pnpsystemsspzoo/Detekcja-i-lokalizacja-zk-ocen-RF/System_centralny_software/frontend_application/services/pdf/screenshot.jpeg

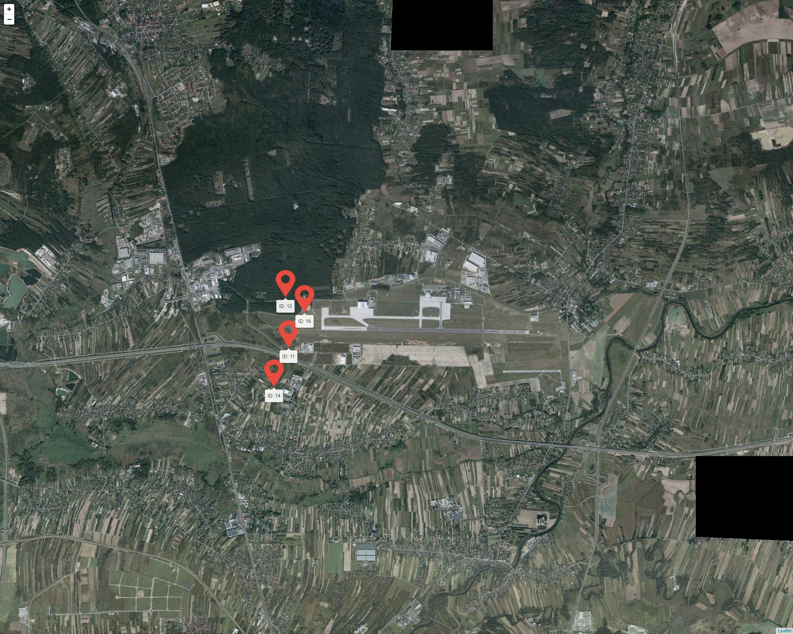
System_centralny_software/frontend_application/services/pdf/screenshot.jpeg
