pnpsystemsspzoo/Detekcja-i-lokalizacja-zk-ocen-RF/Dokumentacja/Etap_2/D_TN_model_sondy.pdf

# System detekcji, monitoringu, lokalizacji i wspomagania eliminacji zakłóceń radiowych w wybranych pasmach częstotliwości (RNSS i telekomunikacyjnych)

współfinansowany ze środków Europejskiego Funduszu Rozwoju Regionalnego realizowanego w ramach Działania 1.1. Projekty B+R przedsiębiorstw Programu Operacyjnego Inteligentny Rozwój 2014-2020

Numer umowy: POIR.01.01.01-00-0894/17

## D_TN_model_sondy

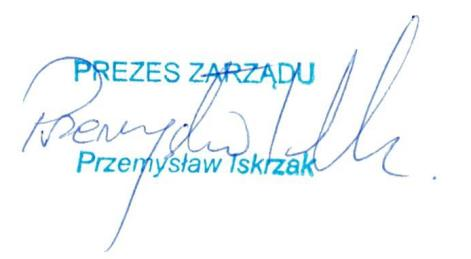
[picture p10: figure]

L.p. | Wersja | Data | Opis
1 | 0.1 | 01.10.2020 | Wersja inicjalna dokumentu
2 | 0.2 | 23.11.2020 | Diagnoza widmowa urządzenia
3 | 0.3 | 11.01.2021 | Poprawki
4 | 1.0 | 14.02.2021 | Poprawki, formatowanie

## Spis treści

Płyta bazowa | 3
OPIS OGÓLNY | 3
KOMUNIKACJA Z MODUŁAMI RADIOWYMI | 4
SEKWENCJA URUCHOMIENIA KOMUNIKACJI PŁYTY BAZOWEJ Z KARTĄ RADIOWĄ | 7
OPTYCZNE TESTY JAKOŚCIOWE | 10
Karty radiowe | 11
KARTA ILS | 12
KARTA TETRA | 16
KARTA L1 | 19

## Płyta bazowa

### Opis ogólny

Płyta bazowa jest komponentem logicznym urządzenia (sondy) zajmującym się przetwarzaniem i danych odebranych z kart radiowych i przesyłaniem danych przetworzonych do systemu centralnego. Płyta bazowa oparta została o procesor FPGA Xilinx model XCZU4CG-1FBVB900E (FPGA z ang. Field Programmable Gate Arrays). Procesor ten zapewnia 16-sto kanałowe połączenia szeregowe bardzo wysokiej przepustowości, wymagane do obsługi przetworników analogowo-cyfrowych (ADC) oraz łącz światłowodowych. Cztery szybkie kanały komunikacyjne (z ang. transceivers) wykorzystane są do obsługi standardu SFP komunikacji światłowodowej, pozostałe służą połączeniom przetworników ADC kart radiowych z procesorem FPGA. Procesor płyty bazowej posiada zintegrowany procesor aplikacyjny produkcji ARM z rodziny Cortex-A53. Procesor ten obsługiwany jest przez system operacyjny Linux i kontroluje komunikację z systemem centralnym, urządzenia peryferyjne, w tym nastawy zegarów referencyjnych, pamięci (RAM, flash), łącza komunikacyjne i serwisowe.

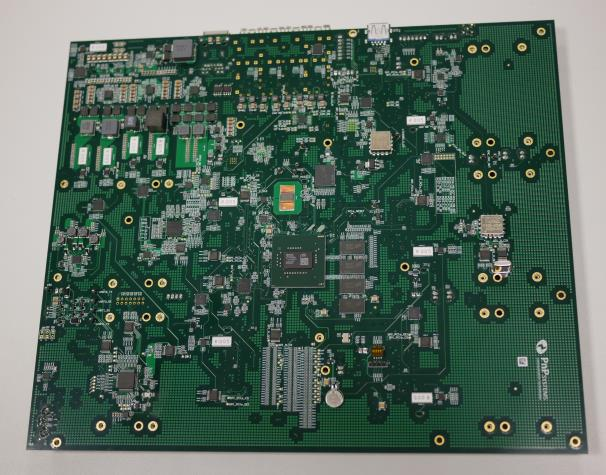
[picture p11: figure]

Rys 1: Płyta bazowa urządzenia do detekcji sygnałów zakłócających. Model demonstracyjny z obsługą dołączanych modułowo kart radiowych.

### Komunikacja z modułami radiowymi

Moduły radiowe sondy łączą się z płytą bazową za pomocą szybkiego protokołu JESD204B. Procesor FPGA płyty bazowej zaprogramowany jest za pomocą logicznego bloku konfigurującego tryb pracy szyny komunikacyjnej procesora do kart radiowych.

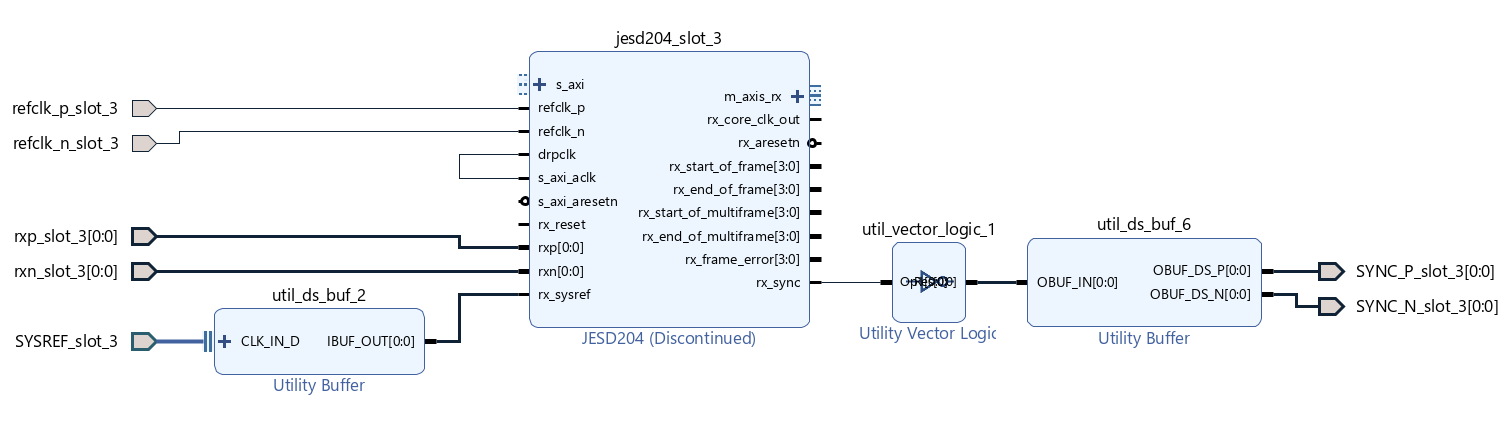
[picture p12: figure]

Rys 2: Blokowy kod procesora FPGA konfigurujący slot komunikacyjny pomiędzy procesorem a kartą radiową.
JESD204B jest trzecią generacją szeregowego interfejsu (po JESD204 i JESD204A) wykorzystywanego do komunikacji między układami logicznymi (FPGA), a przetwornikami (ADC oraz DAC) próbkującymi sygnał z częstotliwościami rzędu kilku GHz. Główne cechy:
- transmisja danych z prędkością do 12,5 Gb/s na każdą linię
- zredukowana ilość linii potrzebnych do przesłania informacji (w porównaniu do LVDS)
- brak konieczności dopasowywania długości linii danych

JEDS204B wykorzystuje kodowanie 8b/10b, co oznacza że w każdym 10-bitowym słowie znajduje się 8 bitów danych oraz 2 bity nadmiarowe. To kodowanie zapewnia, że nawet jeśli próbka składa się z samych "0" lub "1", to w przesyłanym słowie nadal znajduje się wystarczająca liczba przejść umożliwiająca odzyskanie przez odbiornik sygnału zegarowego, w takt którego przesyłane są informacje.
W nowoczesnych przetwornikach ze standardem JESD204B (także w AD9690 wykorzystywanych w MB) możliwe jest ustawienie ilości wykorzystywanych linii danych. Przykładowo: przesłanie 12-bitowej próbki może odbyć się za pośrednictwem jednej linii w formie dwóch 10-bitowych słów wysłanych jedno po drugim. Wybór ten wiąże się z koniecznością dwukrotnie większej szybkości transmisji, aniżeli w przypadku korzystania z 2 linii danych, gdzie oba słowa wysyłane są równolegle. Standard JESD204B zapewnia również możliwość dzielenia próbek na wiele oktetów i linii. Na przykład dwie 12 bitowe próbki mogą zostać przesłane w 3 słowach (3 oktet zawierający po 4 ostatnie bity próbek). Funkcja ta jest bardzo korzystna, gdy używa się przetworników o niższych rozdzielczościach, ale o bardzo wysokich częstotliwościach próbkowania. Dzięki temu możliwe jest maksymalne wykorzystanie linii danych.
Ponadto standard JESD204B wprowadził funkcję taktowania harmonicznego, która eliminuje potrzebę zapewnienia dokładnej częstotliwości sygnału DEVICE CLOCK każdemu urządzeniu w systemie. Oznacza to, że sygnał zegarowy może mieć wielokrotnie większą/mniejszą częstotliwość, która następnie jest dowolnie dzielona (albo mnożona) przez dzielniki znajdujące się wewnątrz układów.

JESD204B zawiera 3 różne podklasy (0, 1, 2), które wpływają na synchronizację układów. Przetworniki wykorzystywane w kartach radiowych (AD9690) wspierają 1 podklasę co oznacza, że do prawidłowej komunikacji konieczne są następujące połączenia: CLK, DATA, SYNC~ oraz SYSREF.
Podklasa 1 umożliwia wprowadzenie zdeterminowanego opóźnienia. Jest to czas jaki upływa od propagacji danych w przetworniku ADC do momentu pobrania próbek z bufora w układzie FPGA. Odbywa się to za pomocą sygnału SYSREF, który resetuje wszystkie wewnętrzne bloki w przetwornikach do znanego stanu. Dzięki temu wszystkie układy rozpoczynają pracę jednocześnie (ich wewnętrzne zegary są wyrównane w fazie). Aby to osiągnąć wymagane jest dopasowanie długości wszystkich linii SYSREF orac CLK, tak aby były jednakowe dla każdego układu. Przetworniki AD9690 umożliwiają ustawienie opóźnienia przybycia impulsu SYSREF jak i CLK, dzięki czemu zachowanie jednakowych długości linii nie jest konieczne. Warto zauważyć, że sygnał SYSREF powinien być pojedynczym impulsem lub przebiegiem okresowym. W przypadku tego drugiego, jego częstotliwość musi być całkowitą wielokrotnością sygnału LMFC (local multi-frame clock). Zaleca się, aby sygnał SYSREF był wyłączany po udanej synchronizacji, wtedy w przypadku ponownej utraty wyrównania linii (np. na skutek zmian temperatury), SYSREF jest ponownie uruchamiany.

Rys 3: Logiczny rozkład struktury informacji przesyłanej łączem z protokołem JESD204B

Kolejnym elementem umożliwiającym osiągnięcie deterministycznego opóźnienia jest "elastyczny bufor". Elastyczne bufory znajdują się w urządzeniach odbierających dane (FPGA albo DAC). Dzięki nim możliwe jest ustawienie momentu zwolnienia próbek przechowywanych w buforach. Moment ten jest ustawiany tak, aby nastąpił po dodarciu danych ze wszystkich linii (ze względu na różne długości linii danych, przesyłane informacje docierają w różnych momentach). W przypadku konieczności jednoczesnego opóźnienia dla kilku urządzeń, moment zwolnienia ustawiany jest względem układu, od którego próbki przyszły jako ostatnie.
W przypadku większych odległości (powyżej 20cm) między ADC a FBGA, sygnały ulegają zniekształceniom, które uniemożliwiają ich odczytanie. Aby temu zapobiec układy AD9690 posiadają funkcję "De-Emphasis", która polepsza parametry sygnału kosztem większego poboru mocy oraz większej emisji EMI. "De-Emphasis" należy używać tylko wtedy, gdy układ RX nie jest w stanie odczytać danych.

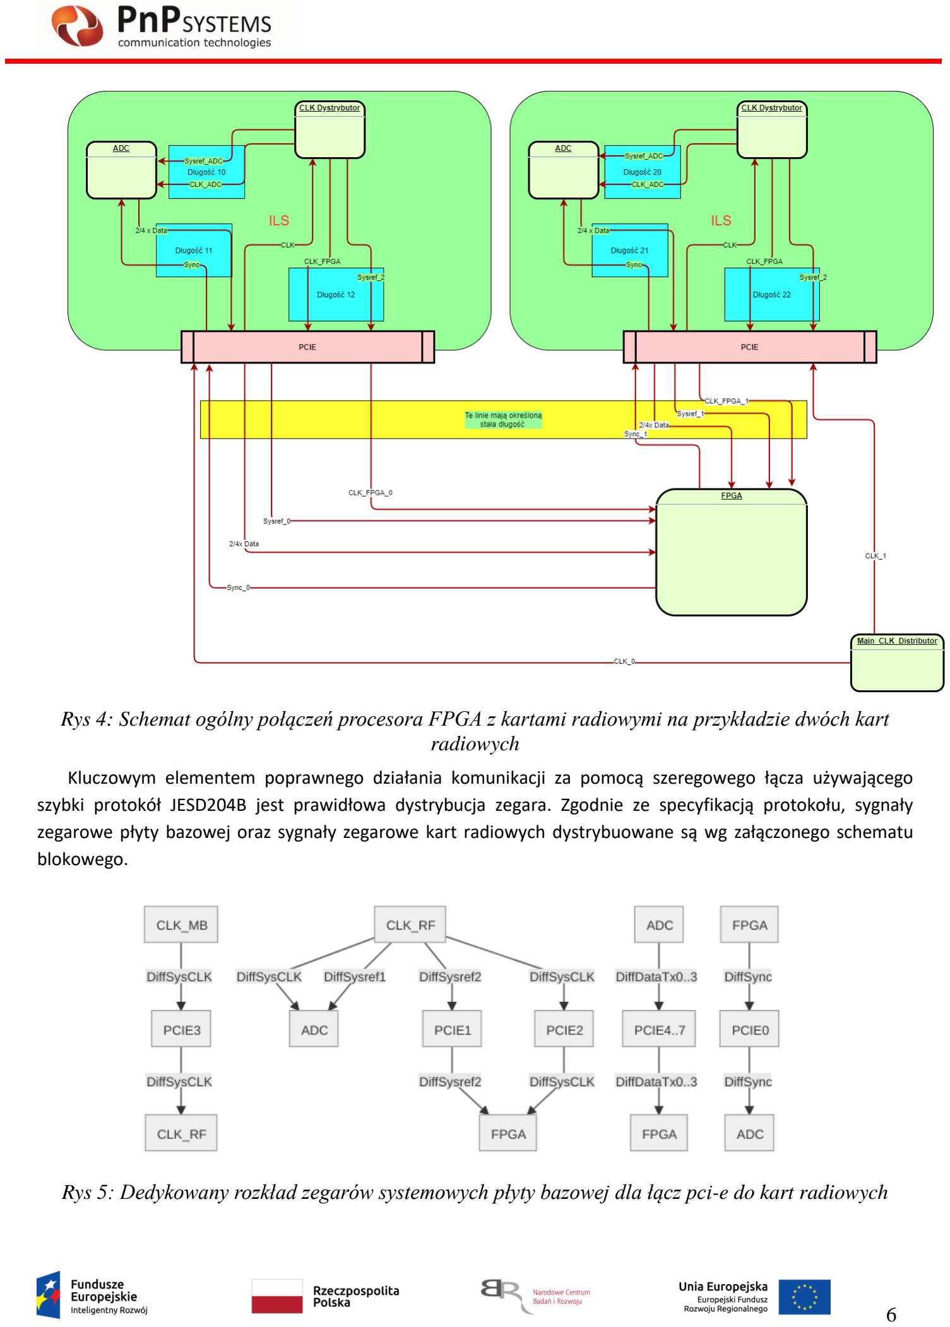
[picture p13: page 6]

Rys 4: Schemat ogólny połączeń procesora FPGA z kartami radiowymi na przykładzie dwóch kart radiowych
Kluczowym elementem poprawnego działania komunikacji za pomocą szeregowego łącza używającego szybki protokół JESD204B jest prawidłowa dystrybucja zegara. Zgodnie ze specyfikacją protokołu, sygnały zegarowe płyty bazowej oraz sygnały zegarowe kart radiowych dystrybuowane są wg załączonego schematu blokowego.

Rys 5: Dedykowany rozkład zegarów systemowych płyty bazowej dla łącz pci-e do kart radiowych

### Sekwencja uruchomienia komunikacji płyty bazowej z kartą radiową

Procesor Xilinx podlega zaprogramowaniu, zarówno na poziomie procesora aplikacyjnego, jak i procesora FPGA. Aby uzyskać prawidłowy przebieg sygnałów pomiędzy przetwornikami kart radiowych a procesorem Xilinx, należy przeprowadzić odpowiednią sekwencję uruchomiania procesora. Z zalecanych sposobów uruchomienia wybrany został ten, którego schemat przebiegu sekwencji przedstawiony jest poniżej.

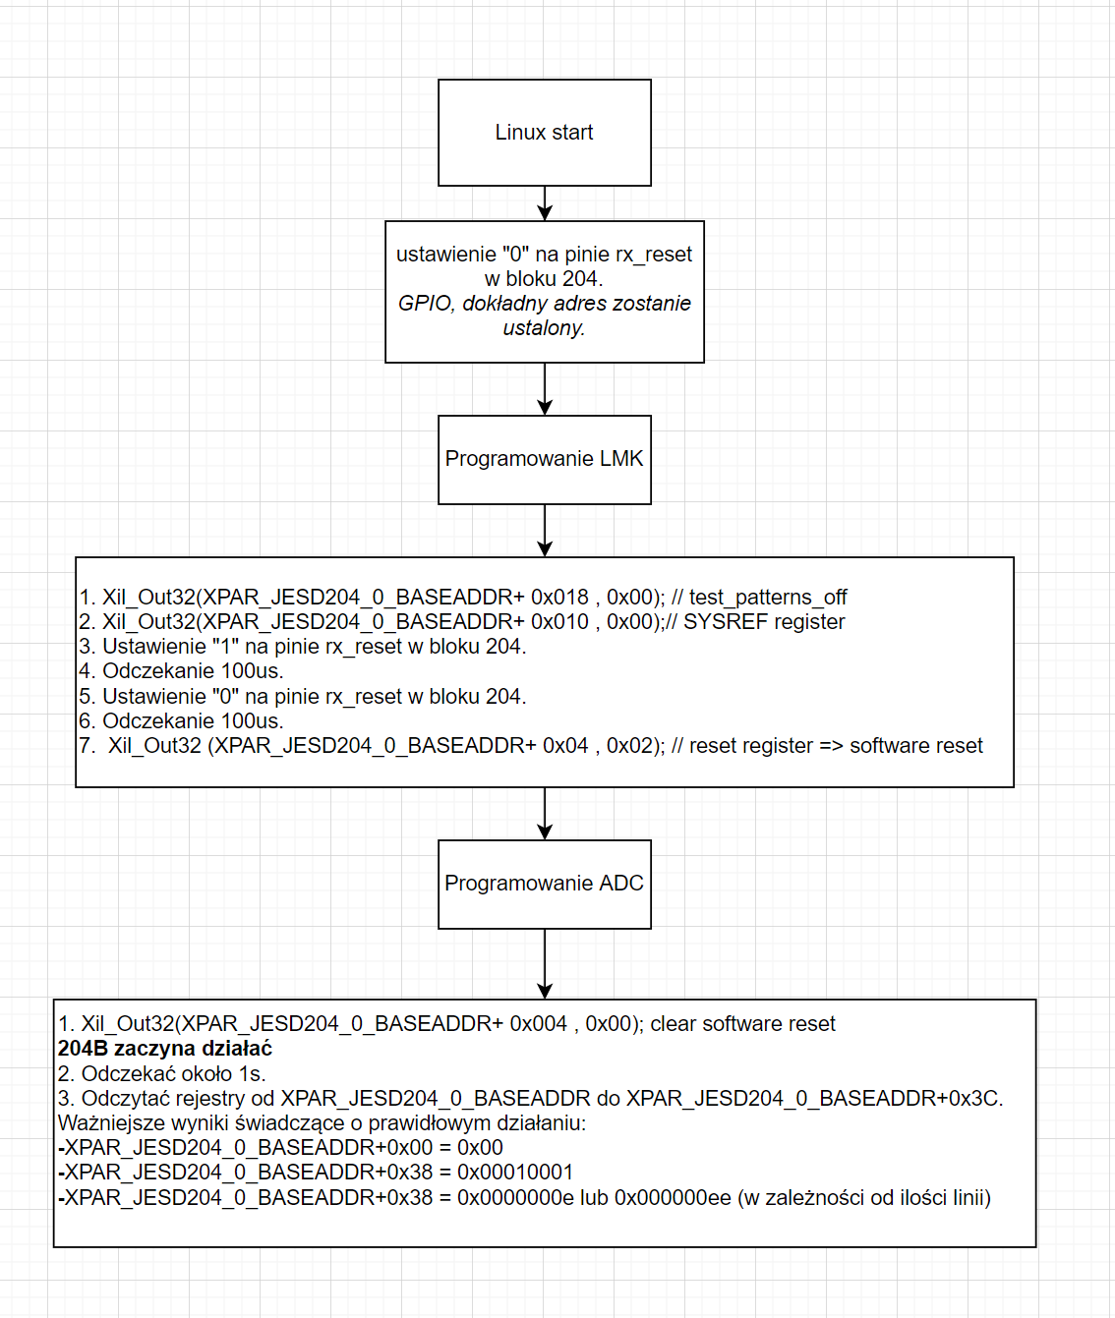
[picture p14: figure]

Rys 6: Schemat sekwencji uruchomiania łącza z protokołem JESD204B pomiędzy procesorem Xilinx a kartami radiowymi.
Parametry wpływające na częstotliwości poszczególnych linii:

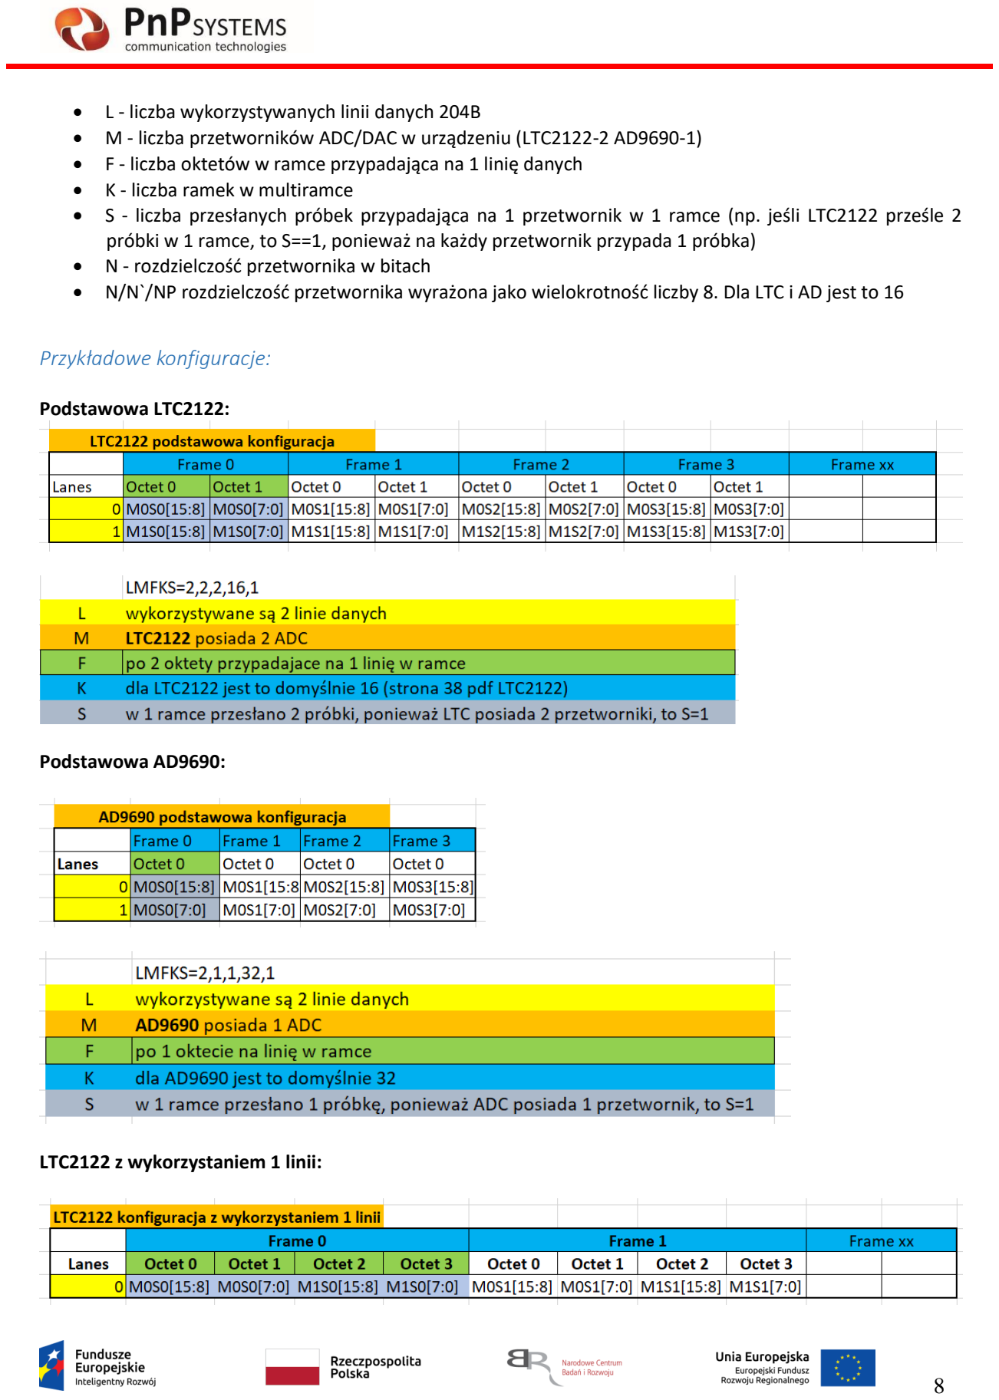
[picture p15: page 8]

- L - liczba wykorzystywanych linii danych 204B
- M - liczba przetworników ADC/DAC w urządzeniu (LTC2122-2 AD9690-1)
- F - liczba oktetów w ramce przypadająca na 1 linię danych
- K - liczba ramek w multiramce
- S - liczba przesłanych próbek przypadająca na 1 przetwornik w 1 ramce (np. jeśli LTC2122 prześle 2 próbki w 1 ramce, to S==1, ponieważ na każdy przetwornik przypada 1 próbka)
- N - rozdzielczość przetwornika w bitach
- N/N`/NP rozdzielczość przetwornika wyrażona jako wielokrotność liczby 8. Dla LTC i AD jest to 16

Przykładowe konfiguracje:

Podstawowa LTC2122:

Podstawowa AD9690:

LTC2122 z wykorzystaniem 1 linii:

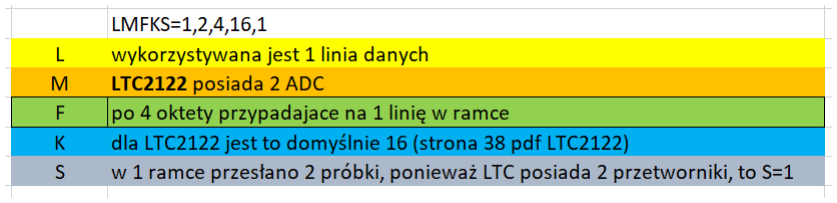
[picture p16: figure]

Częstotliwości poszczególnych zegarów
Nastawy częstotliwości poszczególnych zegarów są parametryzowane, tzn. częstotliwości te zależą, oprócz wcześniej wymienionych parametrów L, M, F, S, i K, od takich parametrów, jak: częstotliwość próbkowania fs, liczbę f oktetów w ramce przypadających na jedną linię danych, oraz współczynnik ograniczenia SYSREFmax. Przykładowe nastawy wyliczane są wg podanego zestawu wzorów, prezentowanych poniżej. Obliczenia przeprowadzono dla AD9690 w konfiguracji LMFKS= 2,1,1,32,1 o częstotliwości próbkowania 500MHz
- wyznaczenie frame clock`a

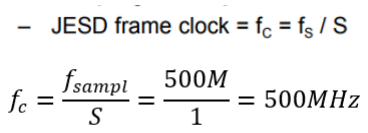
[picture p17: figure]

- wyznaczenie Lane Rate, litera f oznacza liczbę oktetów w ramce przypadająca na 1 linię danych.
- wyznaczenie LMFC (local multiframe clock)
- wyznaczenie SYSREF`a na ten sygnał nałożone są następujące ograniczenia:

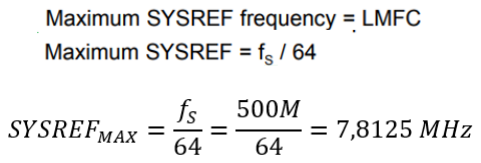
[picture p18: figure]

Dla optymalnej pracy zalecane jest zmniejszenie często z następującego wzoru:

gdzie LCM to najmniejsza wspólna wielokrotność liczby 64 oraz 20K. W przypadku AD9690 LCM(64,2032)=640

### Optyczne testy jakościowe

Przed uruchomieniem płyty bazowej przeprowadzono testy optyczne, których wynik końcowy był pozytywny. Testy przeprowadzone przy pomocy kamery z regulowanym powiększeniem optycznym. Punkty lutowania wymagające dokładnego sprawdzenia prezentowane są poniżej;

Układ ADP1850 | zewnętrzne części padów nie są oblane cyną; poprawiono

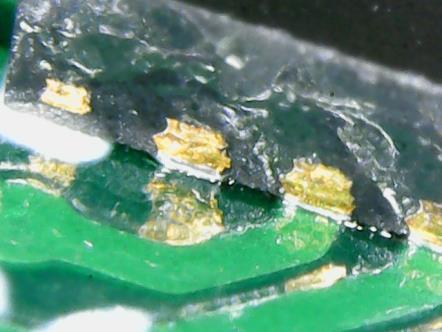
[picture p19: figure]

Układ ADP1741 | zewnętrzne części padów nie są oblane cyną; poprawiono

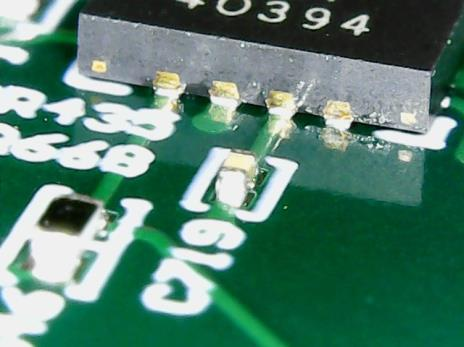
[picture p20: figure]

Układ MCP1727P | zewnętrzne części padów nie są oblane cyną; poprawiono

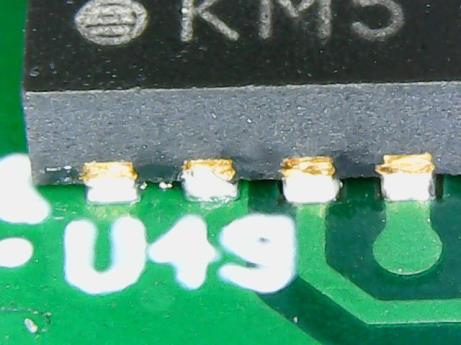
[picture p21: figure]

Układ LTC6952 | układ uniósł się na cynie wylanej pod układem; poprawiono

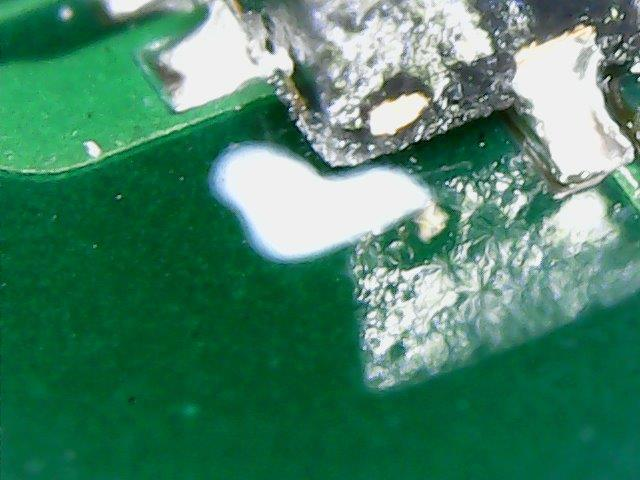
[picture p22: figure]

Układ max17557 | układ uniósł się na cynie wylanej pod układem; poprawiono

## Karty radiowe

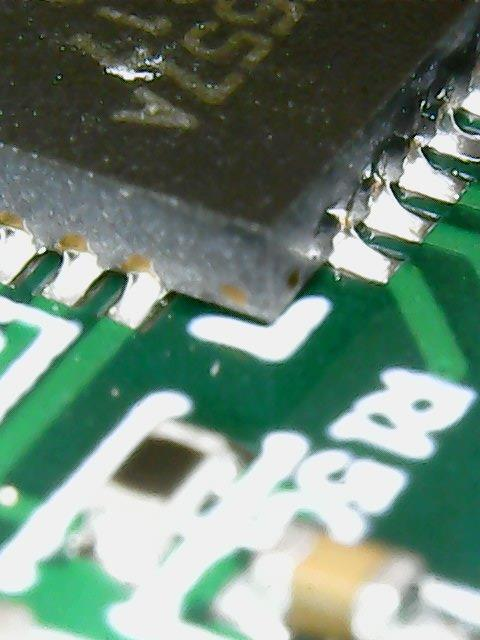
[picture p23: figure]

Karty radiowe przygotowane zostały do odbierania czterech wybranych pasm radiowych przydzielonych trzem systemom radiowym: ILS na częstotliwościach nośnej 110 MHz i 333 MHz, TETRA na 440 MHz oraz GNSS L1 na częstotliwości nośnej 1575,42 MHz. Przydzielone tym torom filtry posiadają bardzo wysoki stopień dobroci, przez co bardzo tłumią moce na częstotliwościach pozapasmowych. Zapewnia to znakomitą separację od pasma pobocznych i zapobiega wnikaniu dodatkowej mocy, mogącej zakłócić proces detekcji zakłócenia.

Tabela 1: Tłumienia filtrów w torach radiowych kart sondy

pasmo | system | Tłumienie w torze | Tłumienie poza torem
108 – 112 MHz | ILS | 6,8 dB | 38 dB
283 – 383 MHz | ILS | 11 dB | 43 dB
410 – 430 MHz | TETRA | 3 dB | 40 dB
1530 – 1610 MHz | GNSS L1 | 3,6 dB | 24 dB

Zaprojektowane karty radiowe mają ten sam interfejs do płyty bazowej oraz te same protokoły komunikacyjne. Różnicą jest dopasowanie toru radiowego do poszczególnych częstotliwości nośnych, przetworniki dopasowane do różnych szerokości pasma oraz konfiguracja ustawień płyty radiowej. Poniższe zdjęcie prezentuje karty.

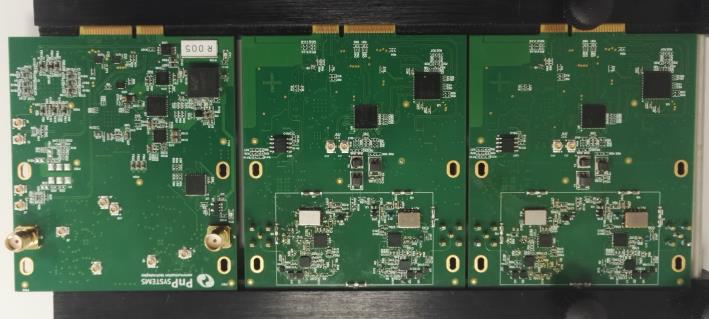
[picture p24: figure]

Rys 7: Rodzina kart radiowych w wersji poprawionej, zunifikowanej pod kątem połączenia z płytą bazową

### Karta ILS

Karta ILS posiada obsługę dwóch częstotliwości, 110 MHz i 333 MHz.
Tor radiowy dla systemu ILS zaprojektowany został tak aby możliwe było przetwarzanie sygnału przez przetwornika ADC.
Kluczowe parametry dla których został zaprojektowany tor ILS 110 MHz to:
- maksymalna moc dopuszczalna na ADC,
- punkt kompresji dla każdego z elementów toru,
- selektywność.

Ograniczenia mocy na torze dopasowywane są za pomocą elementów o stałych parametrach ( diody PIN ) oraz zmiennych parametrach (tłumik ACG).

Schemat blokowy
Schemat blokowy przedstawiony poniżej składowe elementy tory radiowego 110 MHz.

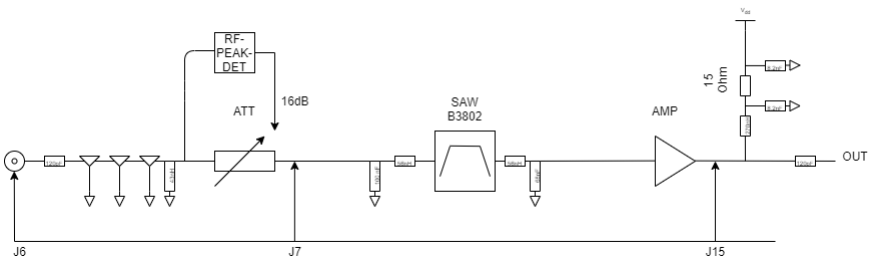
[picture p25: figure]

Rys 8: Schemat blokowy toru radiowego 110 MHz

Bardzo podobny jest tor radiowy dla częstotliwości 333 MHz.

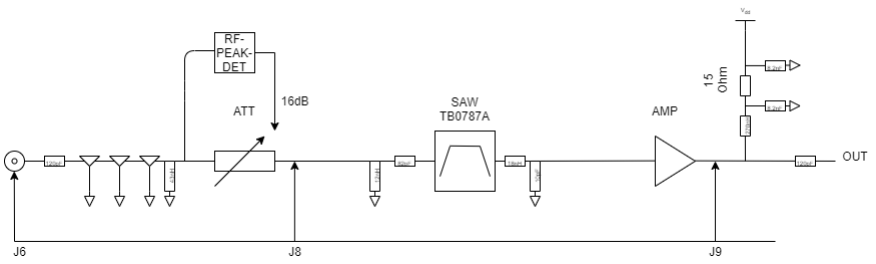
[picture p26: figure]

Rys 9: Schemat blokowy toru radiowego 333 MHz

Aby umożliwić prawidłową pracę tej karty radiowej, następujące ustawienia zegarów dla protokołu JESD204B powinny być ustawione
Dobranie odpowiedniej częstotliwości dla ADC oraz FPGA wiąże się z uwzględnieniem zakresów częstotliwości dostępnych dla ADC, FPGA oraz częstotliwości dla których w przetwarzanym sygnale nie pojawią się zakłócenia związane ze składowymi wyższych harmonicznych.
Na poniższym zrzucie ekranu przedstawiono prawidłowe ustawienia transmisji sygnału dla protokołu JESD204B z wybranym przetwornikiem LTC2122 (fc-max = 170 MHz) oraz FPGA gdzie częstotliwość CLK musi być większy niż Fc/2 (większy niż 80MHz).

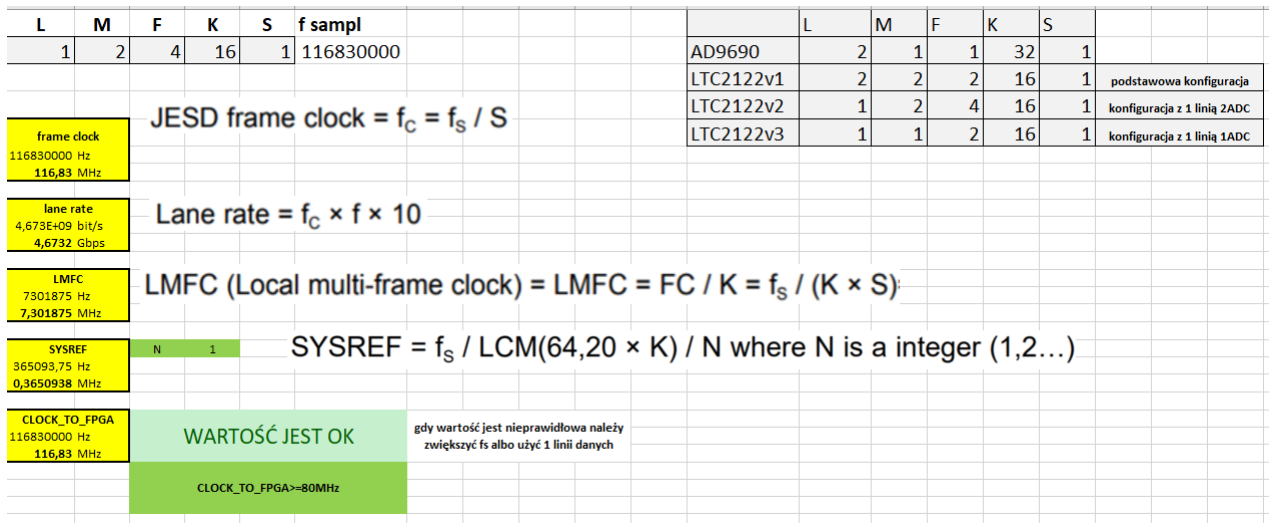
[picture p27: figure]

Rys 10: Kalkulator przeliczeń wartości częstotliwości poszczególnych linii przetworników. Ustawienia dla tej konfiguracji to:

- L(liczba torów danych) - 1;
- M(liczba wewnętrznych przetworników LTC2122) - 2;
- F(liczba oktetów w ramce na jedną linie danych) - 4;
- K(liczba ramek w mulitramce) - 16;
- S(liczba przesłanych próbek przypadająca na 1 przetwornik w 1 ramce) - 1;

Z poniższych zależności ustalono częstotliwość Fs (Fc) dla LTC2122 - 116,30 MHz. Pozwoli ona obsłużyć dwa wejścia analogowe w konfiguracji dla przetwarzania częstotliwości RF 110 MHz oraz 330 MHz.
Sysref powinien mieć wartość 0,36509 MHz.
Zegar CLK (dla protokołu JESD204B) powinien mieć wartość 116,3 MHz. Jest to częstotliwość minimalna, wobec czego należy mieć na uwadze zmianę konfiguracji systemu w przypadku gdyby protokół JESD204B nie działał prawidłowo.
Według wymagań układów dla JESD204b oraz prawidłowego próbkowania ADC, na dystrybutorze ustawiono następujące częstotliwości:
1. Wyjście testowe - częstotliwość testowa 0,5 MHz - wyłączona
2. Wyjście SYSREF dla FPGA - 0,36509 MHz
3. Wyjście CLK dla FPGA - 116,3 MHz
4. Wyjście SYSREF dla ADC - 0,36509 MHz
5. Wyjście CLK dla ADC - 116,3 MHz

LMK04610 skonfigurowany został w trybie z drugą pętlą PLL oraz bez lokalnego oscylatora.
Sygnał wejściowy zadawany ze płyty macierzystej (domyślnie MB lub ZCU) powinien być generowany o częstotliwości 62,5 MHz o wypełnieniu 50% w trybie differential.

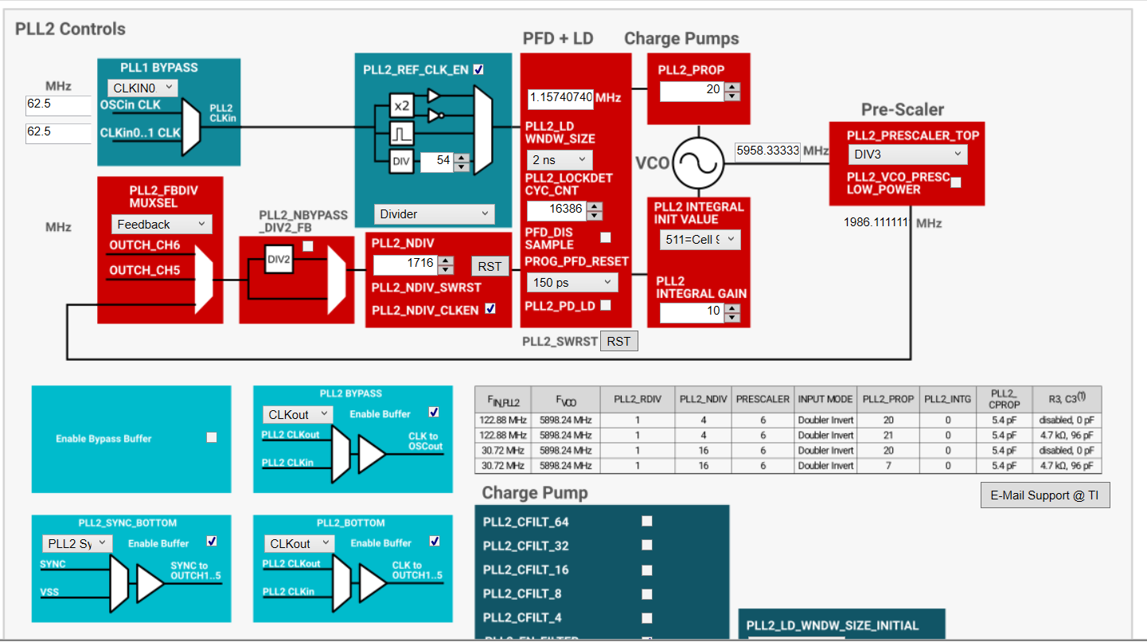
[picture p28: figure]

Rys 11: Konfigurator częstotliwości zegara dystrybutora LMK04610 Ustawienia te pozwalają przy ustawieniach LTC2122 ( L=1,M=2,F=4,K=16,S=1) uzyskać przepustowość linii danych LTC2122 na poziomie 4,6756 Gbps.
Ustawienia wyjść w TICS Pro:
- CLKOUT1 Test - 0,5 MHz - wyłączone
- CLKOUT3 SYSREF FPGA - 0,36509 MHz
- CLKOUT5 INV CLK FPGA - 116,83 MHz
- CLKOUT8 INV SYSREF ADC - 0,36509 MHz
- CLKOUT10 CLK ADC - 116,83 MHz
Nie używane wyjścia należy ustawić w tryb Power-Down, tak aby jak najbardziej zminimalizować pobór energii oraz przenoszenie zakłóceń.
Obliczenia częstotliwości harmonicznych
Aby przetwornik cyfrowo-analogowy nie wtrącał częstotliwości harmonicznych spoza pasma, co może zachodzić przy filtrze zbyt szeroko-pasmowym w stosunku do pasma użytecznego, przeanalizowano możliwe częstotliwości pracy przetwornika na częstotliwościach 110 MHz i 333 MHz. Z poniższych obliczeń pobrane były wartości częstotliwości pracy przetworników.
W przypadku toru dla 110 MHz, ustawienie częstotliwości ADC na 116,89 MHz powoduje, że żadna harmoniczna poniżej 10-tej nie zostanie wtrącona do pasma przepustowego filtra. Obrazuje to kalkulator na kolejnym rysunku.

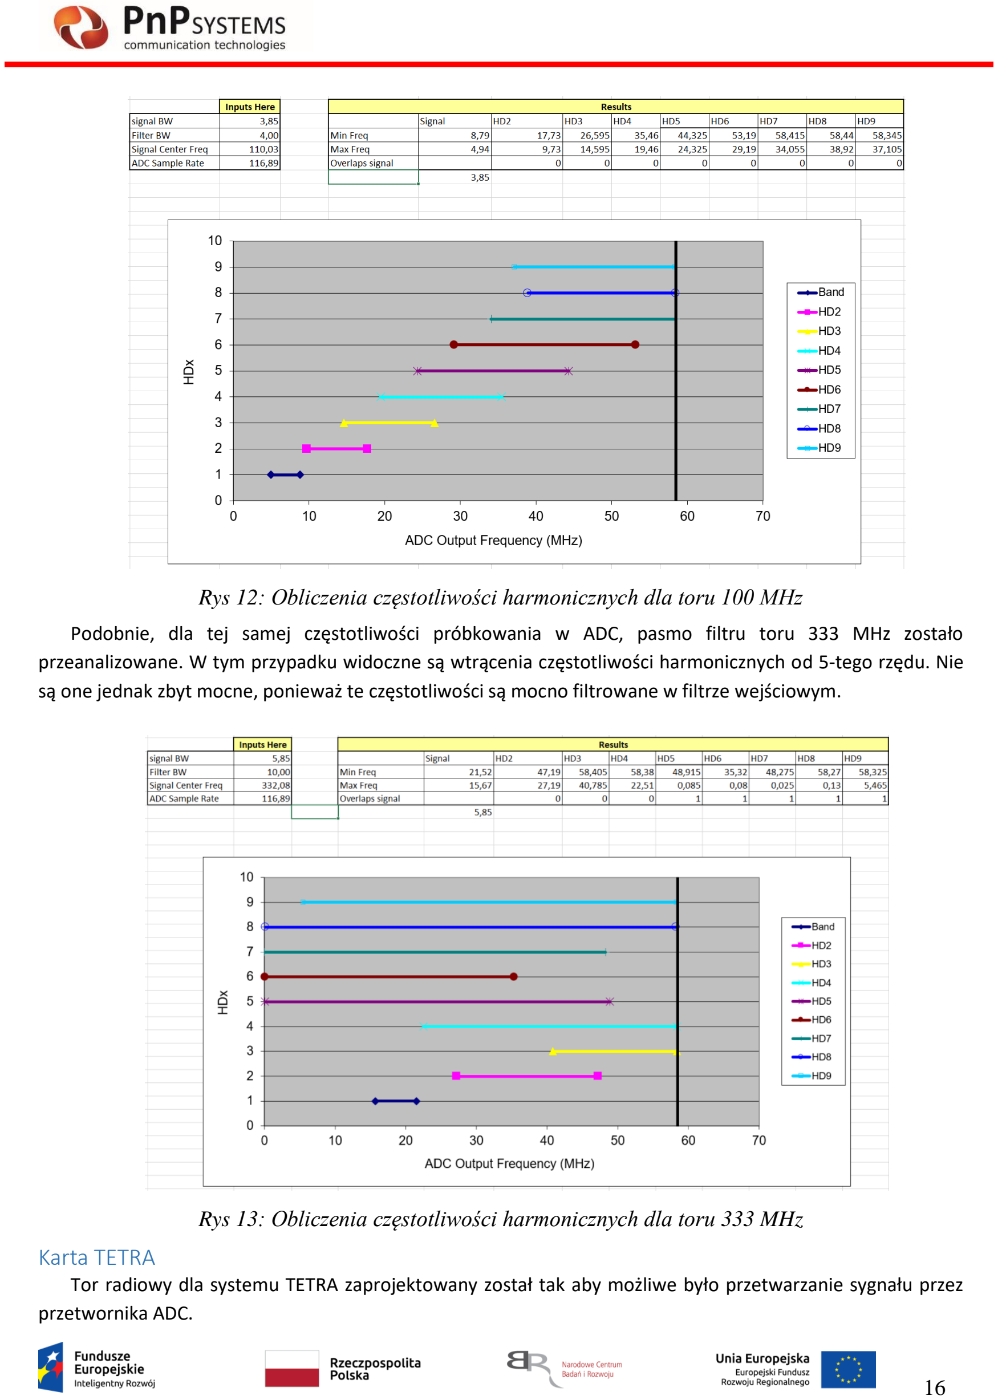
[picture p29: page 16]

Rys 12: Obliczenia częstotliwości harmonicznych dla toru 100 MHz Podobnie, dla tej samej częstotliwości próbkowania w ADC, pasmo filtru toru 333 MHz zostało przeanalizowane. W tym przypadku widoczne są wtrącenia częstotliwości harmonicznych od 5-tego rzędu. Nie są one jednak zbyt mocne, ponieważ te częstotliwości są mocno filtrowane w filtrze wejściowym.

Rys 13: Obliczenia częstotliwości harmonicznych dla toru 333 MHz

### Karta TETRA

Tor radiowy dla systemu TETRA zaprojektowany został tak aby możliwe było przetwarzanie sygnału przez przetwornika ADC.

Kluczowe parametry dla których został zaprojektowany tor TETRA 420 MHz to:
- maksymalna moc dopuszczalna na ADC,
- punkt kompresji dla każdego z elementów toru,
- selektywność.

Ograniczenia mocy na torze dopasowywane są za pomocą elementów o stałych parametrach ( diody PIN ) oraz zmiennych parametrach (tłumik ACG).

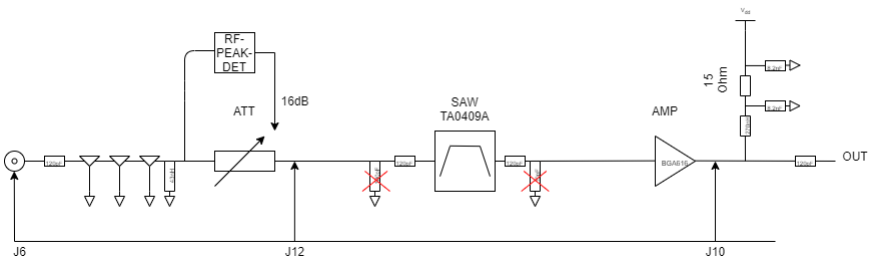
[picture p30: figure]

Rys 14: Schemat blokowy toru radiowego 420 MHz

Podobnie, jak dla torów karty na pasma ILS, konstrukcja toru radiowego z dystrybutorem LMK04610 została przeanalizowana pod kątem odbioru sygnałów harmonicznych.
Ustawienia zostały przygotowane poprzez program TICS Pro od TI.
Wymagania odnośnie częstotliwości dla ADC. Optymalne ustawienie oraz wpływ harmonicznych przedstawiono poniżej.

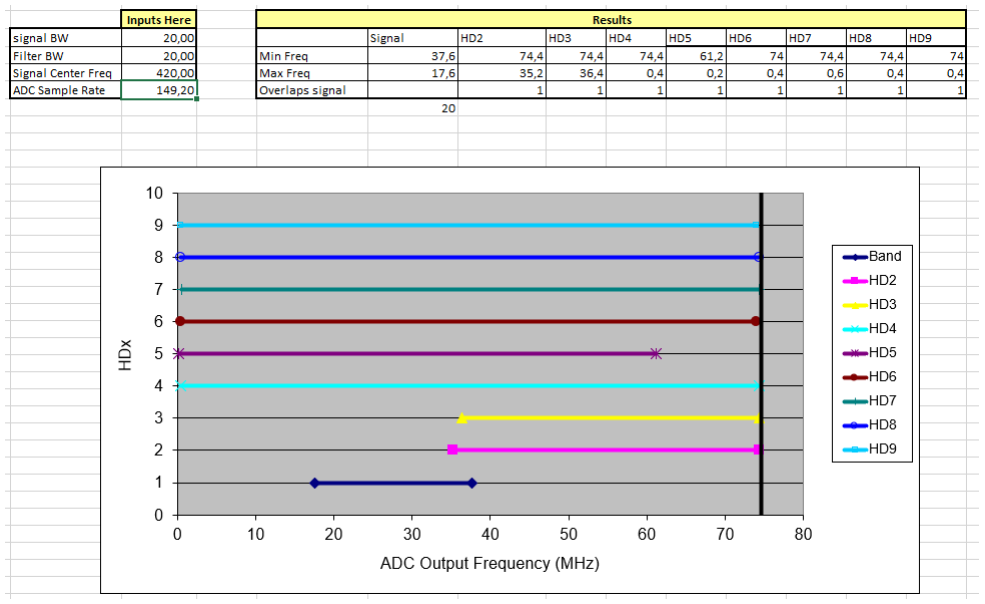
[picture p31: figure]

Rys 15: Obliczenia częstotliwości harmonicznych dla toru 420 MHz

Dla dobranego filtra, udało się niemal wszystkie harmoniczne, do rzędu 3-ciego włącznie, wyeliminować z pasma użytecznego.
Ustawienia zegarów dla protokołu JESD204B
Dobranie odpowiedniej częstotliwości dla ADC oraz FPGA wiąże się z uwzględnieniem zakresów częstotliwości dostępnych dla ADC, FPGA oraz częstotliwości dla których w przetwarzanym sygnale nie pojawią się zakłócenia związane ze składowymi wyższych harmonicznych.
Na poniższym zrzucie ekranu przedstawiono prawidłowe ustawienia transmisji sygnału dla protokołu JESD204B z wybranym przetwornikiem LTC2122 (fc-max = 170 MHz) oraz FPGA gdzie częstotliwość CLK musi być większy niż Fc/2 (większy niż 80MHz).

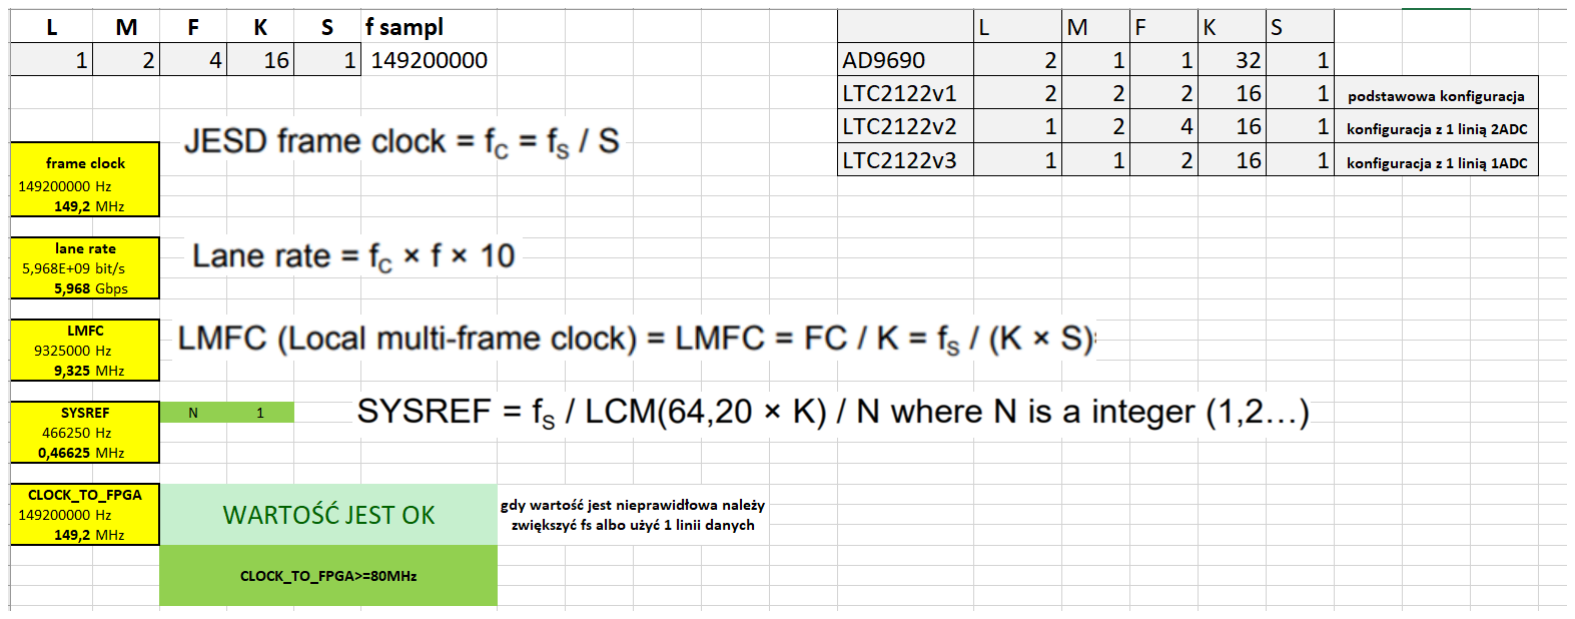
[picture p32: figure]

Rys 16: Kalkulacje wartości częstotliwości poszczególnych linii przetwornikóww dla karty radiowej na pasmo 420 MHz
Ustawienia dla tej konfiguracji to:
- L(liczba torów danych) - 1;
- M(liczba wewnętrznych przetworników LTC2122) - 2;
- F(liczba oktetów w ramce na jedną linie danych) - 4;
- K(liczba ramek w mulitramce) - 16;
- S(liczba przesłanych próbek przypadająca na 1 przetwornik w 1 ramce) - 1;

Według wymagań układów dla JESD204b oraz prawidłowego próbkowania ADC, na dystrybutorze ustawiono następujące częstotliwości:
- Wyjście testowe - częstotliwość testowa 19,2 MHz
- Wyjście SYSREF dla FPGA - 0,46625 MHz
- Wyjście CLK dla FPGA - 149,2 MHz
- Wyjście SYSREF dla ADC - 0,46625 MHz
- Wyjście CK dla ADC - 149,2 MHz

Ustawienia te pozwalają przy ustawieniach LTC2122 ( L=1,M=2,F=4,K=16,S=1) uzyskać przepustowość linii danych LTC2122 na poziomie 5,968 Gbps.
LMK04610 skonfigurowany został w trybie z drugą pętlą PLL oraz bez lokalnego oscylatora.

Sygnał wejściowy zadawany ze płyty macierzystej (domyślnie MB lub ZCU) powinien być generowany o częstotliwości 62,5 MHz o wypełnieniu 50% w trybie differential.

### Karta L1

Schemat blokowy i zasady działania karty radiowej na paśmie L1 jest bardzo zbliżona do tych, prezentowanych dla torów ILS i TETRA.
W przypadku toru pasma L1 na częstotliwości 1575,42 MHz, ustawienie częstotliwości ADC na 496,3 MHz, filtru i danym paśmie przepustowości, osiągnięto również niemal sygnał wolny od harmonicznych powyżej stopnia 3-ego.

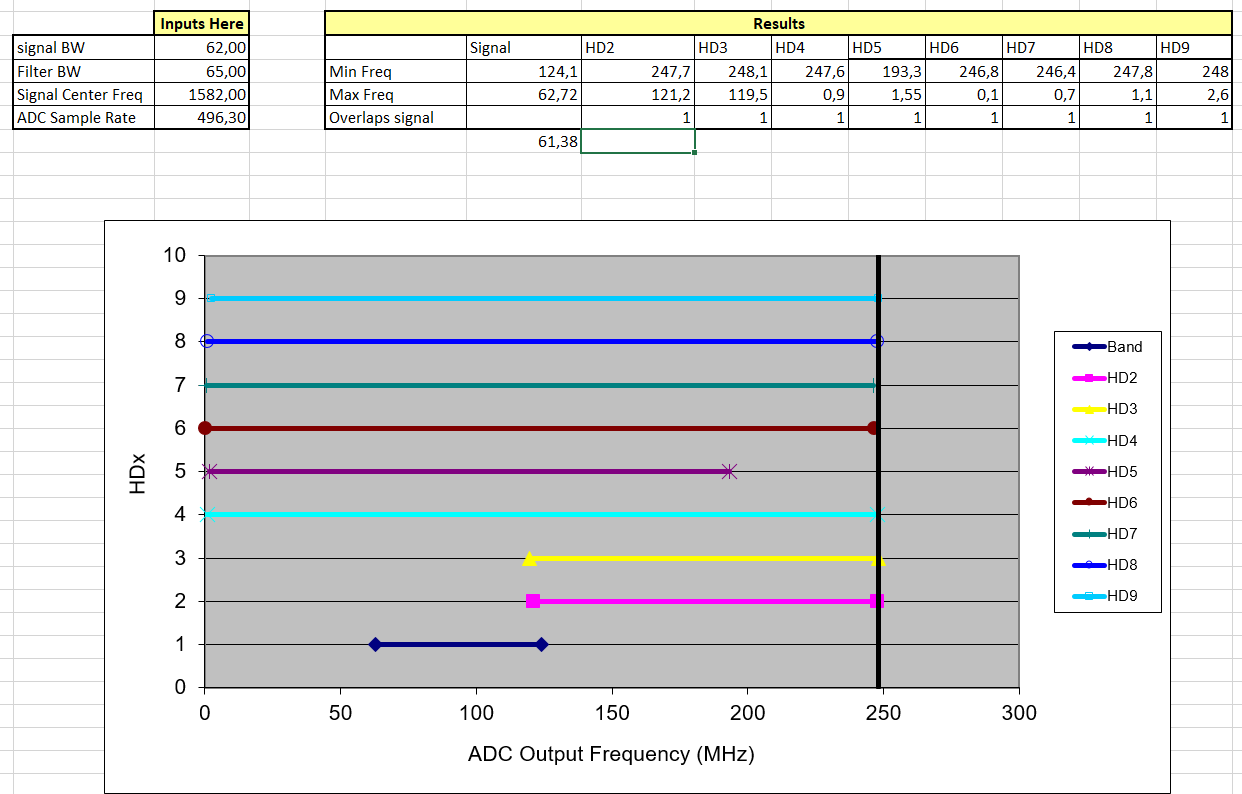
[picture p33: figure]

Rys 17: Obliczenia częstotliwości harmonicznych dla toru 1575,42 MHz

Należy podkreślić, że urządzenie jest programowalne z trybu serwisanta sondy. Zatem, jeśli przyjdzie taka potrzeba, będzie możliwość przeprogramowania urządzenia w ramach specyfikacji sprzętowych.

Koniec dokumentu
