pnpsystemsspzoo/Detekcja-i-lokalizacja-zk-ocen-RF/Sonda_hardware/Karta_GNSS_L1/LTC6952 napięcia.PNG

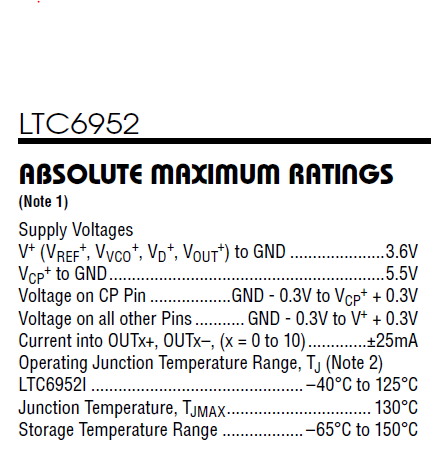
Sonda_hardware/Karta_GNSS_L1/LTC6952 napięcia.PNG
