pnpsystemsspzoo/Detekcja-i-lokalizacja-zk-ocen-RF/System_centralny_software/frontend_application/screenshoterror.jpg

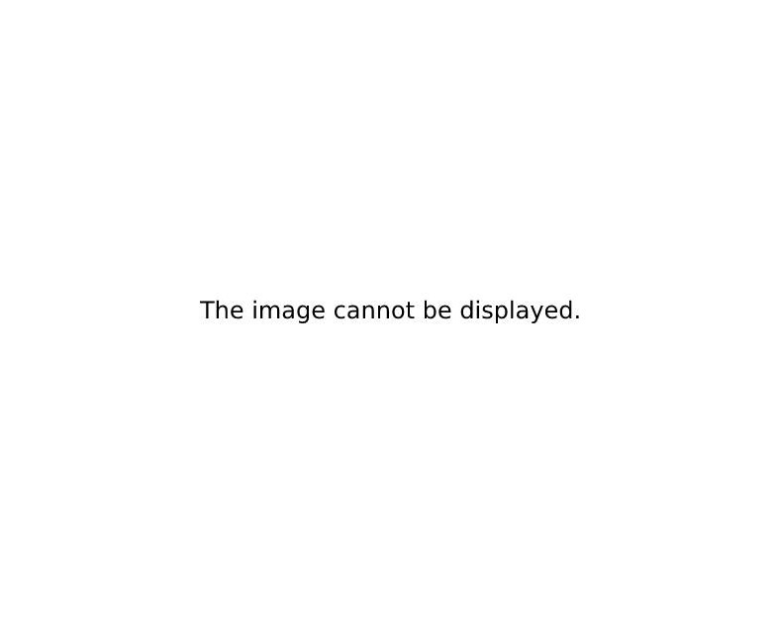
System_centralny_software/frontend_application/screenshoterror.jpg
