pnpsystemsspzoo/Detekcja-i-lokalizacja-zk-ocen-RF/System_centralny_software/frontend_application/source/src/assets/checked.png

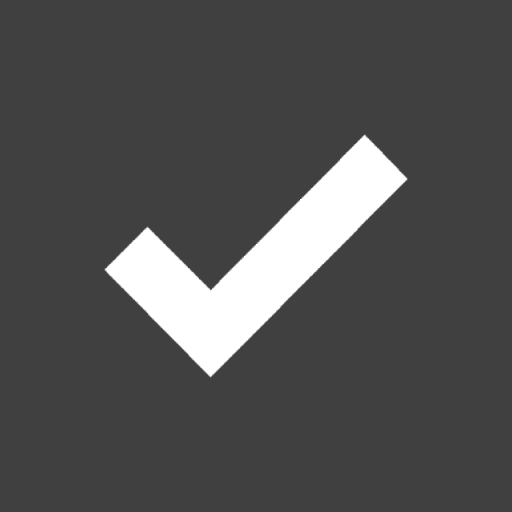
System_centralny_software/frontend_application/source/src/assets/checked.png
