pnpsystemsspzoo/Detekcja-i-lokalizacja-zk-ocen-RF/Dane_badawcze/Sonda_testy/Testy_MB1.xlsx

Sheet: MB1
**Lp.** | **Opis zagadnienia** | **Wynik** | **ilość godzin** | **Szacowana data zakończenia testów** | **Data zakończenia testów** | dodatkowe godziny | dni | dni dodatkowe | suma | data zakończenia | dni programistów
1 | [ Optyczny test ułożenia układów](Struktura-testowania-sprzętu/Test-optyczny-MB1_T1) | {+ OK +} | 08e | 2020-12-29 | 2020-12-29 | 8 | 1 | 1 | 2 | 2020-12-29 | 0 | 2021-01-02
2 | [Pomiar rezystancji torów zasilających](Struktura-testowania-sprzętu/Pomiar-rezystancji-torów-zasilających-MB1) | {- BŁĄD -} | 24e | 2021-01-07 | 2021-01-07 | 32 | 3 | 4 | 7 | 2021-01-07 | 0 | 2021-01-02
3 | [Testy konfiguracji przetwornic zasilających](Struktura-testowania-sprzętu/Pomiary-rezystor%C3%B3w-przetwornic-MB1) | b.d. | 32e | 2021-01-13 |  |  | 4 | 0 | 4 | 2021-01-13 | 0 | 2021-01-02
4 | [Pomiary napięć i prądów zasilających, niezależnych](Struktura-testowania-sprzętu/Pomiary-napięć-i-prądów-MB1) | b.d. | 32e + 40p | 2021-01-19 |  |  | 4 | 0 | 4 | 2021-01-19 | 5 | 2021-01-08
5 | [Pomiary konfiguracji torów zasilających](Struktura-testowania-sprzętu/Pomiary-konfiguracji-zasilania-MB1) | b.d. | 08e | 2021-01-20 |  |  | 1 | 0 | 1 | 2021-01-20 | 0 | 2021-01-08
6 | Testy komunikacji z procesorem US+ | b.d. | 40e + {- 120p -} | 2021-01-27 |  |  | 5 | 0 | 5 | 2021-01-27 | 15 | 2021-01-29
7 | Testy komunikacji I2C | b.d. | 32e + 40p | 2021-02-02 |  |  | 4 | 0 | 4 | 2021-02-02 | 5 | 2021-02-05
8 | Pomiary napięć i prądów zasilających, zależnych | b.d. | 16e + 24p | 2021-02-04 |  |  | 2 | 0 | 2 | 2021-02-04 | 3 | 2021-02-10
9 | Pomiary napięć i prądów zasilających niezależnych pod obciążeniem częściowym | b.d. | 16e + 8p | 2021-02-08 |  |  | 2 | 0 | 2 | 2021-02-08 | 1 | 2021-02-11
10 | Testy komunikacji SPI | b.d. | 32e + 32p | 2021-02-12 |  |  | 4 | 0 | 4 | 2021-02-12 | 4 | 2021-02-17
11 | Pomiary dystrybucji zegarów | b.d. | 24e + 16p | 2021-02-17 |  |  | 3 | 0 | 3 | 2021-02-17 | 2 | 2021-02-19
12 | Obsługa pozostałych urządzeń peryferyjnych na komunikacjach SPI oraz I2C | b.d. | 32e + 40p | 2021-02-23 |  |  | 4 | 0 | 4 | 2021-02-23 | 5 | 2021-02-26
13 | Testy komunikacji szybkich | b.d. | 24e + {- 80p -} | 2021-02-26 |  |  | 3 | 0 | 3 | 2021-02-26 | 10 | 2021-03-12
 |  |  |  |  |  | suma | 40 | 5 | 45 |  | 50

Sheet: pomiar rez MB1
Punkt pomiarowy 1 | Punkt pomiarowy 2 | uwagi | pomiar [Ohm] | Pomiar reverse [Ohm] | dopuszczalne minimum [Ohm] | dopuszczalne maksimum [Ohm] | ocena | napięcie | ocena
P8 - Power1 _In | P7 - GND |  | 97,7k | 95,8k | 100.0 | - | {+ OK +}
P10 - Power2_In | P9 - GND |  | 97,8k | 96,6k | 100.0 | - | {+ OK +}
P11.1 - Battery_PWR | P11.2 - GND |  | 50,57k | 50,15k | 100.0 | - | {+ OK +}
D4.1 - V_POE+ | D4.2 - PGND |  | 55k | 55k | 100.0 | - | {+ OK +}
C6.1 - Vout_1_Selector | C6.1 - GND |  | >45k | >45k | 100.0 | - | {+ OK +}
C698.2 - CSN | C698.1 - PGND |  | >40k | >40k | 100.0 | - | {+ OK +}
C12.1 - Vout_2_Selector | C12.2 - GND |  | 1M | 1M | 100.0 | - | {+ OK +}
C769.1 - PWR_Out_20V | C769.2 - GND |  | 60k | 4M | 100.0 | - | {+ OK +} | 20
C366.2 - 085V@40A_INA | C366.1 - GND |  | 1,2R | 1,1R | 0.1 | 100000 | {+ OK +} | 0.85
C415.2 - Vout1_1 | C415.1 - GND |  | 420R | 381.0 | 10.0 | 100000 | {+ OK +} | 3.3 |  | i=u/r | 0.008661417323
C427.2 Vout2_1 | C427.1 - GND |  | 45,3R | 45,2R | 10.0 | 100000 | {+ OK +} | 1.2
C458.2 Vout1_2 | C458.1 - GND |  | 32k | 1M | 100.0 | 10M | {+ OK +} | 12
C470.2 - Vout2_2 | C470.1 GND |  | >3M | 4,5k | 100.0 | 10M | {+ OK +} | 5
C762.1 - US+_Vcc_PS_inFp | C762.2 GND | REG1 | 1,3R | 1,2R | 0.1 | 100000 | {+ OK +} | 0.85
C749.2 - 1V8@0.5A_ADC_filtered | C749.1 - GND | REG2 | 670R | 438R | 1.0 | 100000 | {+ OK +} | 1.8
C709.2 - 0V9@1A_REG3 | C709.1 - GND | REG3 | 39,3R | 53R | 1.0 | 100000 | {+ OK +} | 0.9
C760.1 - RAM_Vcc1V2 | C760.2 - GND | REG4 | 45R | 45R | 1.0 | 100000 | {+ OK +} | 1.2
C675.2 - 0V85@2A | C675.1 - GND | REG5 | 8,7k | 10k | 10.0 | 100000 | {+ OK +} | 0.85
C742.1 - ETH_VDDIO | C742.2 - GND | REG7 | 370R | 313R | 10.0 | 100000 | {+ OK +}
C756.2 - US+MGTVaccAux | C756.1 - GND | REG8 | 1,73k | 1,197k | 10.0 | 100000 | {+ OK +}
C754.2 - US+_Vcc_PS_DDR_504 | C754.1 - GND | REG9 | 3,82k | 1,47k | 10.0 | 100000 | {+ OK +}
C722.2 - RAM_DDR4_VTT | C722.1 - GND |  | 13,2k | 15,9k | 10.0 | 10M | {+ OK +} | 0.6
C551.2 - 2V5@1.5A | C551.1 - GND |  | 9,11k | 3,36k | 10.0 | 10M | {+ OK +} | 2.5
C490.2 - 1V8@1,5A | C490.1 - GND |  | 21,5k | 22,6k | 10.0 | 10M | {+ OK +} | 1.8
C513.2 - 1V0@1.5A | C513.1 - GND |  | 528R | 877R | 10.0 | 100000 | {+ OK +} | 1
L13.2 - ADP1741_3.6V | C355.1 - GND |  | 38,3k | 6,62k | 10.0 | - | {+ OK +} | 3.6
C565_5to3V3_1.2 - 3.3V_Stable_1 | C565_5to3V3_1.1 - AGND |  | 4,5k | 5M | 10.0 | 100000 | {+ OK +} | 3.3
C569.1 - 3.3V_LN_1 | C569.1 - AGND |  | 1M | 6k | 10.0 | 100000 | {+ OK +} | 3.3
C580.2 - 5V_LN | C580.1 AGND |  | 3,4k | 3,4k | 10.0 | 100000 | {+ OK +} | 5
C205.1 - 3.3V_Stable_2 | C205.2 - AGND |  | 22,5k | 32,3k | 10.0 | 100000 | {+ OK +} | 3.3
C713.2 - NetC713_2 | C713.1 - AGND |  | 4k | 4k | 10.0 | 100000 | {+ OK +} | 8
C791.2 - FTDI_VccIO | C791.1 - GND |  | 0,1R | 0,1R | 10.0 | 100000 | {- Zwarcie -} [Opis zagadnienia](http://192.168.10.3:82/pnpsystems/elektronicy/motherboard/issues/6) | 3.3
FB31.2 - FTDI_VBUS | FB32.2 _ FTDI_Sock_GND |  | 0,3R | 0,2R | 10.0 | 100000 | {- Zwarcie -} [Opis zagadnienia](http://192.168.10.3:82/pnpsystems/elektronicy/motherboard/issues/6) | 5
R448_U_Pomiar_pradu_napiecia_PCIe0.1 - 12V_PCIE0 |  |  | 1,4M | - | 100000.0 | - | {+ OK +} | 12
R448_U_Pomiar_pradu_napiecia_PCIe1.1 - 12V_PCIE1 |  |  | 1,42M | - | 100000.0 | - | {+ OK +} | 12
R448_U_Pomiar_pradu_napiecia_PCIe2.1 - 12V_PCIE2 |  |  | - | 1,4M | 100000.0 | - | {+ OK +} | 12
R448_U_Pomiar_pradu_napiecia_PCIe3.1 - 12V_PCIE3 |  |  | - | 1,4M | 100000.0 | - | {+ OK +} | 12
R448_U_Pomiar_pradu_napiecia_PCIe4.1 - 12V_PCIE4 |  |  | - | 1,4M | 100000.0 | - | {+ OK +} | 12
C332.1 3V3_NVMe | C332.2 - GND |  | 12M | 610k | 100000.0 | 10M | {+ OK +} | 3.3
Ponowne pomiary
C791.2 - FTDI_VccIO | C791.1 - GND |  | 227,1R | 227,2R | 10.0 | 100000 | {- Zwarcie -} [Opis zagadnienia](http://192.168.10.3:82/pnpsystems/elektronicy/motherboard/issues/6) | 3.3
FB31.2 - FTDI_VBUS | FB32.2 _ FTDI_Sock_GND |  | >12,5M | >2M | 10.0 | 100000 | {- Zwarcie -} [Opis zagadnienia](http://192.168.10.3:82/pnpsystems/elektronicy/motherboard/issues/6) | 5

Sheet: Pomiar Napięć i prądów MB1
Designator przetwornicy | Model | Oczekiwane napięcie na wyjściu | Zmierzone napięcie [V] | Dopuszczalne minimum [V] | Dopuszczalne maksimum [V] | Designator rezystora pomiarowego | Spadek napięciana rezystorze pomiarowym [V] | Opór rezystora pomiarowego | Wyliczony prąd [A] | Dopuszczalne maksimum [A] | wynik pomiarów | numer miernika | dodatkowe obliczenia dla przetwornic LDO |  |  |  | Maksymalna moc na obudowie | temperatura obudowy | dopuszczalny błąd
U34 | ADP1850ACPZ-R7 | 0.85 |  | 0.833 | 0.867 | R617 |  | 0.04 |  | 40 |  |  | Vin [V] | Vout [V] | prąd [A] | ciepło [W] |  |  | 0.02
U37.1 | ADP1850ACPZ-R7 | 3.3 |  | 3.234 | 3.366 | R448_U_Pomiar_pradu_napiecia_3 |  | 0.05 |  | 14 |  | 3
U37.2 |  | 1.2 |  | 1.176 | 1.224 | R448_U_Pomiar_pradu_napiecia_4 |  | 0.05 |  | 15 |  | 4
U38.1 | ADP1850ACPZ-R7 | 12 |  | 11.76 | 12.24 | R448_U_Pomiar_pradu_napiecia_5 |  | 0.05 |  | 8 |  | 5
U38.2 |  | 5 |  | 4.9 | 5.1 | R448_U_Pomiar_pradu_napiecia_6 |  | 0.05 |  | 10 |  | 6
U19.1 | LT3504EUFD#PBF | 3.6 |  | 3.528 | 3.672 | - |  |  |  | 1
U19.2 |  | 1.8 |  | 1.764 | 1.836 | - |  |  |  | 1
U19.3 |  | 3.3 |  | 3.234 | 3.366 | - |  |  |  | 1
U19.4 |  | 1.2 |  | 1.176 | 1.224 | - |  |  |  | 1
U59_5to3V3_1 | MCP1727T-ADJE/MF | 3.3 |  | 3.234 | 3.366 | - |  |  |  | 1.5 |  |  | 5 | 3.3 | 1.2 | 2.04 | 1.2
U59_5to3V3_2 | MCP1727T-ADJE/MF | 3.3 |  | 3.234 | 3.366 | - |  |  |  | 1.5 |  |  | 5 | 3.3 | 1.2 | 2.04 | 1.2
U59_5to3V3_for_FTDI | MCP1727T-ADJE/MF | 3.3 |  | 3.234 | 3.366 | - |  |  |  | 1 |  |  | 5 | 3.3 | 0.465 | 0.7905 | 1.2
U60 | ADP1741ACPZ-R7 | 3.3 |  | 3.234 | 3.366 | - |  |  |  | 2 |  |  | 3.6 | 3.3 | 1 | 0.3 |  | 9.81
U61.1 | TPS7A8801RTJT | 3.3 |  | 3.234 | 3.366 | - |  |  |  | 0.4 |  |  | 5 | 3.3 | 0.17 | 0.289 |  | 15.62708
U61.2 |  | 3.3 |  | 3.234 | 3.366 | - |  |  |  | 1 |  |  | 5 | 3.3 | 0.516 | 0.8772
U62 | LT3042EDD#PBF | 5 |  | 4.9 | 5.1 | - |  |  |  | 0.5 |  |  | 12 | 5 | 0.062 | 0.434 |  | 15.19
U49 | MCP1727T-ADJE/MF | 2.5 |  | 2.45 | 2.55 | - |  |  |  | 0.5 |  |  | 3.3 | 2.5 | 0.266 | 0.2128 | 1.2 | 8.7248
U50 | MCP1727T-ADJE/MF | 1.8 |  | 1.764 | 1.836 | - |  |  |  | 0.1 |  |  | 3.3 | 1.8 | 0.0755 | 0.11325 | 1.2
U51 | MCP1727T-ADJE/MF | 1 |  | 0.98 | 1.02 | - |  |  |  | 0.3 |  |  | 3.3 | 1 | 0.216 | 0.4968 | 1.2
U65 | MAX17557ATP+ | 20 |  | 19.6 | 20.4 | - |  |  |  | 3
U70.1 | TPS7A8801RTJT | 1.8 |  | 1.764 | 1.836 | - |  |  |  | 0.5 |  |  | 3.3 | 1.8 | 0.462 | 0.693 |  | 51.56856
U70.2 |  | 0.9 |  | 0.882 | 0.918 | - |  |  |  | 0.5 |  |  | 3.3 | 0.9 | 0.513 | 1.2312
U69 | ADP1741ACPZ-R7 | 0.85 |  | 0.833 | 0.867 | - |  |  |  | 0.3 |  |  | 3.3 | 0.85 | 0.218 | 0.5341 |  | 17.46507
U73 | ST1L08SPUR | 0.6 |  | 0.588 | 0.612 | - |  |  |  | 0.1 |  |  | 5 | 0.6 | 0.1 | 0.44 |  | 5.28

Sheet: Pomiar FB przetwornicU
Designator przetwornicy | Model | Oczekiwane napięcie na wyjściu | wyliczony rezystor FB-Vout [ohm] | wyliczony rezystor FB - GND [ohm] | wyliczone Vout | Rozbieżność [%] | Designator Rezystora FB - Vout | Designator Rezystora FB -GND | fizyczny rezystor FB - Vout [Ohm] | Fizyczny rezystor FB - GND [ohm] | wyliczone Vout | Rezystancja Vout - GND | Rezystancja Vout - GND | ocena
U34 | ADP1850ACPZ-R7 | 0.85 | 5000 | 12000 | 0.85 | 0 | R271 | R273 | 4994 | 12010 | 0.8494920899 |  | -0.05975412646 | {+ OK +} | ok | ok
U37.1 | ADP1850ACPZ-R7 | 3.3 | 47000 | 10000 | 3.42 | 3.636363636 | R287 | R290 | 18990 | 8730 | 1.905154639 | 15370 | -42.26804124 | {- błąd -} | 2.474986835 | 1.145475372
U37.2 |  | 1.2 | 10000 | 10000 | 1.2 | 0 | R297 | R300 | 8730 | 8730 | 1.2 | 14990 | 0 | {+ OK +} | 1.145475372 | 1.145475372
U38.1 | ADP1850ACPZ-R7 | 12 | 200000 | 10500 | 12.02857143 | 0.2380952381 | R626 | R627 | 155000 | 10340 | 9.594197292 | 158000 | -20.0483559 | {+ OK +} | 1.290322581 | ok
U38.2 |  | 5 | 196000 | 27000 | 4.955555556 | -0.8888888889 | R315 | R318 | 155000 | 26000 | 4.176923077 | 170000 | -16.46153846 | {+ OK +} | 1.264516129 | 1.038461538
U19.1 | LT3504EUFD#PBF | 3.6 | 34800 | 10000 | 3.584 | -0.4444444444 | R113 | R114 | 31140 | 9300 | 3.478709677 | 39800 | -3.369175627 | {+ OK +} | 1.117533719 | 1.075268817
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
U73 | ST1L08SPUR | 0.6 | 20000 | 100000 | 0.6 | 0 | R689 | R690 | 17560 | 27710 | 0.8168531216 | 16060 | 36.14218694 | {+ OK +} | 1.138952164 | 3.608805485
 |  |  |  |  |  |  |  |  |  |  |  | 7.18
 |  |  |  |  |  |  |  |  |  |  |  | 0.312
 |  | 35000 | 3.584
 |  |  |  | 0.8011869436

Sheet: MB2
**Lp.** | **Opis zagadnienia** | **Wynik** | **ilość godzin** | **Szacowana data zakończenia testów** | **Data zakończenia testów** | dodatkowe godziny | dni | dni dodatkowe | suma | data zakończenia | dni programistów
1 | Optyczny test ułożenia układów | b.d. | 8e | 2021-03-02 |  | 8 | 1 | 1 | 2 | 2021-03-02 | 0 | 2021-01-02
2 | Pomiar rezystancji torów zasilających | b.d. | 24e | 2021-03-05 |  |  | 3 | 0 | 3 | 2021-03-05 | 0 | 2021-01-02
3 | Testy konfiguracji przetwornic zasilających | b.d. | 32e | 2021-03-11 |  |  | 4 | 0 | 4 | 2021-03-11 | 0 | 2021-01-02
4 | Pomiary napięć i prądów zasilających, niezależnych | b.d. | 08e + 8p | 2021-03-12 |  |  | 1 | 0 | 1 | 2021-03-12 | 0 | 2021-01-02
5 | Pomiary konfiguracji torów zasilających | b.d. | 08e | 2021-03-15 |  |  | 1 | 0 | 1 | 2021-03-15 | 0 | 2021-01-02
6 | Testy komunikacji z procesorem US+ | b.d. | 08e + 16p | 2021-03-16 |  |  | 1 | 0 | 1 | 2021-03-16 | 2 | 2021-01-05
7 | Testy komunikacji I2C | b.d. | 08e + 8p | 2021-03-17 |  |  | 1 | 0 | 1 | 2021-03-17 | 1 | 2021-01-06
8 | Pomiary napięć i prądów zasilających, zależnych | b.d. | 08e + 8p | 2021-03-18 |  |  | 1 | 0 | 1 | 2021-03-18 | 1 | 2021-01-07
9 | Pomiary napięć i prądów zasilających niezależnych pod obciążeniem częściowym | b.d. | 04e + 8p | 2021-03-18 |  |  | 0.5 | 0 | 0.5 | 2021-03-18 | 0 | 2021-01-07
10 | Testy komunikacji SPI | b.d. | 16e + 8p | 2021-03-22 |  |  | 2 | 0 | 2 | 2021-03-22 | 0 | 2021-01-07
11 | Pomiary dystrybucji zegarów | b.d. | 16e | 2021-03-24 |  |  | 2 | 0 | 2 | 2021-03-24 | 0 | 2021-01-07
12 | Obsługa pozostałych urządzeń peryferyjnych na komunikacjach SPI oraz I2C | b.d. | 24e + 16p | 2021-03-29 |  |  | 3 | 0 | 3 | 2021-03-29 | 2 | 2021-01-11
13 | Testy komunikacji szybkich | b.d. | 24e +8p | 2021-04-01 |  |  | 3 | 0 | 3 | 2021-04-01 | 0 | 2021-01-11
 |  |  |  |  |  | suma | 23.5 | 1 | 24.5 |  | 6

Sheet: pomiar rez MB1 (2)
Punkt pomiarowy 1 | Punkt pomiarowy 2 | uwagi | pomiar [Ohm] | Pomiar reverse [Ohm] | dopuszczalne minimum [Ohm] | dopuszczalne maksimum [Ohm] | ocena | napięcie | ocena
P8 - Power1 _In | P7 - GND |  | 1,5M | 100k | 100.0 | - | {+ OK +}
P10 - Power2_In | P9 - GND |  | 100k | 100k | 100.0 | - | {+ OK +}
P11.1 - Battery_PWR | P11.2 - GND |  | 50k | 50k | 100.0 | - | {+ OK +}
D4.1 - V_POE+ | D4.2 - PGND |  | 40k | 40k | 100.0 | - | {+ OK +}
C6.1 - Vout_1_Selector | C6.1 - GND |  | 2M | 200k | 100.0 | - | {+ OK +}
C698.2 - CSN | C698.1 - PGND |  | 45k | 1M | 100.0 | - | {+ OK +}
C12.1 - Vout_2_Selector | C12.2 - GND |  | 1M | 1M | 100.0 | - | {+ OK +}
C769.1 - PWR_Out_20V | C769.2 - GND |  | 5k | 20k | 100.0 | - | {+ OK +} | 20
C366.2 - 085V@40A_INA | C366.1 - GND |  | 3,2Ohm | 3,2Ohm | 0.1 | 100000 | {+ OK +} | 0.85
C415.2 - Vout1_1 | C415.1 - GND |  | 56Ohm | 56Ohm | 10.0 | 100000 | {+ OK +} | 3.3 |  | i=u/r | #VALUE!
C427.2 Vout2_1 | C427.1 - GND |  | 47Ohm | 47Ohm | 10.0 | 100000 | {+ OK +} | 1.2
C458.2 Vout1_2 | C458.1 - GND |  | 3M | 30k | 100.0 | 10M | {+ OK +} | 12
C470.2 - Vout2_2 | C470.1 GND |  | 1M | 30k | 100.0 | 10M | {+ OK +} | 5
C762.1 - US+_Vcc_PS_inFp | C762.2 GND | REG1 | 3,2Ohm | 3,2Ohm | 0.1 | 100000 | {+ OK +} | 0.85
C749.2 - 1V8@0.5A_ADC_filtered | C749.1 - GND | REG2 | 600Ohm | 745Ohm | 1.0 | 100000 | {+ OK +} | 1.8
C709.2 - 0V9@1A_REG3 | C709.1 - GND | REG3 | 92Ohm | 238Ohm | 1.0 | 100000 | {+ OK +} | 0.9
C760.1 - RAM_Vcc1V2 | C760.2 - GND | REG4 | 47Ohm | 47Ohm | 1.0 | 100000 | {+ OK +} | 1.2
C675.2 - 0V85@2A | C675.1 - GND | REG5 | 8,9K | 9,7K | 10.0 | 100000 | {+ OK +} | 0.85
C742.1 - ETH_VDDIO | C742.2 - GND | REG7 | 340Ohm | 297Ohm | 10.0 | 100000 | {+ OK +}
C756.2 - US+MGTVaccAux | C756.1 - GND | REG8 | 1,8k | 1,2k | 10.0 | 100000 | {+ OK +}
C754.2 - US+_Vcc_PS_DDR_504 | C754.1 - GND | REG9 | 3,4k | 1,5k | 10.0 | 100000 | {+ OK +}
C722.2 - RAM_DDR4_VTT | C722.1 - GND |  | 14k | 17k | 10.0 | 10M | {+ OK +} | 0.6
C551.2 - 2V5@1.5A | C551.1 - GND |  | 10k | 3,4k | 10.0 | 10M | {+ OK +} | 2.5
C490.2 - 1V8@1,5A | C490.1 - GND |  | 22k | 23k | 10.0 | 10M | {+ OK +} | 1.8
C513.2 - 1V0@1.5A | C513.1 - GND |  | 581Ohm | 1K | 10.0 | 100000 | {+ OK +} | 1
L13.2 - ADP1741_3.6V | C355.1 - GND |  | 40k | 7,2k | 10.0 | - | {+ OK +} | 3.6
C565_5to3V3_1.2 - 3.3V_Stable_1 | C565_5to3V3_1.1 - AGND |  | 100k | 75k | 10.0 | 100000 | {+ OK +} | 3.3
C569.1 - 3.3V_LN_1 | C569.1 - AGND |  | 50k | 6k | 10.0 | 100000 | {+ OK +} | 3.3
C580.2 - 5V_LN | C580.1 AGND |  | 3,4k | 2,8k | 10.0 | 100000 | {+ OK +} | 5
C205.1 - 3.3V_Stable_2 | C205.2 - AGND |  | 100k | 100k | 10.0 | 100000 | {+ OK +} | 3.3
C713.2 - NetC713_2 | C713.1 - AGND |  | 4k | 4k | 10.0 | 100000 | {+ OK +} | 8
C791.2 - FTDI_VccIO | C791.1 - GND |  | 227Ohm | 227Ohm | 10.0 | 100000 | {- Zwarcie -} [Opis zagadnienia](http://192.168.10.3:82/pnpsystems/elektronicy/motherboard/issues/6) | 3.3
FB31.2 - FTDI_VBUS | FB32.2 _ FTDI_Sock_GND |  | 10M | 46k | 10.0 | 100000 | {- Zwarcie -} [Opis zagadnienia](http://192.168.10.3:82/pnpsystems/elektronicy/motherboard/issues/6) | 5
R448_U_Pomiar_pradu_napiecia_PCIe0.1 - 12V_PCIE0 |  |  |  |  | 100000.0 | - | {+ OK +} | 12
R448_U_Pomiar_pradu_napiecia_PCIe1.1 - 12V_PCIE1 |  |  |  |  | 100000.0 | - | {+ OK +} | 12
R448_U_Pomiar_pradu_napiecia_PCIe2.1 - 12V_PCIE2 |  |  |  |  | 100000.0 | - | {+ OK +} | 12
R448_U_Pomiar_pradu_napiecia_PCIe3.1 - 12V_PCIE3 |  |  |  |  | 100000.0 | - | {+ OK +} | 12
R448_U_Pomiar_pradu_napiecia_PCIe4.1 - 12V_PCIE4 |  |  |  |  | 100000.0 | - | {+ OK +} | 12
C332.1 3V3_NVMe | C332.2 - GND |  |  |  | 100000.0 | 10M | {+ OK +} | 3.3
Ponowne pomiary
C791.2 - FTDI_VccIO | C791.1 - GND |  |  |  | 10.0 | 100000 | {- Zwarcie -} [Opis zagadnienia](http://192.168.10.3:82/pnpsystems/elektronicy/motherboard/issues/6) | 3.3
FB31.2 - FTDI_VBUS | FB32.2 _ FTDI_Sock_GND |  |  |  | 10.0 | 100000 | {- Zwarcie -} [Opis zagadnienia](http://192.168.10.3:82/pnpsystems/elektronicy/motherboard/issues/6) | 5
