pnpsystemsspzoo/Detekcja-i-lokalizacja-zk-ocen-RF/Sonda_hardware/model_obudowy_sondy/Część3.STEP

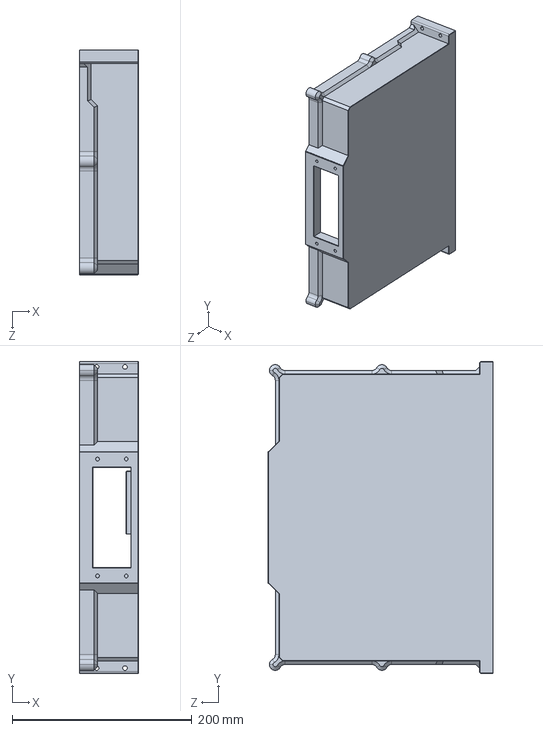
[picture p94: CAD file, 2025-12-31]
Sonda_hardware/model_obudowy_sondy/Część3.STEP
65.5 x 346.9 x 250.0 mm
