pnpsystemsspzoo/Detekcja-i-lokalizacja-zk-ocen-RF/Sonda_hardware/model_obudowy_sondy/Część4.STEP

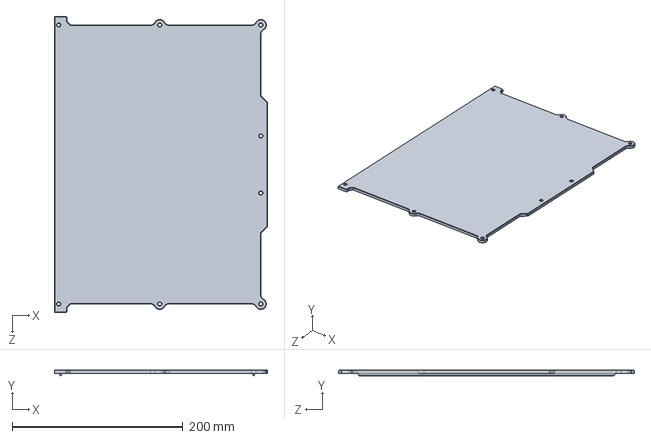
[picture p95: CAD file, 2025-12-31]
Sonda_hardware/model_obudowy_sondy/Część4.STEP
250.0 x 6.50 x 346.9 mm
