pnpsystemsspzoo/Detekcja-i-lokalizacja-zk-ocen-RF/Sonda_hardware/model_obudowy_sondy/Część1.STEP

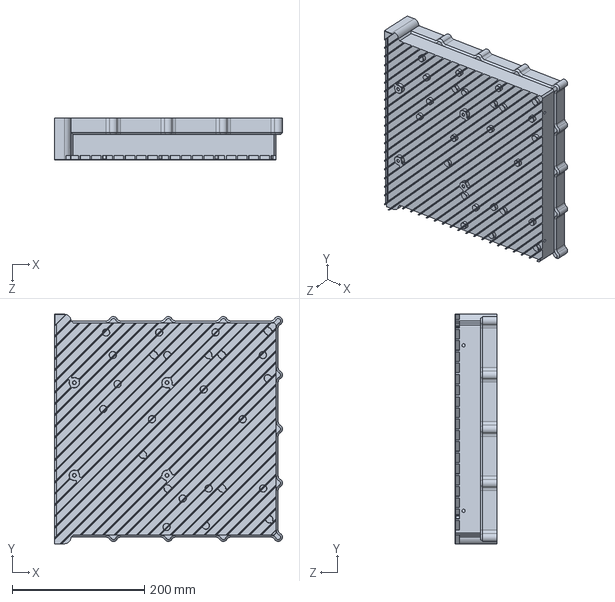
[picture p96: CAD file, 2025-12-31]
Sonda_hardware/model_obudowy_sondy/Część1.STEP
344.4 x 346.9 x 63.6 mm
