pnpsystemsspzoo/Detekcja-i-lokalizacja-zk-ocen-RF/Sonda_hardware/model_obudowy_sondy/Część2.STEP

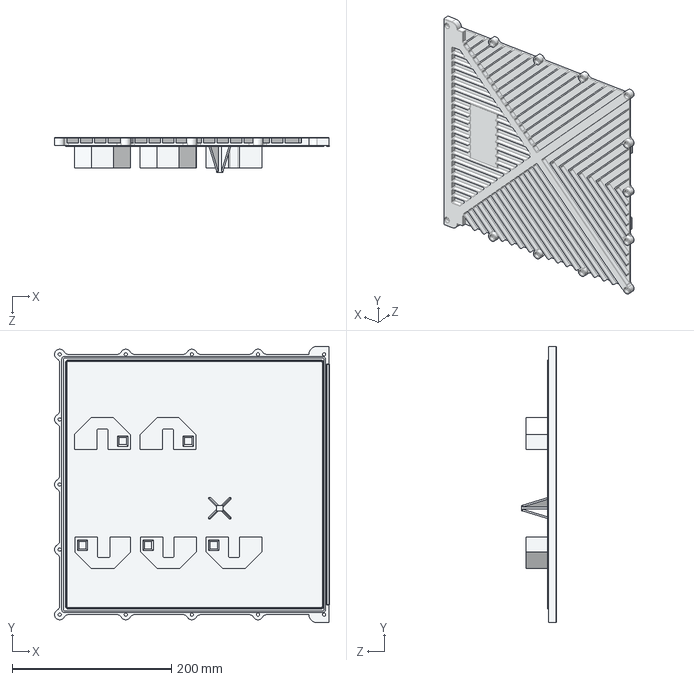
[picture p98: CAD file, 2025-12-31]
Sonda_hardware/model_obudowy_sondy/Część2.STEP
345.3 x 346.9 x 44.2 mm
