pnpsystemsspzoo/Detekcja-i-lokalizacja-zk-ocen-RF/(list of files, cad)

Other CAD files:
Sonda_hardware/model_obudowy_sondy/Część1 .STL
Sonda_hardware/model_obudowy_sondy/Część1.x_t
Sonda_hardware/model_obudowy_sondy/Część2.STL
Sonda_hardware/model_obudowy_sondy/Część2.x_t
Sonda_hardware/model_obudowy_sondy/Część3.STL
Sonda_hardware/model_obudowy_sondy/Część3.x_t
Sonda_hardware/model_obudowy_sondy/Część4.STL
Sonda_hardware/model_obudowy_sondy/Część4.x_t
