pnpsystemsspzoo/Detekcja-i-lokalizacja-zk-ocen-RF/Dane_badawcze/Sonda_testy/expandery_MB.xlsx

Sheet: I2C_Bridge_GPIO
 |  |  | 1 - enable |  |  | 1 - enable |  |  | 1 - enable |  | 1 - enable |  | 1 - enable |  |  | 1 - enable |  | 1 - enable |  | 1 - enable |  | 1 - enable
 |  | Enable channel 0 | 0 |  | Enable channel 0 | 1 |  | Enable channel 0 | 0 | Enable channel 0 | 0 | Enable channel 0 | 0 |  | Enable channel 0 | 0 | Enable channel 0 | 0 | Enable channel 0 | 0 | Enable channel 0 | 0
 |  | Enable channel 1 | 0 |  | Enable channel 1 | 0 |  | Enable channel 1 | 0 | Enable channel 1 | 0 | Enable channel 1 | 0 |  | Enable channel 1 | 0 | Enable channel 1 | 0 | Enable channel 1 | 0 | Enable channel 1 | 0
 |  | Enable channel 2 | 0 |  | Enable channel 2 | 0 |  | Enable channel 2 | 0 | Enable channel 2 | 0 | Enable channel 2 | 0 |  | Enable channel 2 | 0 | Enable channel 2 | 0 | Enable channel 2 | 0 | Enable channel 2 | 0
 |  | Enable channel 3 | 0 |  | Enable channel 3 | 0 |  | Enable channel 3 | 0 | Enable channel 3 | 0 | Enable channel 3 | 0 |  | Enable channel 3 | 0 | Enable channel 3 | 0 | Enable channel 3 | 0 | Enable channel 3 | 0
 |  | Enable channel 4 | 0 |  | Enable channel 4 | 0 |  | Enable channel 4 | 1 | Enable channel 4 | 0 | Enable channel 4 | 0 |  | Enable channel 4 | 0 | Enable channel 4 | 0 | Enable channel 4 | 0 | Enable channel 4 | 0
 |  | Enable channel 5 | 0 |  | Enable channel 5 | 0 |  | Enable channel 5 | 0 | Enable channel 5 | 1 | Enable channel 5 | 0 |  | Enable channel 5 | 0 | Enable channel 5 | 0 | Enable channel 5 | 0 | Enable channel 5 | 0
 |  | Enable channel 6 | 0 |  | Enable channel 6 | 0 |  | Enable channel 6 | 0 | Enable channel 6 | 0 | Enable channel 6 | 1 |  | Enable channel 6 | 0 | Enable channel 6 | 0 | Enable channel 6 | 0 | Enable channel 6 | 0
 |  | Enable channel 7 | 0 |  | Enable channel 7 | 0 |  | Enable channel 7 | 0 | Enable channel 7 | 0 | Enable channel 7 | 0 |  | Enable channel 7 | 0 | Enable channel 7 | 0 | Enable channel 7 | 0 | Enable channel 7 | 0
 |  | wylacz | 00000000 |  | exp_group_0x | 00000001 |  | exp_group_1x | 00010000 | Bridge_SFP:Port 5 | 00100000 | Bridge_SFP:Port 6 | 01000000 |  | Bridge_SFP:Port 6 | 00000000 | none | 00000000 | none | 00000000 | none | 00000000
 |  | ctrl_reg | 0x00 |  | ctrl_reg | 0x01 |  | ctrl_reg | 0x10 | ctrl_reg | 0x20 | ctrl_reg | 0x40 |  | ctrl_reg | 0x00 | ctrl_reg | 0x00 | ctrl_reg | 0x00 | ctrl_reg | 0x00
device
bridge | TCA9548 | I2C_Bridge_GPIO
i2c_addr | 0x73
i2c_num | /dev/i2c-1
 |  |  |  |  |  |  |  |  |  |  |  |  |  | i2c_num | i2c_0
 |  |  |  |  |  |  |  |  |  |  |  |  |  | i2c_addr | 0xE6
#I2C_Bridge_GPIO:wylacz
device | TCA9548 |  |  | ZŁĄCZ.TEKSTY($B$16;" ";$C$16;" ";ADR.POŚR(H32)) | 3 | 11 | $C$11
i2c_addr | 0x73
i2c_num | /dev/i2c-1 |  |  |  |  |  | $C$12
ctrl_reg | 0x00 |  |  |  |  |  | $D$12
time | 10
#I2C_Bridge_GPIO:exp_group_0x
device | TCA9548 |  |  | ZŁĄCZ.TEKSTY($B$16;" ";$C$16;" ";ADR.POŚR(H32)) | 6 | 11 | $F$11
i2c_addr | 0x73
i2c_num | /dev/i2c-1 |  |  |  |  |  | $F$12
ctrl_reg | 0x01 |  |  |  |  |  | $G$12
time | 10
#I2C_Bridge_GPIO:exp_group_1x
device | TCA9548 |  |  | ZŁĄCZ.TEKSTY($B$16;" ";$C$16;" ";ADR.POŚR(H32)) | 9 | 11 | $I$11
i2c_addr | 0x73
i2c_num | /dev/i2c-1 |  |  |  |  |  | $I$12
ctrl_reg | 0x10 |  |  |  |  |  | $J$12
time | 11
#I2C_Bridge_GPIO:Bridge_SFP:Port 5
device | TCA9548 |  |  | ZŁĄCZ.TEKSTY($B$16;" ";$C$16;" ";ADR.POŚR(H32)) | 12 | 11 | $L$11
i2c_addr | 0x73
i2c_num | /dev/i2c-1 |  |  |  |  |  | $L$12
ctrl_reg | 0x20 |  |  |  |  |  | $M$12
time | 11
#I2C_Bridge_GPIO:Bridge_SFP:Port 6
device | TCA9548 |  |  | ZŁĄCZ.TEKSTY($B$16;" ";$C$16;" ";ADR.POŚR(H32)) | 15 | 11 | $O$11
i2c_addr | 0x73
i2c_num | /dev/i2c-1 |  |  |  |  |  | $O$12
ctrl_reg | 0x40 |  |  |  |  |  | $P$12
time | 12
#I2C_Bridge_GPIO:Bridge_SFP:Port 6
device | TCA9548 |  |  | ZŁĄCZ.TEKSTY($B$16;" ";$C$16;" ";ADR.POŚR(H32)) | 18 | 11 | $R$11
i2c_addr | 0x73
i2c_num | /dev/i2c-1 |  |  |  |  |  | $R$12
ctrl_reg | 0x00 |  |  |  |  |  | $S$12
time | 12
#I2C_Bridge_GPIO:none
device | TCA9548 |  |  | ZŁĄCZ.TEKSTY($B$16;" ";$C$16;" ";ADR.POŚR(H32)) | 21 | 11 | $U$11
i2c_addr | 0x73
i2c_num | /dev/i2c-1 |  |  |  |  |  | $U$12
ctrl_reg | 0x00 |  |  |  |  |  | $V$12
time | 13
#I2C_Bridge_GPIO:none
device | TCA9548 |  |  | ZŁĄCZ.TEKSTY($B$16;" ";$C$16;" ";ADR.POŚR(H32)) | 24 | 11 | $X$11
i2c_addr | 0x73
i2c_num | /dev/i2c-1 |  |  |  |  |  | $X$12
ctrl_reg | 0x00 |  |  |  |  |  | $Y$12
time | 13
#I2C_Bridge_GPIO:none
device | TCA9548 |  |  | ZŁĄCZ.TEKSTY($B$16;" ";$C$16;" ";ADR.POŚR(H32)) | 27 | 11 | $AA$11
i2c_addr | 0x73
i2c_num | /dev/i2c-1 |  |  |  |  |  | $AA$12
ctrl_reg | 0x00 |  |  |  |  |  | $AB$12
time | 14

Sheet: I2C_Bridge_SFP
 |  |  | 1 - enable |  |  | 1 - enable |  |  | 1 - enable |  |  | 1 - enable |  |  | 1 - enable |  |  | 1 - enable |  |  | 1 - enable |  |  | 1 - enable |  |  | 1 - enable |  |  | 1 - enable
SFP1 |  | SFP1 | 0 |  | SFP1 | 0 |  | SFP1 | 0 |  | SFP1 | 0 |  | SFP1 | 1 |  | SFP1 | 0 |  | SFP1 | 0 |  | SFP1 | 0 |  | SFP1 | 0 |  | SFP1 | 0
 |  | SFP3 | 0 |  | SFP3 | 0 |  | SFP3 | 0 |  | SFP3 | 0 |  | SFP3 | 0 |  | SFP3 | 0 |  | SFP3 | 1 |  | SFP3 | 0 |  | SFP3 | 0 |  | SFP3 | 0
 |  | SFP0 | 0 |  | SFP0 | 0 |  | SFP0 | 0 |  | SFP0 | 0 |  | SFP0 | 0 |  | SFP0 | 0 |  | SFP0 | 0 |  | SFP0 | 0 |  | SFP0 | 1 |  | SFP0 | 0
 |  | SFP2 | 0 |  | SFP2 | 0 |  | SFP2 | 0 |  | SFP2 | 0 |  | SFP2 | 0 |  | SFP2 | 1 |  | SFP2 | 0 |  | SFP2 | 0 |  | SFP2 | 0 |  | SFP2 | 0
 |  | IMU | 0 |  | IMU | 0 |  | IMU | 0 |  | IMU | 0 |  | IMU | 0 |  | IMU | 0 |  | IMU | 0 |  | IMU | 1 |  | IMU | 0 |  | IMU | 0
 |  | Curr_Volt_Meas | 0 |  | Curr_Volt_Meas | 1 |  | Curr_Volt_Meas | 0 |  | Curr_Volt_Meas | 0 |  | Curr_Volt_Meas | 0 |  | Curr_Volt_Meas | 0 |  | Curr_Volt_Meas | 0 |  | Curr_Volt_Meas | 0 |  | Curr_Volt_Meas | 0 |  | Curr_Volt_Meas | 0
 |  | PCIE_Bridge | 0 |  | PCIE_Bridge | 0 |  | PCIE_Bridge | 0 |  | PCIE_Bridge | 1 |  | PCIE_Bridge | 0 |  | PCIE_Bridge | 0 |  | PCIE_Bridge | 0 |  | PCIE_Bridge | 0 |  | PCIE_Bridge | 0 |  | PCIE_Bridge | 0
 |  | I2C_Expander_SFP | 0 |  | I2C_Expander_SFP | 0 |  | I2C_Expander_SFP | 1 |  | I2C_Expander_SFP | 0 |  | I2C_Expander_SFP | 0 |  | I2C_Expander_SFP | 0 |  | I2C_Expander_SFP | 0 |  | I2C_Expander_SFP | 0 |  | I2C_Expander_SFP | 0 |  | I2C_Expander_SFP | 1
 |  | wylacz | 00000000 |  | Exp_PCIE | 00100000 |  | I2C_Expander SFP | 10000000 |  | PCIE_Bridge | 01000000 |  | SFP1 | 00000001 |  | SFP2 | 00001000 |  | SFP3 | 00000010 |  | IMU | 00010000 |  | SFP0 | 00000100 |  | Exp_SFP | 10000000
 |  | ctrl_reg | 0x00 |  | ctrl_reg | 0x20 |  | ctrl_reg | 0x80 |  | ctrl_reg | 0x40 |  | ctrl_reg | 0x01 |  | ctrl_reg | 0x08 |  | ctrl_reg | 0x02 |  | ctrl_reg | 0x10 |  | ctrl_reg | 0x04 |  | ctrl_reg | 0x80
1 | 2 | 3 | 4 | 5 | 6 | 7 | 8 | 9 | 10 | 11 | 12 | 13 | 14 | 15 | 16 | 17 | 18 | 19 | 20 | 21 | 22 | 23 | 24 | 25 | 26 | 27 | 28 | 29 | 30 | 31 | 32 | 33
device
bridge | TCA9548 | I2C_Bridge_SFP
i2c_addr | 0x70
i2c_num | /dev/i2c-1
#I2C_Bridge_SFP:wylacz
device | TCA9548 |  |  | ZŁĄCZ.TEKSTY($B$16;" ";$C$16;" ";ADR.POŚR(H32)) | 3 | 11 | $C$11
i2c_addr | 0x70
i2c_num | /dev/i2c-1 |  |  |  |  |  | $C$12
ctrl_reg | 0x00 |  |  |  |  |  | $D$12
time | 10
#I2C_Bridge_SFP:Exp_PCIE
device | TCA9548 |  |  | ZŁĄCZ.TEKSTY($B$16;" ";$C$16;" ";ADR.POŚR(H32)) | 6 | 11 | $F$11
i2c_addr | 0x70
i2c_num | /dev/i2c-1 |  |  |  |  |  | $F$12
ctrl_reg | 0x20 |  |  |  |  |  | $G$12
time | 10
#I2C_Bridge_SFP:I2C_Expander SFP
device | TCA9548 |  |  | ZŁĄCZ.TEKSTY($B$16;" ";$C$16;" ";ADR.POŚR(H32)) | 9 | 11 | $I$11
i2c_addr | 0x70
i2c_num | /dev/i2c-1 |  |  |  |  |  | $I$12
ctrl_reg | 0x80 |  |  |  |  |  | $J$12
time | 11
#I2C_Bridge_SFP:PCIE_Bridge
device | TCA9548 |  |  | ZŁĄCZ.TEKSTY($B$16;" ";$C$16;" ";ADR.POŚR(H32)) | 12 | 11 | $L$11
i2c_addr | 0x70
i2c_num | /dev/i2c-1 |  |  |  |  |  | $L$12
ctrl_reg | 0x40 |  |  |  |  |  | $M$12
time | 11
#I2C_Bridge_SFP:SFP1
device | TCA9548 |  |  | ZŁĄCZ.TEKSTY($B$16;" ";$C$16;" ";ADR.POŚR(H32)) | 15 | 11 | $O$11
i2c_addr | 0x70
i2c_num | /dev/i2c-1 |  |  |  |  |  | $O$12
ctrl_reg | 0x01 |  |  |  |  |  | $P$12
time | 12
#I2C_Bridge_SFP:SFP2
device | TCA9548 |  |  | ZŁĄCZ.TEKSTY($B$16;" ";$C$16;" ";ADR.POŚR(H32)) | 18 | 11 | $R$11
i2c_addr | 0x70
i2c_num | /dev/i2c-1 |  |  |  |  |  | $R$12
ctrl_reg | 0x08 |  |  |  |  |  | $S$12
time | 12
#I2C_Bridge_SFP:SFP3
device | TCA9548 |  |  | ZŁĄCZ.TEKSTY($B$16;" ";$C$16;" ";ADR.POŚR(H32)) | 21 | 11 | $U$11
i2c_addr | 0x70
i2c_num | /dev/i2c-1 |  |  |  |  |  | $U$12
ctrl_reg | 0x02 |  |  |  |  |  | $V$12
time | 13
#I2C_Bridge_SFP:IMU
device | TCA9548 |  |  | ZŁĄCZ.TEKSTY($B$16;" ";$C$16;" ";ADR.POŚR(H32)) | 24 | 11 | $X$11
i2c_addr | 0x70
i2c_num | /dev/i2c-1 |  |  |  |  |  | $X$12
ctrl_reg | 0x10 |  |  |  |  |  | $Y$12
time | 13
#I2C_Bridge_SFP:SFP0
device | TCA9548 |  |  | ZŁĄCZ.TEKSTY($B$16;" ";$C$16;" ";ADR.POŚR(H32)) | 27 | 11 | $AA$11
i2c_addr | 0x70
i2c_num | /dev/i2c-1 |  |  |  |  |  | $AA$12
ctrl_reg | 0x04 |  |  |  |  |  | $AB$12
time | 14

Sheet: I2C_Bridge_PCIE
 |  |  | 1 - enable |  |  | 1 - enable |  |  | 1 - enable |  | 1 - enable |  | 1 - enable |  | 1 - enable |  | 1 - enable |  | 1 - enable |  | 1 - enable
SD/SC0 |  | PCIE3 | 0 |  | PCIE3 | 0 |  | PCIE3 | 0 | PCIE3 | 0 | PCIE3 | 1 | PCIE3 | 0 | PCIE3 | 0 | PCIE3 | 0 | PCIE3 | 0
SD/SC1 |  | PCIE0 | 0 |  | PCIE0 | 1 |  | PCIE0 | 0 | PCIE0 | 0 | PCIE0 | 0 | PCIE0 | 0 | PCIE0 | 0 | PCIE0 | 0 | PCIE0 | 0
SD/SC2 |  | Pomiar_pradu_napiecia_PCIE_4 / Pomiar_pradu_napiecia_PCIE_1 | 0 |  | Pomiar_pradu_napiecia_PCIE_4 / Pomiar_pradu_napiecia_PCIE_1 | 0 |  | Pomiar_pradu_napiecia_PCIE_4 / Pomiar_pradu_napiecia_PCIE_1 | 0 | Pomiar_pradu_napiecia_PCIE_4 / Pomiar_pradu_napiecia_PCIE_1 | 0 | Pomiar_pradu_napiecia_PCIE_4 / Pomiar_pradu_napiecia_PCIE_1 | 0 | Pomiar_pradu_napiecia_PCIE_4 / Pomiar_pradu_napiecia_PCIE_1 | 0 | Pomiar_pradu_napiecia_PCIE_4 / Pomiar_pradu_napiecia_PCIE_1 | 1 | Pomiar_pradu_napiecia_PCIE_4 / Pomiar_pradu_napiecia_PCIE_1 | 0 | Pomiar_pradu_napiecia_PCIE_4 / Pomiar_pradu_napiecia_PCIE_1 | 0
SD/SC3 |  | PCIE1 | 0 |  | PCIE1 | 0 |  | PCIE1 | 1 | PCIE1 | 0 | PCIE1 | 0 | PCIE1 | 0 | PCIE1 | 0 | PCIE1 | 0 | PCIE1 | 0
SD/SC4 |  | PCIE2 | 0 |  | PCIE2 | 0 |  | PCIE2 | 0 | PCIE2 | 1 | PCIE2 | 0 | PCIE2 | 0 | PCIE2 | 0 | PCIE2 | 0 | PCIE2 | 0
SD/SC5 |  | PCIE4 | 0 |  | PCIE4 | 0 |  | PCIE4 | 0 | PCIE4 | 0 | PCIE4 | 0 | PCIE4 | 1 | PCIE4 | 0 | PCIE4 | 0 | PCIE4 | 0
SD/SC6 |  | Pomiar_pradu_napiecia_PCIE_0 / Pomiar_pradu_napiecia_PCIE_2 | 0 |  | Pomiar_pradu_napiecia_PCIE_0 / Pomiar_pradu_napiecia_PCIE_2 | 0 |  | Pomiar_pradu_napiecia_PCIE_0 / Pomiar_pradu_napiecia_PCIE_2 | 0 | Pomiar_pradu_napiecia_PCIE_0 / Pomiar_pradu_napiecia_PCIE_2 | 0 | Pomiar_pradu_napiecia_PCIE_0 / Pomiar_pradu_napiecia_PCIE_2 | 0 | Pomiar_pradu_napiecia_PCIE_0 / Pomiar_pradu_napiecia_PCIE_2 | 0 | Pomiar_pradu_napiecia_PCIE_0 / Pomiar_pradu_napiecia_PCIE_2 | 1 | Pomiar_pradu_napiecia_PCIE_0 / Pomiar_pradu_napiecia_PCIE_2 | 0 | Pomiar_pradu_napiecia_PCIE_0 / Pomiar_pradu_napiecia_PCIE_2 | 0
SD/SC7 |  | Pomiar_pradu_napiecia_PCIE_3 | 0 |  | Pomiar_pradu_napiecia_PCIE_3 | 0 |  | Pomiar_pradu_napiecia_PCIE_3 | 0 | Pomiar_pradu_napiecia_PCIE_3 | 0 | Pomiar_pradu_napiecia_PCIE_3 | 0 | Pomiar_pradu_napiecia_PCIE_3 | 0 | Pomiar_pradu_napiecia_PCIE_3 | 1 | Pomiar_pradu_napiecia_PCIE_3 | 0 | Pomiar_pradu_napiecia_PCIE_3 | 0
 |  | wylacz | 00000000 |  | PCIE0 | 00000010 |  | PCIE1 | 00001000 | PCIE2 | 00010000 | PCIE3 | 00000001 | PCIE4 | 00100000 | Curr_Volt_Meas | 11000100 | wolne | 00000000 | wolne | 00000000
 |  | ctrl_reg | 0x00 |  | ctrl_reg | 0x02 |  | ctrl_reg | 0x08 | ctrl_reg | 0x10 | ctrl_reg | 0x01 | ctrl_reg | 0x20 | ctrl_reg | 0xC4 | ctrl_reg | 0x00 | ctrl_reg | 0x00
device
bridge | TCA9548 | I2C_Bridge_PCIE
i2c_addr | 0x71
i2c_num | /dev/i2c-1
#I2C_Bridge_PCIE:wylacz
device | TCA9548 |  |  | ZŁĄCZ.TEKSTY($B$16;" ";$C$16;" ";ADR.POŚR(H32)) | 3 | 11 | $C$11
i2c_addr | 0x71
i2c_num | /dev/i2c-1 |  |  |  |  |  | $C$12
ctrl_reg | 0x00 |  |  |  |  |  | $D$12
time | 10
#I2C_Bridge_PCIE:PCIE0
device | TCA9548 |  |  | ZŁĄCZ.TEKSTY($B$16;" ";$C$16;" ";ADR.POŚR(H32)) | 6 | 11 | $F$11
i2c_addr | 0x71
i2c_num | /dev/i2c-1 |  |  |  |  |  | $F$12
ctrl_reg | 0x02 |  |  |  |  |  | $G$12
time | 10
#I2C_Bridge_PCIE:PCIE1
device | TCA9548 |  |  | ZŁĄCZ.TEKSTY($B$16;" ";$C$16;" ";ADR.POŚR(H32)) | 9 | 11 | $I$11
i2c_addr | 0x71
i2c_num | /dev/i2c-1 |  |  |  |  |  | $I$12
ctrl_reg | 0x08 |  |  |  |  |  | $J$12
time | 11
#I2C_Bridge_PCIE:PCIE2
device | TCA9548 |  |  | ZŁĄCZ.TEKSTY($B$16;" ";$C$16;" ";ADR.POŚR(H32)) | 12 | 11 | $L$11
i2c_addr | 0x71
i2c_num | /dev/i2c-1 |  |  |  |  |  | $L$12
ctrl_reg | 0x10 |  |  |  |  |  | $M$12
time | 11
#I2C_Bridge_PCIE:PCIE3
device | TCA9548 |  |  | ZŁĄCZ.TEKSTY($B$16;" ";$C$16;" ";ADR.POŚR(H32)) | 15 | 11 | $O$11
i2c_addr | 0x71
i2c_num | /dev/i2c-1 |  |  |  |  |  | $O$12
ctrl_reg | 0x01 |  |  |  |  |  | $P$12
time | 12
#I2C_Bridge_PCIE:PCIE4
device | TCA9548 |  |  | ZŁĄCZ.TEKSTY($B$16;" ";$C$16;" ";ADR.POŚR(H32)) | 18 | 11 | $R$11
i2c_addr | 0x71
i2c_num | /dev/i2c-1 |  |  |  |  |  | $R$12
ctrl_reg | 0x20 |  |  |  |  |  | $S$12
time | 12
#I2C_Bridge_PCIE:Curr_Volt_Meas
device | TCA9548 |  |  | ZŁĄCZ.TEKSTY($B$16;" ";$C$16;" ";ADR.POŚR(H32)) | 21 | 11 | $U$11
i2c_addr | 0x71
i2c_num | /dev/i2c-1 |  |  |  |  |  | $U$12
ctrl_reg | 0xC4 |  |  |  |  |  | $V$12
time | 13
#I2C_Bridge_PCIE:wolne
device | TCA9548 |  |  | ZŁĄCZ.TEKSTY($B$16;" ";$C$16;" ";ADR.POŚR(H32)) | 24 | 11 | $X$11
i2c_addr | 0x71
i2c_num | /dev/i2c-1 |  |  |  |  |  | $X$12
ctrl_reg | 0x00 |  |  |  |  |  | $Y$12
time | 13
#I2C_Bridge_PCIE:wolne
device | TCA9548 |  |  | ZŁĄCZ.TEKSTY($B$16;" ";$C$16;" ";ADR.POŚR(H32)) | 27 | 11 | $AA$11
i2c_addr | 0x71
i2c_num | /dev/i2c-1 |  |  |  |  |  | $AA$12
ctrl_reg | 0x00 |  |  |  |  |  | $AB$12
time | 14
#I2C_Bridge_PCIE:
device | TCA9548 |  |  | ZŁĄCZ.TEKSTY($B$16;" ";$C$16;" ";ADR.POŚR(H32)) | 30 | 11 | $AD$11
i2c_addr | 0x71
i2c_num | /dev/i2c-1 |  |  |  |  |  | $AD$12
0 | 0 |  |  |  |  |  | $AE$12
time | 14

Sheet: I2C_Expander_Main_Rst
 | PIN | opis pinu | komentarz | wartość safe | etap 1 | etap 2 | etap 3 | etap -disable clocks | etap 5 | etap 6 | etap 7 | etap 8 | etap 9 | etap 10 | pins_mode safe 0 - out | pins_mode etap1 | pins_mode etap2 | pins_mode etap3 | pins_mode etap4 | pins_mode etap5 | pins_mode etap6 | pins_mode etap7 | pins_mode etap8 | pins_mode etap9 | pins_mode etap10 | pins_pull_up safe 1 - enable | pins_pull_up etap 1 | pins_pull_up etap 2 | pins_pull_up etap 3 | pins_pull_up etap 4 | pins_pull_up etap 5 | pins_pull_up etap 6 | pins_pull_up etap 7 | pins_pull_up etap 8 | pins_pull_up etap 9 | pins_pull_up etap 10 | pin_int safe 1 - enable | pin_int etap 1 | pin_int etap 2 | pin_int etap 3 | pin_int etap 4 | pin_int etap 5 | pin_int etap 6 | pin_int etap 7 | pin_int etap 8 | pin_int etap 9 | pin_int etap 10 | Pin_def_state
 | GPA0 | GPIO_Exp_Reset0 | reset dla ekspanderów wyjść z grupy I2c_Expander_0x | 0 | 1 | 1 | 1 | 1 | 1 | 1 | 1 | 1 | 1 | 1 | 0 | 0 | 0 | 0 | 0 | 0 | 0 | 0 | 0 | 0 | 0 | 0 | 0 | 0 | 0 | 0 | 0 | 0 | 0 | 0 | 0 | 0 | 0 | 0 | 0 | 0 | 0 | 0 | 0 | 0 | 0 | 0 | 0 | 0 | 0 | 0 | 0 | 0 | 0 | 0 | 0
 | GPA1 | GPIO_Exp_Reset1 | reset dla ekspanderów wyjść z grupy I2c_Expander_0x | 0 | 1 | 1 | 1 | 1 | 1 | 1 | 1 | 1 | 1 | 1 | 0 | 0 | 0 | 0 | 0 | 0 | 0 | 0 | 0 | 0 | 0 | 0 | 0 | 0 | 0 | 0 | 0 | 0 | 0 | 0 | 0 | 0 | 0 | 0 | 0 | 0 | 0 | 0 | 0 | 0 | 0 | 0 | 0 | 0 | 0 | 0 | 0 | 0 | 0 | 0 | 0
 | GPA2 | GPIO_Exp_Reset2 | nie podłączone | 0 | 1 | 1 | 1 | 1 | 1 | 1 | 1 | 1 | 1 | 1 | 0 | 0 | 0 | 0 | 0 | 0 | 0 | 0 | 0 | 0 | 0 | 0 | 0 | 0 | 0 | 0 | 0 | 0 | 0 | 0 | 0 | 0 | 0 | 0 | 0 | 0 | 0 | 0 | 0 | 0 | 0 | 0 | 0 | 0 | 0 | 0 | 0 | 0 | 0 | 0 | 0
 | GPA3 | none | nie podłączone | 0 | 0 | 0 | 0 | 0 | 0 | 0 | 0 | 0 | 0 | 0 | 1 | 1 | 1 | 1 | 1 | 1 | 1 | 1 | 1 | 1 | 1 | 0 | 0 | 0 | 0 | 0 | 0 | 0 | 0 | 0 | 0 | 0 | 0 | 0 | 0 | 0 | 0 | 0 | 0 | 0 | 0 | 0 | 0 | 0 | 0 | 0 | 0 | 0 | 0 | 0 | 0
 | GPA4 | none | nie podłączone | 0 | 0 | 0 | 0 | 0 | 0 | 0 | 0 | 0 | 0 | 0 | 1 | 1 | 1 | 1 | 1 | 1 | 1 | 1 | 1 | 1 | 1 | 0 | 0 | 0 | 0 | 0 | 0 | 0 | 0 | 0 | 0 | 0 | 0 | 0 | 0 | 0 | 0 | 0 | 0 | 0 | 0 | 0 | 0 | 0 | 0 | 0 | 0 | 0 | 0 | 0 | 0
 | GPA5 | none | nie podłączone | 0 | 0 | 0 | 0 | 0 | 0 | 0 | 0 | 0 | 0 | 0 | 1 | 1 | 1 | 1 | 1 | 1 | 1 | 1 | 1 | 1 | 1 | 0 | 0 | 0 | 0 | 0 | 0 | 0 | 0 | 0 | 0 | 0 | 0 | 0 | 0 | 0 | 0 | 0 | 0 | 0 | 0 | 0 | 0 | 0 | 0 | 0 | 0 | 0 | 0 | 0 | 0
 | GPA6 | none | nie podłączone | 0 | 0 | 0 | 0 | 0 | 0 | 0 | 0 | 0 | 0 | 0 | 1 | 1 | 1 | 1 | 1 | 1 | 1 | 1 | 1 | 1 | 1 | 0 | 0 | 0 | 0 | 0 | 0 | 0 | 0 | 0 | 0 | 0 | 0 | 0 | 0 | 0 | 0 | 0 | 0 | 0 | 0 | 0 | 0 | 0 | 0 | 0 | 0 | 0 | 0 | 0 | 0
 | GPA7 | none | nie podłączone | 0 | 0 | 0 | 0 | 0 | 0 | 0 | 0 | 0 | 0 | 0 | 1 | 1 | 1 | 1 | 1 | 1 | 1 | 1 | 1 | 1 | 1 | 0 | 0 | 0 | 0 | 0 | 0 | 0 | 0 | 0 | 0 | 0 | 0 | 0 | 0 | 0 | 0 | 0 | 0 | 0 | 0 | 0 | 0 | 0 | 0 | 0 | 0 | 0 | 0 | 0 | 0
 |  |  |  | 00000000 | 00000111 | 00000111 | 00000111 | 00000111 | 00000111 | 00000111 | 00000111 | 00000111 | 00000111 | 00000111 | 11111000 | 11111000 | 11111000 | 11111000 | 11111000 | 11111000 | 11111000 | 11111000 | 11111000 | 11111000 | 11111000 | 00000000 | 00000000 | 00000000 | 00000000 | 00000000 | 00000000 | 00000000 | 00000000 | 00000000 | 00000000 | 00000000 | 00000000 | 00000000 | 00000000 | 00000000 | 00000000 | 00000000 | 00000000 | 00000000 | 00000000 | 00000000 | 00000000 | 00000000 | 00000000 | 00000000 | 00000000 | 00000000 | 00000000 | 00000000 | 00000000
 |  |  |  | 00 | 07 | 07 | 07 | 07 | 07 | 07 | 07 | 07 | 07 | 07 | F8 | F8 | F8 | F8 | F8 | F8 | F8 | F8 | F8 | F8 | F8 | 00 | 00 | 00 | 00 | 00 | 00 | 00 | 00 | 00 | 00 | 00 | 00 | 00 | 00 | 00 | 00 | 00 | 00 | 00 | 00 | 00 | 00 | 00 | 00 | 00 | 00 | 00 | 00 | 00 | 00
 | GPB0 | none | niepodłączone | 0 | 0 | 0 | 0 | 0 | 0 | 0 | 0 | 0 | 0 | 0 | 1 | 1 | 1 | 1 | 1 | 1 | 1 | 1 | 1 | 1 | 1 | 0 | 0 | 0 | 0 | 0 | 0 | 0 | 0 | 0 | 0 | 0 | 0 | 0 | 0 | 0 | 0 | 0 | 0 | 0 | 0 | 0 | 0 | 0 | 0 | 0 | 0 | 0 | 0 | 0 | 0
 | GPB1 | Reset_ExpSupp | reset expandera w sekcji zasilania dystrybutorów zegara | 0 | 1 | 1 | 1 | 1 | 1 | 1 | 1 | 1 | 1 | 1 | 0 | 0 | 0 | 0 | 0 | 0 | 0 | 0 | 0 | 0 | 0 | 0 | 0 | 0 | 0 | 0 | 0 | 0 | 0 | 0 | 0 | 0 | 0 | 0 | 0 | 0 | 0 | 0 | 0 | 0 | 0 | 0 | 0 | 0 | 0 | 0 | 0 | 0 | 0 | 0 | 0
 | GPB2 | PWR_ExtIO_Reset | reset expandera w sekcji zasilania | 0 | 1 | 1 | 1 | 1 | 1 | 1 | 1 | 1 | 1 | 1 | 0 | 0 | 0 | 0 | 0 | 0 | 0 | 0 | 0 | 0 | 0 | 0 | 0 | 0 | 0 | 0 | 0 | 0 | 0 | 0 | 0 | 0 | 0 | 0 | 0 | 0 | 0 | 0 | 0 | 0 | 0 | 0 | 0 | 0 | 0 | 0 | 0 | 0 | 0 | 0 | 0
 | GPB3 | SFP_Reset | reset expandera w sekcji SFP | 0 | 1 | 1 | 1 | 1 | 1 | 1 | 1 | 1 | 1 | 1 | 0 | 0 | 0 | 0 | 0 | 0 | 0 | 0 | 0 | 0 | 0 | 0 | 0 | 0 | 0 | 0 | 0 | 0 | 0 | 0 | 0 | 0 | 0 | 0 | 0 | 0 | 0 | 0 | 0 | 0 | 0 | 0 | 0 | 0 | 0 | 0 | 0 | 0 | 0 | 0 | 0
 | GPB4 | RST_Bridge | reset bridge'a w sekcji SFP | 0 | 1 | 1 | 1 | 1 | 1 | 1 | 1 | 1 | 1 | 1 | 0 | 0 | 0 | 0 | 0 | 0 | 0 | 0 | 0 | 0 | 0 | 0 | 0 | 0 | 0 | 0 | 0 | 0 | 0 | 0 | 0 | 0 | 0 | 0 | 0 | 0 | 0 | 0 | 0 | 0 | 0 | 0 | 0 | 0 | 0 | 0 | 0 | 0 | 0 | 0 | 0
 | GPB5 | Enable_CLK | aktywacja dystrybutorów zegarów | 1 | 0 | 1 | 1 | 0 | 0 | 0 | 0 | 0 | 0 | 0 | 0 | 0 | 0 | 0 | 0 | 0 | 0 | 0 | 0 | 0 | 0 | 0 | 0 | 0 | 0 | 0 | 0 | 0 | 0 | 0 | 0 | 0 | 0 | 0 | 0 | 0 | 0 | 0 | 0 | 0 | 0 | 0 | 0 | 0 | 0 | 0 | 0 | 0 | 0 | 0 | 0
 | GPB6 | Reset_Bridge_Exp | reset bridge'a w sekcji GPIO | 0 | 1 | 1 | 1 | 1 | 1 | 1 | 1 | 1 | 1 | 1 | 0 | 0 | 0 | 0 | 0 | 0 | 0 | 0 | 0 | 0 | 0 | 0 | 0 | 0 | 0 | 0 | 0 | 0 | 0 | 0 | 0 | 0 | 0 | 0 | 0 | 0 | 0 | 0 | 0 | 0 | 0 | 0 | 0 | 0 | 0 | 0 | 0 | 0 | 0 | 0 | 0
 | GPB7 | none |  | 0 | 0 | 0 | 0 | 0 | 0 | 0 | 0 | 0 | 0 | 0 | 1 | 1 | 1 | 1 | 1 | 1 | 1 | 1 | 1 | 1 | 1 | 0 | 0 | 0 | 0 | 0 | 0 | 0 | 0 | 0 | 0 | 0 | 0 | 0 | 0 | 0 | 0 | 0 | 0 | 0 | 0 | 0 | 0 | 0 | 0 | 0 | 0 | 0 | 0 | 0 | 0
 |  |  |  | 00100000 | 01011110 | 01111110 | 01111110 | 01011110 | 01011110 | 01011110 | 01011110 | 01011110 | 01011110 | 01011110 | 10000001 | 10000001 | 10000001 | 10000001 | 10000001 | 10000001 | 10000001 | 10000001 | 10000001 | 10000001 | 10000001 | 00000000 | 00000000 | 00000000 | 00000000 | 00000000 | 00000000 | 00000000 | 00000000 | 00000000 | 00000000 | 00000000 | 00000000 | 00000000 | 00000000 | 00000000 | 00000000 | 00000000 | 00000000 | 00000000 | 00000000 | 00000000 | 00000000 | 00000000 | 00000000 | 00000000 | 00000000 | 00000000 | 00000000 | 00000000 | 00000000
 |  |  |  | 20 | 5E | 7E | 7E | 5E | 5E | 5E | 5E | 5E | 5E | 5E | 81 | 81 | 81 | 81 | 81 | 81 | 81 | 81 | 81 | 81 | 81 | 00 | 00 | 00 | 00 | 00 | 00 | 00 | 00 | 00 | 00 | 00 | 00 | 00 | 00 | 00 | 00 | 00 | 00 | 00 | 00 | 00 | 00 | 00 | 00 | 00 | 00 | 00 | 00 | 00 | 00
 |  |  | pins_state | 0x2000 | 0x5E07 | 0x7E07 | 0x7E07 | 0x5E07 | 0x5E07 | 0x5E07 | 0x5E07 | 0x5E07 | 0x5E07 | 0x5E07 | 0x81F8 | 0x81F8 | 0x81F8 | 0x81F8 | 0x81F8 | 0x81F8 | 0x81F8 | 0x81F8 | 0x81F8 | 0x81F8 | 0x81F8 | 0x0000 | 0x0000 | 0x0000 | 0x0000 | 0x0000 | 0x0000 | 0x0000 | 0x0000 | 0x0000 | 0x0000 | 0x0000 | 0x0000 | 0x0000 | 0x0000 | 0x0000 | 0x0000 | 0x0000 | 0x0000 | 0x0000 | 0x0000 | 0x0000 | 0x0000 | 0x0000 | 0x0000 | 0x0000 | 0x0000 | 0x0000 | 0x0000 | 0x0000 | 0x0000
 |  |  | pins_mode | 0x81F8 | 0x81F8 | 0x81F8 | 0x81F8 | 0x81F8 | 0x81F8 | 0x81F8 | 0x81F8 | 0x81F8 | 0x81F8 | 0x81F8 | pins_mode |  |  |  |  |  |  |  |  |  |  | pins_pull_up |  |  |  |  |  |  |  |  |  |  | #pins_int |  |  |  |  |  |  |  |  |  |  | #pins_def_val
device |  |  | pins_pull_up | 0x0000 | 0x0000 | 0x0000 | 0x0000 | 0x0000 | 0x0000 | 0x0000 | 0x0000 | 0x0000 | 0x0000 | 0x0000
# nazwa układu | MCP23017 | I2C_Expander_Main_Rst | #pins_int | 0x0000 | 0x0000 | 0x0000 | 0x0000 | 0x0000 | 0x0000 | 0x0000 | 0x0000 | 0x0000 | 0x0000 | 0x0000
czas pomiędzy wartość safe a krok 1 [ms] | 500 |  | #pins_def_val | 0x0000 | 0x0000 | 0x0000 | 0x0000 | 0x0000 | 0x0000 | 0x0000 | 0x0000 | 0x0000 | 0x0000 | 0x0000
Czas pomiędzy etap 1, a etap 2 | 10
Czas pomiędzy etap 2, a etap 3 | 0
addr | 0x24
#I2C_Expander_Main_Rst:wartość safe
device | MCP23017 |  |  |  | 5 | 11 | $E$11
i2c_addr | 0x24 |  |  |  |  |  | $E$1
i2c_num | /dev/i2c-1
pins_mode | 0x81F8 |  |  |  |  | $Q$24 | $Q$23
pins_state | 0x2000 |  |  |  |  | $D$23 | $E$23
time | 500
#I2C_Expander_Main_Rst:etap 1
device | MCP23017 |  |  |  | 6 | 11 | $F$11
i2c_addr | 0x24 |  |  |  |  |  | $F$1
i2c_num | /dev/i2c-1
pins_mode | 0x81F8 |  |  |  |  | d24 | $F$24
pins_state | 0x5E07 |  |  |  |  | d23 | $F$23
pins_pull_up | 0x0000 |  |  |  |  | d25 | $F$25
#pins_int | 0x0000 |  |  |  |  | d26 | $F$26
#pins_def_val | 0x0000 |  |  |  |  | d27 | $F$27
time | 10
#I2C_Expander_Main_Rst:etap 2
device | MCP23017 |  |  |  | 7 | 11 | $G$11
i2c_addr | 0x24 |  |  |  |  |  | $G$1
i2c_num | /dev/i2c-1
pins_mode | 0x81F8 |  |  |  |  | d24 | $G$24
pins_state | 0x7E07 |  |  |  |  | d23 | $G$23
pins_pull_up | 0x0000 |  |  |  |  | d25 | $G$25
#pins_int | 0x0000 |  |  |  |  | d26 | $G$26
#pins_def_val | 0x0000 |  |  |  |  | d27 | $G$27
time | 10
#I2C_Expander_Main_Rst:etap 3
device | MCP23017 |  |  |  | 8 | 11 | $H$11
i2c_addr | 0x24 |  |  |  |  |  | $H$1
i2c_num | /dev/i2c-1
pins_mode | 0x81F8 |  |  |  |  | d24 | $H$24
pins_state | 0x7E07 |  |  |  |  | d23 | $H$23
pins_pull_up | 0x0000 |  |  |  |  | d25 | $H$25
#pins_int | 0x0000 |  |  |  |  | d26 | $H$26
#pins_def_val | 0x0000 |  |  |  |  | d27 | $H$27
#pins_int | 10
#I2C_Expander_Main_Rst:etap -disable clocks
device | MCP23017 |  |  |  | 9 | 11 | $I$11
i2c_addr | 0x24 |  |  |  |  |  | $I$1
i2c_num | /dev/i2c-1
pins_mode | 0x81F8 |  |  |  |  | d24 | $I$24
pins_state | 0x5E07 |  |  |  |  | d23 | $I$23
pins_pull_up | 0x0000 |  |  |  |  | d25 | $I$25
#pins_int | 0x0000 |  |  |  |  | d26 | $I$26
#pins_def_val | 0x0000 |  |  |  |  | d27 | $I$27
#pins_int | 10
#I2C_Expander_Main_Rst:etap 5
device | MCP23017 |  |  |  | 10 | 11 | $J$11
i2c_addr | 0x24 |  |  |  |  |  | $J$1
i2c_num | /dev/i2c-1
pins_mode | 0x81F8 |  |  |  |  | d24 | $J$24
pins_state | 0x5E07 |  |  |  |  | d23 | $J$23
pins_pull_up | 0x0000 |  |  |  |  | d25 | $J$25
#pins_int | 0x0000 |  |  |  |  | d26 | $J$26
#pins_def_val | 0x0000 |  |  |  |  | d27 | $J$27
#pins_int | 10
#I2C_Expander_Main_Rst:etap 6
device | MCP23017 |  |  |  | 11 | 11 | $K$11
i2c_addr | 0x24 |  |  |  |  |  | $K$1
i2c_num | /dev/i2c-1
pins_mode | 0x81F8 |  |  |  |  | d24 | $K$24
pins_state | 0x5E07 |  |  |  |  | d23 | $K$23
pins_pull_up | 0x0000 |  |  |  |  | d25 | $K$25
#pins_int | 0x0000 |  |  |  |  | d26 | $K$26
#pins_def_val | 0x0000 |  |  |  |  | d27 | $K$27
#pins_int | 10
#I2C_Expander_Main_Rst:etap 7
device | MCP23017 |  |  |  | 12 | 11 | $L$11
i2c_addr | 0x24 |  |  |  |  |  | $L$1
i2c_num | /dev/i2c-1
pins_mode | 0x81F8 |  |  |  |  | d24 | $L$24
pins_state | 0x5E07 |  |  |  |  | d23 | $L$23
pins_pull_up | 0x0000 |  |  |  |  | d25 | $L$25
#pins_int | 0x0000 |  |  |  |  | d26 | $L$26
#pins_def_val | 0x0000 |  |  |  |  | d27 | $L$27
#pins_int | 10
#I2C_Expander_Main_Rst:etap 8
device | MCP23017 |  |  |  | 13 | 11 | $M$11
i2c_addr | 0x24 |  |  |  |  |  | $M$1
i2c_num | /dev/i2c-1
pins_mode | 0x81F8 |  |  |  |  | d24 | $M$24
pins_state | 0x5E07 |  |  |  |  | d23 | $M$23
pins_pull_up | 0x0000 |  |  |  |  | d25 | $M$25
#pins_int | 0x0000 |  |  |  |  | d26 | $M$26
#pins_def_val | 0x0000 |  |  |  |  | d27 | $M$27
#pins_int | 10
#I2C_Expander_Main_Rst:etap 9
device | MCP23017 |  |  |  | 14 | 11 | $N$11
i2c_addr | 0x24 |  |  |  |  |  | $N$1
i2c_num | /dev/i2c-1
pins_mode | 0x81F8 |  |  |  |  | d24 | $N$24
pins_state | 0x5E07 |  |  |  |  | d23 | $N$23
pins_pull_up | 0x0000 |  |  |  |  | d25 | $N$25
#pins_int | 0x0000 |  |  |  |  | d26 | $N$26
#pins_def_val | 0x0000 |  |  |  |  | d27 | $N$27
#pins_int | 10
#I2C_Expander_Main_Rst:etap 10
device | MCP23017 |  |  |  | 15 | 11 | $O$11
i2c_addr | 0x24 |  |  |  |  |  | $O$1
i2c_num | /dev/i2c-1
pins_mode | 0x81F8 |  |  |  |  | d24 | $O$24
pins_state | 0x5E07 |  |  |  |  | d23 | $O$23
pins_pull_up | 0x0000 |  |  |  |  | d25 | $O$25
#pins_int | 0x0000 |  |  |  |  | d26 | $O$26
#pins_def_val | 0x0000 |  |  |  |  | d27 | $O$27
#pins_int | 10

Sheet: I2C_Expander_PWR_CLK
 | PIN | opis pinu na schemacie | komentarz | wartość safe | etap 1 | etap 2 | etap 3- poweroff WR | power of all clk | etap 5 | etap 6 | etap 7 | etap 8 | etap 9 | etap 10 | pins_mode 0 - out | pins_mode etap1 | pins_mode etap2 | pins_mode etap3 | pins_mode etap4 | pins_mode etap5 | pins_mode etap6 | pins_mode etap7 | pins_mode etap8 | pins_mode etap9 | pins_mode etap10 | pins_pull_up 1 - enable | pins_pull_up etap 1 | pins_pull_up etap 2 | pins_pull_up etap 3 | pins_pull_up etap 4 | pins_pull_up etap 5 | pins_pull_up etap 6 | pins_pull_up etap 7 | pins_pull_up etap 8 | pins_pull_up etap 9 | pins_pull_up etap 10 | pin_int safe 1 - enable | pin_int etap 1 | pin_int etap 2 | pin_int etap 3 | pin_int etap 4 | pin_int etap 5 | pin_int etap 6 | pin_int etap 7 | pin_int etap 8 | pin_int etap 9 | pin_int etap 10 | Pin_def_state
 | GPA0 | PG_PS_LTC6952_1 | sygnał zwrotny dotyczący poprawnej pracy zasilacza dystrybutora LTC6952_1 | 0 | 0 | 0 | 0 | 0 | 0 | 0 | 0 | 0 | 0 | 0 | 1 | 1 | 1 | 1 | 1 | 1 | 1 | 1 | 1 | 1 | 1 | 1 | 1 | 1 | 1 | 1 | 1 | 1 | 1 | 1 | 1 | 1 | 0 | 0 | 0 | 0 | 0 | 0 | 0 | 0 | 0 | 0 | 0 | 0 | 0 | 0 | 0 | 0 | 0 | 0 | 0
 | GPA1 | EN_PS_LTC6952_1 | uruchamianie zasilacza dystrybutora LTC6952_1 | 1 | 1 | 1 | 1 | 0 | 0 | 0 | 0 | 0 | 0 | 0 | 0 | 0 | 0 | 0 | 0 | 0 | 0 | 0 | 0 | 0 | 0 | 0 | 0 | 0 | 0 | 0 | 0 | 0 | 0 | 0 | 0 | 0 | 0 | 0 | 0 | 0 | 0 | 0 | 0 | 0 | 0 | 0 | 0 | 0 | 0 | 0 | 0 | 0 | 0 | 0 | 0
 | GPA2 | PG_PS_LN_3.3V | sygnał zwrotny dotyczący sygnały niskoszumnego dla dystrybutorów zegara | 0 | 0 | 0 | 0 | 0 | 0 | 0 | 0 | 0 | 0 | 0 | 1 | 1 | 1 | 1 | 1 | 1 | 1 | 1 | 1 | 1 | 1 | 1 | 1 | 1 | 1 | 1 | 1 | 1 | 1 | 1 | 1 | 1 | 0 | 0 | 0 | 0 | 0 | 0 | 0 | 0 | 0 | 0 | 0 | 0 | 0 | 0 | 0 | 0 | 0 | 0 | 0
 | GPA3 | EN_PS_LN_3.3V | włączanie zasilania niskoszumnego dla dystrybutorów zasilania | 1 | 1 | 1 | 1 | 0 | 0 | 0 | 0 | 0 | 0 | 0 | 0 | 0 | 0 | 0 | 0 | 0 | 0 | 0 | 0 | 0 | 0 | 0 | 0 | 0 | 0 | 0 | 0 | 0 | 0 | 0 | 0 | 0 | 0 | 0 | 0 | 0 | 0 | 0 | 0 | 0 | 0 | 0 | 0 | 0 | 0 | 0 | 0 | 0 | 0 | 0 | 0
 | GPA4 | PG_PS_LTC6952_2 | sygnał zwrotny dotyczący poprawnej pracy zasilacza dystrybutora LTC6952_2 | 0 | 0 | 0 | 0 | 0 | 0 | 0 | 0 | 0 | 0 | 0 | 1 | 1 | 1 | 1 | 1 | 1 | 1 | 1 | 1 | 1 | 1 | 1 | 1 | 1 | 1 | 1 | 1 | 1 | 1 | 1 | 1 | 1 | 0 | 0 | 0 | 0 | 0 | 0 | 0 | 0 | 0 | 0 | 0 | 0 | 0 | 0 | 0 | 0 | 0 | 0 | 0
 | GPA5 | EN_PS_LTC6952_2 | uruchamianie zasilacza dystrybutora LTC6952_2 | 1 | 1 | 1 | 1 | 0 | 0 | 0 | 0 | 0 | 0 | 0 | 0 | 0 | 0 | 0 | 0 | 0 | 0 | 0 | 0 | 0 | 0 | 0 | 0 | 0 | 0 | 0 | 0 | 0 | 0 | 0 | 0 | 0 | 0 | 0 | 0 | 0 | 0 | 0 | 0 | 0 | 0 | 0 | 0 | 0 | 0 | 0 | 0 | 0 | 0 | 0 | 0
 | GPA6 | PG_PS_LTC6952_3 | niepodłączone | 0 | 0 | 0 | 0 | 0 | 0 | 0 | 0 | 0 | 0 | 0 | 1 | 1 | 1 | 1 | 1 | 1 | 1 | 1 | 1 | 1 | 1 | 1 | 1 | 1 | 1 | 1 | 1 | 1 | 1 | 1 | 1 | 1 | 0 | 0 | 0 | 0 | 0 | 0 | 0 | 0 | 0 | 0 | 0 | 0 | 0 | 0 | 0 | 0 | 0 | 0 | 0
 | GPA7 | EN_PS_LTC6952_3 | niepodłączone | 0 | 0 | 0 | 0 | 0 | 0 | 0 | 0 | 0 | 0 | 0 | 1 | 1 | 1 | 1 | 1 | 1 | 1 | 1 | 1 | 1 | 1 | 0 | 0 | 0 | 0 | 0 | 0 | 0 | 0 | 0 | 0 | 0 | 0 | 0 | 0 | 0 | 0 | 0 | 0 | 0 | 0 | 0 | 0 | 0 | 0 | 0 | 0 | 0 | 0 | 0 | 0
 |  |  |  | 00101010 | 00101010 | 00101010 | 00101010 | 00000000 | 00000000 | 00000000 | 00000000 | 00000000 | 00000000 | 00000000 | 11010101 | 11010101 | 11010101 | 11010101 | 11010101 | 11010101 | 11010101 | 11010101 | 11010101 | 11010101 | 11010101 | 01010101 | 01010101 | 01010101 | 01010101 | 01010101 | 01010101 | 01010101 | 01010101 | 01010101 | 01010101 | 01010101 | 00000000 | 00000000 | 00000000 | 00000000 | 00000000 | 00000000 | 00000000 | 00000000 | 00000000 | 00000000 | 00000000 | 00000000 | 00000000 | 00000000 | 00000000 | 00000000 | 00000000 | 00000000 | 00000000
 |  |  |  | 2A | 2A | 2A | 2A | 00 | 00 | 00 | 00 | 00 | 00 | 00 | D5 | D5 | D5 | D5 | D5 | D5 | D5 | D5 | D5 | D5 | D5 | 55 | 55 | 55 | 55 | 55 | 55 | 55 | 55 | 55 | 55 | 55 | 00 | 00 | 00 | 00 | 00 | 00 | 00 | 00 | 00 | 00 | 00 | 00 | 00 | 00 | 00 | 00 | 00 | 00 | 00
 | GPB0 | PG_PS_CP_5V0_1 | sygnał powrotny z niesterowanego zasilacza niskoszumnego na 5V dla DAC-a oraz pompy na dystrybutorze LTC6952_1 | 0 | 0 | 0 | 0 | 0 | 0 | 0 | 0 | 0 | 0 | 0 | 1 | 1 | 1 | 1 | 1 | 1 | 1 | 1 | 1 | 1 | 1 | 1 | 1 | 1 | 1 | 1 | 1 | 1 | 1 | 1 | 1 | 1 | 0 | 0 | 0 | 0 | 0 | 0 | 0 | 0 | 0 | 0 | 0 | 0 | 0 | 0 | 0 | 0 | 0 | 0 | 0
 | GPB1 | Enable_TPS7A88_1 | włączanie zasilania dla dystrybutora WR | 1 | 1 | 1 | 0 | 0 | 0 | 0 | 0 | 0 | 0 | 0 | 0 | 0 | 0 | 0 | 0 | 0 | 0 | 0 | 0 | 0 | 0 | 0 | 0 | 0 | 0 | 0 | 0 | 0 | 0 | 0 | 0 | 0 | 0 | 0 | 0 | 0 | 0 | 0 | 0 | 0 | 0 | 0 | 0 | 0 | 0 | 0 | 0 | 0 | 0 | 0 | 0
 | GPB2 | Enable_TPS7A88_2 | włączanie zasilania dla dystrybutora WR | 1 | 1 | 1 | 0 | 0 | 0 | 0 | 0 | 0 | 0 | 0 | 0 | 0 | 0 | 0 | 0 | 0 | 0 | 0 | 0 | 0 | 0 | 0 | 0 | 0 | 0 | 0 | 0 | 0 | 0 | 0 | 0 | 0 | 0 | 0 | 0 | 0 | 0 | 0 | 0 | 0 | 0 | 0 | 0 | 0 | 0 | 0 | 0 | 0 | 0 | 0 | 0
 | GPB3 | PG_TPS7A88_1 | potwierdzenie poprawności uruchomienia zasilacza WR | 0 | 0 | 0 | 0 | 0 | 0 | 0 | 0 | 0 | 0 | 0 | 1 | 1 | 1 | 1 | 1 | 1 | 1 | 1 | 1 | 1 | 1 | 1 | 1 | 1 | 1 | 1 | 1 | 1 | 1 | 1 | 1 | 1 | 0 | 0 | 0 | 0 | 0 | 0 | 0 | 0 | 0 | 0 | 0 | 0 | 0 | 0 | 0 | 0 | 0 | 0 | 0
 | GPB4 | PG_TPS7A88_2 | potwierdzenie poprawności uruchomienia zasilacza WR | 0 | 0 | 0 | 0 | 0 | 0 | 0 | 0 | 0 | 0 | 0 | 1 | 1 | 1 | 1 | 1 | 1 | 1 | 1 | 1 | 1 | 1 | 1 | 1 | 1 | 1 | 1 | 1 | 1 | 1 | 1 | 1 | 1 | 0 | 0 | 0 | 0 | 0 | 0 | 0 | 0 | 0 | 0 | 0 | 0 | 0 | 0 | 0 | 0 | 0 | 0 | 0
 | GPB5 | none | niepodłączone | 0 | 0 | 0 | 0 | 0 | 0 | 0 | 0 | 0 | 0 | 0 | 1 | 1 | 1 | 1 | 1 | 1 | 1 | 1 | 1 | 1 | 1 | 0 | 0 | 0 | 0 | 0 | 0 | 0 | 0 | 0 | 0 | 0 | 0 | 0 | 0 | 0 | 0 | 0 | 0 | 0 | 0 | 0 | 0 | 0 | 0 | 0 | 0 | 0 | 0 | 0 | 0
 | GPB6 | none | niepodłączone | 0 | 0 | 0 | 0 | 0 | 0 | 0 | 0 | 0 | 0 | 0 | 1 | 1 | 1 | 1 | 1 | 1 | 1 | 1 | 1 | 1 | 1 | 0 | 0 | 0 | 0 | 0 | 0 | 0 | 0 | 0 | 0 | 0 | 0 | 0 | 0 | 0 | 0 | 0 | 0 | 0 | 0 | 0 | 0 | 0 | 0 | 0 | 0 | 0 | 0 | 0 | 0
 | GPB7 | none | niepodłączone | 0 | 0 | 0 | 0 | 0 | 0 | 0 | 0 | 0 | 0 | 0 | 1 | 1 | 1 | 1 | 1 | 1 | 1 | 1 | 1 | 1 | 1 | 0 | 0 | 0 | 0 | 0 | 0 | 0 | 0 | 0 | 0 | 0 | 0 | 0 | 0 | 0 | 0 | 0 | 0 | 0 | 0 | 0 | 0 | 0 | 0 | 0 | 0 | 0 | 0 | 0 | 0
 |  |  |  | 00000110 | 00000110 | 00000110 | 00000000 | 00000000 | 00000000 | 00000000 | 00000000 | 00000000 | 00000000 | 00000000 | 11111001 | 11111001 | 11111001 | 11111001 | 11111001 | 11111001 | 11111001 | 11111001 | 11111001 | 11111001 | 11111001 | 00011001 | 00011001 | 00011001 | 00011001 | 00011001 | 00011001 | 00011001 | 00011001 | 00011001 | 00011001 | 00011001 | 00000000 | 00000000 | 00000000 | 00000000 | 00000000 | 00000000 | 00000000 | 00000000 | 00000000 | 00000000 | 00000000 | 00000000 | 00000000 | 00000000 | 00000000 | 00000000 | 00000000 | 00000000 | 00000000
 | hex |  |  | 06 | 06 | 06 | 00 | 00 | 00 | 00 | 00 | 00 | 00 | 00 | F9 | F9 | F9 | F9 | F9 | F9 | F9 | F9 | F9 | F9 | F9 | 19 | 19 | 19 | 19 | 19 | 19 | 19 | 19 | 19 | 19 | 19 | 00 | 00 | 00 | 00 | 00 | 00 | 00 | 00 | 00 | 00 | 00 | 00 | 00 | 00 | 00 | 00 | 00 | 00 | 00
 |  |  | pins_state | 0x062A | 0x062A | 0x062A | 0x002A | 0x0000 | 0x0000 | 0x0000 | 0x0000 | 0x0000 | 0x0000 | 0x0000 | 0xF9D5 | 0xF9D5 | 0xF9D5 | 0xF9D5 | 0xF9D5 | 0xF9D5 | 0xF9D5 | 0xF9D5 | 0xF9D5 | 0xF9D5 | 0xF9D5 | 0x1955 | 0x1955 | 0x1955 | 0x1955 | 0x1955 | 0x1955 | 0x1955 | 0x1955 | 0x1955 | 0x1955 | 0x1955 | 0x0000 | 0x0000 | 0x0000 | 0x0000 | 0x0000 | 0x0000 | 0x0000 | 0x0000 | 0x0000 | 0x0000 | 0x0000 | 0x0000 | 0x0000 | 0x0000 | 0x0000 | 0x0000 | 0x0000 | 0x0000 | 0x0000
 |  |  | pins_mode | 0xF9D5 | 0xF9D5 | 0xF9D5 | 0xF9D5 | 0xF9D5 | 0xF9D5 | 0xF9D5 | 0xF9D5 | 0xF9D5 | 0xF9D5 | 0xF9D5 | pins_mode |  |  |  |  |  |  |  |  |  |  | pins_pull_up |  |  |  |  |  |  |  |  |  |  | #pins_int |  |  |  |  |  |  |  |  |  |  | #pins_def_val
device |  |  | pins_pull_up | 0x1955 | 0x1955 | 0x1955 | 0x1955 | 0x1955 | 0x1955 | 0x1955 | 0x1955 | 0x1955 | 0x1955 | 0x1955
# nazwa układu | MCP23017 | I2C_Expander_PWR_CLK | #pins_int | 0x0000 | 0x0000 | 0x0000 | 0x0000 | 0x0000 | 0x0000 | 0x0000 | 0x0000 | 0x0000 | 0x0000 | 0x0000
czas pomiędzy wartość safe a krok 1 [ms] | 500 |  | #pins_def_val | 0x0000 | 0x0000 | 0x0000 | 0x0000 | 0x0000 | 0x0000 | 0x0000 | 0x0000 | 0x0000 | 0x0000 | 0x0000
Czas pomiędzy etap 1, a etap 2 | 10
Czas pomiędzy etap 2, a etap 3 | 0
addr | 0x20
#I2C_Expander_PWR_CLK:wartość safe
device | MCP23017 |  |  |  | 5 | 11 | $E$11
i2c_addr | 0x20 |  |  |  |  |  | $E$1
i2c_num | /dev/i2c-1
pins_mode | 0xF9D5 |  |  |  |  | $Q$24 | $Q$23
pins_state | 0x062A |  |  |  |  | $D$23 | $E$23
time | 500
#I2C_Expander_PWR_CLK:etap 1
device | MCP23017 |  |  |  | 6 | 11 | $F$11
i2c_addr | 0x20 |  |  |  |  |  | $F$1
i2c_num | /dev/i2c-1
pins_mode | 0xF9D5 |  |  |  |  | d24 | $F$24
pins_state | 0x062A |  |  |  |  | d23 | $F$23
pins_pull_up | 0x1955 |  |  |  |  | d25 | $F$25
#pins_int | 0x0000 |  |  |  |  | d26 | $F$26
#pins_def_val | 0x0000 |  |  |  |  | d27 | $F$27
time | 10
#I2C_Expander_PWR_CLK:etap 2
device | MCP23017 |  |  |  | 7 | 11 | $G$11
i2c_addr | 0x20 |  |  |  |  |  | $G$1
i2c_num | /dev/i2c-1
pins_mode | 0xF9D5 |  |  |  |  | d24 | $G$24
pins_state | 0x062A |  |  |  |  | d23 | $G$23
pins_pull_up | 0x1955 |  |  |  |  | d25 | $G$25
#pins_int | 0x0000 |  |  |  |  | d26 | $G$26
#pins_def_val | 0x0000 |  |  |  |  | d27 | $G$27
#pins_int | 10
#I2C_Expander_PWR_CLK:etap 3- poweroff WR
device | MCP23017 |  |  |  | 8 | 11 | $H$11
i2c_addr | 0x20 |  |  |  |  |  | $H$1
i2c_num | /dev/i2c-1
pins_mode | 0xF9D5 |  |  |  |  | d24 | $H$24
pins_state | 0x002A |  |  |  |  | d23 | $H$23
pins_pull_up | 0x1955 |  |  |  |  | d25 | $H$25
#pins_int | 0x0000 |  |  |  |  | d26 | $H$26
#pins_def_val | 0x0000 |  |  |  |  | d27 | $H$27
#pins_int | 10
#I2C_Expander_PWR_CLK:power of all clk
device | MCP23017 |  |  |  | 9 | 11 | $I$11
i2c_addr | 0x20 |  |  |  |  |  | $I$1
i2c_num | /dev/i2c-1
pins_mode | 0xF9D5 |  |  |  |  | d24 | $I$24
pins_state | 0x0000 |  |  |  |  | d23 | $I$23
pins_pull_up | 0x1955 |  |  |  |  | d25 | $I$25
#pins_int | 0x0000 |  |  |  |  | d26 | $I$26
#pins_def_val | 0x0000 |  |  |  |  | d27 | $I$27
#pins_int | 10
#I2C_Expander_PWR_CLK:etap 5
device | MCP23017 |  |  |  | 10 | 11 | $J$11
i2c_addr | 0x20 |  |  |  |  |  | $J$1
i2c_num | /dev/i2c-1
pins_mode | 0xF9D5 |  |  |  |  | d24 | $J$24
pins_state | 0x0000 |  |  |  |  | d23 | $J$23
pins_pull_up | 0x1955 |  |  |  |  | d25 | $J$25
#pins_int | 0x0000 |  |  |  |  | d26 | $J$26
#pins_def_val | 0x0000 |  |  |  |  | d27 | $J$27
#pins_int | 10
#I2C_Expander_PWR_CLK:etap 6
device | MCP23017 |  |  |  | 11 | 11 | $K$11
i2c_addr | 0x20 |  |  |  |  |  | $K$1
i2c_num | /dev/i2c-1
pins_mode | 0xF9D5 |  |  |  |  | d24 | $K$24
pins_state | 0x0000 |  |  |  |  | d23 | $K$23
pins_pull_up | 0x1955 |  |  |  |  | d25 | $K$25
#pins_int | 0x0000 |  |  |  |  | d26 | $K$26
#pins_def_val | 0x0000 |  |  |  |  | d27 | $K$27
#pins_int | 10
#I2C_Expander_PWR_CLK:etap 7
device | MCP23017 |  |  |  | 12 | 11 | $L$11
i2c_addr | 0x20 |  |  |  |  |  | $L$1
i2c_num | /dev/i2c-1
pins_mode | 0xF9D5 |  |  |  |  | d24 | $L$24
pins_state | 0x0000 |  |  |  |  | d23 | $L$23
pins_pull_up | 0x1955 |  |  |  |  | d25 | $L$25
#pins_int | 0x0000 |  |  |  |  | d26 | $L$26
#pins_def_val | 0x0000 |  |  |  |  | d27 | $L$27
#pins_int | 10
#I2C_Expander_PWR_CLK:etap 8
device | MCP23017 |  |  |  | 13 | 11 | $M$11
i2c_addr | 0x20 |  |  |  |  |  | $M$1
i2c_num | /dev/i2c-1
pins_mode | 0xF9D5 |  |  |  |  | d24 | $M$24
pins_state | 0x0000 |  |  |  |  | d23 | $M$23
pins_pull_up | 0x1955 |  |  |  |  | d25 | $M$25
#pins_int | 0x0000 |  |  |  |  | d26 | $M$26
#pins_def_val | 0x0000 |  |  |  |  | d27 | $M$27
#pins_int | 10
#I2C_Expander_PWR_CLK:etap 9
device | MCP23017 |  |  |  | 14 | 11 | $N$11
i2c_addr | 0x20 |  |  |  |  |  | $N$1
i2c_num | /dev/i2c-1
pins_mode | 0xF9D5 |  |  |  |  | d24 | $N$24
pins_state | 0x0000 |  |  |  |  | d23 | $N$23
pins_pull_up | 0x1955 |  |  |  |  | d25 | $N$25
#pins_int | 0x0000 |  |  |  |  | d26 | $N$26
#pins_def_val | 0x0000 |  |  |  |  | d27 | $N$27
#pins_int | 10
#I2C_Expander_PWR_CLK:etap 10
device | MCP23017 |  |  |  | 15 | 11 | $O$11
i2c_addr | 0x20 |  |  |  |  |  | $O$1
i2c_num | /dev/i2c-1
pins_mode | 0xF9D5 |  |  |  |  | d24 | $O$24
pins_state | 0x0000 |  |  |  |  | d23 | $O$23
pins_pull_up | 0x1955 |  |  |  |  | d25 | $O$25
#pins_int | 0x0000 |  |  |  |  | d26 | $O$26
#pins_def_val | 0x0000 |  |  |  |  | d27 | $O$27
#pins_int | 10

Sheet: I2C_Expander_PWR_Distr
 |  | opis pinu na schemacie | komentarz | wartość safe | etap 1 | etap 2 | etap 3 | etap 4 | etap 5 | etap 6 | etap 7 | etap 8 | etap 9 | etap 10 | pins_mode 0 - out | pins_mode etap1 | pins_mode etap2 | pins_mode etap3 | pins_mode etap4 | pins_mode etap5 | pins_mode etap6 | pins_mode etap7 | pins_mode etap8 | pins_mode etap9 | pins_mode etap10 | pins_pull_up 1 - enable | pins_pull_up etap 1 | pins_pull_up etap 2 | pins_pull_up etap 3 | pins_pull_up etap 4 | pins_pull_up etap 5 | pins_pull_up etap 6 | pins_pull_up etap 7 | pins_pull_up etap 8 | pins_pull_up etap 9 | pins_pull_up etap 10 | pin_int safe 1 - enable | pin_int etap 1 | pin_int etap 2 | pin_int etap 3 | pin_int etap 4 | pin_int etap 5 | pin_int etap 6 | pin_int etap 7 | pin_int etap 8 | pin_int etap 9 | pin_int etap 10 | Pin_def_state
 | GPA0 | PWR_PowerAlert0 | Przekroczenie prądu na wejściu 1 | 0 | 0 | 0 | 0 | 0 | 0 | 0 | 0 | 0 | 0 | 0 | 1 | 1 | 1 | 1 | 1 | 1 | 1 | 1 | 1 | 1 | 1 | 1 | 1 | 1 | 1 | 1 | 1 | 1 | 1 | 1 | 1 | 1 | 0 | 0 | 0 | 0 | 0 | 0 | 0 | 0 | 0 | 0 | 0 | 0 | 0 | 0 | 0 | 0 | 0 | 0 | 0
 | GPA1 | PWR_PowerAlert1 | Przekroczenie prądu na wejściu 2 | 0 | 0 | 0 | 0 | 0 | 0 | 0 | 0 | 0 | 0 | 0 | 1 | 1 | 1 | 1 | 1 | 1 | 1 | 1 | 1 | 1 | 1 | 1 | 1 | 1 | 1 | 1 | 1 | 1 | 1 | 1 | 1 | 1 | 0 | 0 | 0 | 0 | 0 | 0 | 0 | 0 | 0 | 0 | 0 | 0 | 0 | 0 | 0 | 0 | 0 | 0 | 0
 | GPA2 | nc | niepodłączone | 1 | 0 | 0 | 0 | 0 | 0 | 0 | 0 | 0 | 0 | 0 | 1 | 1 | 1 | 1 | 1 | 1 | 1 | 1 | 1 | 1 | 1 | 1 | 1 | 1 | 1 | 1 | 1 | 1 | 1 | 1 | 1 | 1 | 0 | 0 | 0 | 0 | 0 | 0 | 0 | 0 | 0 | 0 | 0 | 0 | 0 | 0 | 0 | 0 | 0 | 0 | 0
 | GPA3 | nc | niepodłączone | 0 | 0 | 0 | 0 | 0 | 0 | 0 | 0 | 0 | 0 | 0 | 1 | 1 | 1 | 1 | 1 | 1 | 1 | 1 | 1 | 1 | 1 | 1 | 1 | 1 | 1 | 1 | 1 | 1 | 1 | 1 | 1 | 1 | 0 | 0 | 0 | 0 | 0 | 0 | 0 | 0 | 0 | 0 | 0 | 0 | 0 | 0 | 0 | 0 | 0 | 0 | 0
 | GPA4 | nc | niepodłączone | 0 | 0 | 0 | 0 | 0 | 0 | 0 | 0 | 0 | 0 | 0 | 1 | 1 | 1 | 1 | 1 | 1 | 1 | 1 | 1 | 1 | 1 | 1 | 1 | 1 | 1 | 1 | 1 | 1 | 1 | 1 | 1 | 1 | 0 | 0 | 0 | 0 | 0 | 0 | 0 | 0 | 0 | 0 | 0 | 0 | 0 | 0 | 0 | 0 | 0 | 0 | 0
 | GPA5 | Power_Status.S0 | Status przełącznika źródeł nr 0 | 0 | 0 | 0 | 0 | 0 | 0 | 0 | 0 | 0 | 0 | 0 | 1 | 1 | 1 | 1 | 1 | 1 | 1 | 1 | 1 | 1 | 1 | 1 | 1 | 1 | 1 | 1 | 1 | 1 | 1 | 1 | 1 | 1 | 0 | 0 | 0 | 0 | 0 | 0 | 0 | 0 | 0 | 0 | 0 | 0 | 0 | 0 | 0 | 0 | 0 | 0 | 0
 | GPA6 | Power_Status.S1 | Status przełącznika źródeł nr 1 | 0 | 0 | 0 | 0 | 0 | 0 | 0 | 0 | 0 | 0 | 0 | 1 | 1 | 1 | 1 | 1 | 1 | 1 | 1 | 1 | 1 | 1 | 1 | 1 | 1 | 1 | 1 | 1 | 1 | 1 | 1 | 1 | 1 | 0 | 0 | 0 | 0 | 0 | 0 | 0 | 0 | 0 | 0 | 0 | 0 | 0 | 0 | 0 | 0 | 0 | 0 | 0
 | GPA7 | Power_Status.S2 | Status przełącznika źródeł nr 2 | 0 | 0 | 0 | 0 | 0 | 0 | 0 | 0 | 0 | 0 | 0 | 1 | 1 | 1 | 1 | 1 | 1 | 1 | 1 | 1 | 1 | 1 | 1 | 1 | 1 | 1 | 1 | 1 | 1 | 1 | 1 | 1 | 1 | 0 | 0 | 0 | 0 | 0 | 0 | 0 | 0 | 0 | 0 | 0 | 0 | 0 | 0 | 0 | 0 | 0 | 0 | 0
 |  |  |  | 00000100 | 00000000 | 00000000 | 00000000 | 00000000 | 00000000 | 00000000 | 00000000 | 00000000 | 00000000 | 00000000 | 11111111 | 11111111 | 11111111 | 11111111 | 11111111 | 11111111 | 11111111 | 11111111 | 11111111 | 11111111 | 11111111 | 11111111 | 11111111 | 11111111 | 11111111 | 11111111 | 11111111 | 11111111 | 11111111 | 11111111 | 11111111 | 11111111 | 00000000 | 00000000 | 00000000 | 00000000 | 00000000 | 00000000 | 00000000 | 00000000 | 00000000 | 00000000 | 00000000 | 00000000 | 00000000 | 00000000 | 00000000 | 00000000 | 00000000 | 00000000 | 00000000
 |  |  |  | 04 | 00 | 00 | 00 | 00 | 00 | 00 | 00 | 00 | 00 | 00 | FF | FF | FF | FF | FF | FF | FF | FF | FF | FF | FF | FF | FF | FF | FF | FF | FF | FF | FF | FF | FF | FF | 00 | 00 | 00 | 00 | 00 | 00 | 00 | 00 | 00 | 00 | 00 | 00 | 00 | 00 | 00 | 00 | 00 | 00 | 00
 | GPB0 | PG_3V3_14A_EXP | Sygnał potwierdzający poprawne zasilanie 3.3V 14A | 0 | 0 | 0 | 0 | 0 | 0 | 0 | 0 | 0 | 0 | 0 | 1 | 1 | 1 | 1 | 1 | 1 | 1 | 1 | 1 | 1 | 1 | 1 | 1 | 1 | 1 | 1 | 1 | 1 | 1 | 1 | 1 | 1 | 0 | 0 | 0 | 0 | 0 | 0 | 0 | 0 | 0 | 0 | 0 | 0 | 0 | 0 | 0 | 0 | 0 | 0 | 0
 | GPB1 | PG_5V_10A_EXP | Sygnał potwierdzający poprawne zasilanie 5V 10A | 0 | 0 | 0 | 0 | 0 | 0 | 0 | 0 | 0 | 0 | 0 | 1 | 1 | 1 | 1 | 1 | 1 | 1 | 1 | 1 | 1 | 1 | 1 | 1 | 1 | 1 | 1 | 1 | 1 | 1 | 1 | 1 | 1 | 0 | 0 | 0 | 0 | 0 | 0 | 0 | 0 | 0 | 0 | 0 | 0 | 0 | 0 | 0 | 0 | 0 | 0 | 0
 | GPB2 | PG_12_8A_EXP | Sygnał potwierdzający poprawne zasilanie 12V 8A | 0 | 0 | 0 | 0 | 0 | 0 | 0 | 0 | 0 | 0 | 0 | 1 | 1 | 1 | 1 | 1 | 1 | 1 | 1 | 1 | 1 | 1 | 1 | 1 | 1 | 1 | 1 | 1 | 1 | 1 | 1 | 1 | 1 | 0 | 0 | 0 | 0 | 0 | 0 | 0 | 0 | 0 | 0 | 0 | 0 | 0 | 0 | 0 | 0 | 0 | 0 | 0
 | GPB3 | En_Switch1 | aktywacja przekaźnika 1 do ładowania baterii | 0 | 0 | 0 | 0 | 0 | 0 | 0 | 0 | 0 | 0 | 0 | 0 | 0 | 0 | 0 | 0 | 0 | 0 | 0 | 0 | 0 | 0 | 0 | 0 | 0 | 0 | 0 | 0 | 0 | 0 | 0 | 0 | 0 | 0 | 0 | 0 | 0 | 0 | 0 | 0 | 0 | 0 | 0 | 0 | 0 | 0 | 0 | 0 | 0 | 0 | 0 | 0
 | GPB4 | Switch1_Flag | Potwierdzenie poprawnej pracy przekażnika 1 | 0 | 0 | 0 | 0 | 0 | 0 | 0 | 0 | 0 | 0 | 0 | 1 | 1 | 1 | 1 | 1 | 1 | 1 | 1 | 1 | 1 | 1 | 1 | 1 | 1 | 1 | 1 | 1 | 1 | 1 | 1 | 1 | 1 | 0 | 0 | 0 | 0 | 0 | 0 | 0 | 0 | 0 | 0 | 0 | 0 | 0 | 0 | 0 | 0 | 0 | 0 | 0
 | GPB5 | En_Switch2 | aktywacja przekaźnika 2 do ładowania baterii | 0 | 0 | 0 | 0 | 0 | 0 | 0 | 0 | 0 | 0 | 0 | 0 | 0 | 0 | 0 | 0 | 0 | 0 | 0 | 0 | 0 | 0 | 0 | 0 | 0 | 0 | 0 | 0 | 0 | 0 | 0 | 0 | 0 | 0 | 0 | 0 | 0 | 0 | 0 | 0 | 0 | 0 | 0 | 0 | 0 | 0 | 0 | 0 | 0 | 0 | 0 | 0
 | GPB6 | Switch2_Flag | Potwierdzenie poprawnej pracy przekażnika 2 | 0 | 0 | 0 | 0 | 0 | 0 | 0 | 0 | 0 | 0 | 0 | 1 | 1 | 1 | 1 | 1 | 1 | 1 | 1 | 1 | 1 | 1 | 1 | 1 | 1 | 1 | 1 | 1 | 1 | 1 | 1 | 1 | 1 | 0 | 0 | 0 | 0 | 0 | 0 | 0 | 0 | 0 | 0 | 0 | 0 | 0 | 0 | 0 | 0 | 0 | 0 | 0
 | GPB7 | PG_48_20V | Informacja o poprawnym zasilaniu 20V pochodzacym od POE | 0 | 0 | 0 | 0 | 0 | 0 | 0 | 0 | 0 | 0 | 0 | 1 | 1 | 1 | 1 | 1 | 1 | 1 | 1 | 1 | 1 | 1 | 1 | 1 | 1 | 1 | 1 | 1 | 1 | 1 | 1 | 1 | 1 | 0 | 0 | 0 | 0 | 0 | 0 | 0 | 0 | 0 | 0 | 0 | 0 | 0 | 0 | 0 | 0 | 0 | 0 | 0
 | GPB |  |  | 00000000 | 00000000 | 00000000 | 00000000 | 00000000 | 00000000 | 00000000 | 00000000 | 00000000 | 00000000 | 00000000 | 11010111 | 11010111 | 11010111 | 11010111 | 11010111 | 11010111 | 11010111 | 11010111 | 11010111 | 11010111 | 11010111 | 11010111 | 11010111 | 11010111 | 11010111 | 11010111 | 11010111 | 11010111 | 11010111 | 11010111 | 11010111 | 11010111 | 00000000 | 00000000 | 00000000 | 00000000 | 00000000 | 00000000 | 00000000 | 00000000 | 00000000 | 00000000 | 00000000 | 00000000 | 00000000 | 00000000 | 00000000 | 00000000 | 00000000 | 00000000 | 00000000
 |  |  |  | 00 | 00 | 00 | 00 | 00 | 00 | 00 | 00 | 00 | 00 | 00 | D7 | D7 | D7 | D7 | D7 | D7 | D7 | D7 | D7 | D7 | D7 | D7 | D7 | D7 | D7 | D7 | D7 | D7 | D7 | D7 | D7 | D7 | 00 | 00 | 00 | 00 | 00 | 00 | 00 | 00 | 00 | 00 | 00 | 00 | 00 | 00 | 00 | 00 | 00 | 00 | 00
 |  |  | pins_state | 0x0004 | 0x0000 | 0x0000 | 0x0000 | 0x0000 | 0x0000 | 0x0000 | 0x0000 | 0x0000 | 0x0000 | 0x0000 | 0xD7FF | 0xD7FF | 0xD7FF | 0xD7FF | 0xD7FF | 0xD7FF | 0xD7FF | 0xD7FF | 0xD7FF | 0xD7FF | 0xD7FF | 0xD7FF | 0xD7FF | 0xD7FF | 0xD7FF | 0xD7FF | 0xD7FF | 0xD7FF | 0xD7FF | 0xD7FF | 0xD7FF | 0xD7FF | 0x0000 | 0x0000 | 0x0000 | 0x0000 | 0x0000 | 0x0000 | 0x0000 | 0x0000 | 0x0000 | 0x0000 | 0x0000 | 0x0000 | 0x0000 | 0x0000 | 0x0000 | 0x0000 | 0x0000 | 0x0000 | 0x0000
 |  |  | pins_mode | 0xD7FF | 0xD7FF | 0xD7FF | 0xD7FF | 0xD7FF | 0xD7FF | 0xD7FF | 0xD7FF | 0xD7FF | 0xD7FF | 0xD7FF | pins_mode |  |  |  |  |  |  |  |  |  |  | pins_pull_up |  |  |  |  |  |  |  |  |  |  | #pins_int |  |  |  |  |  |  |  |  |  |  | #pins_def_val
device |  |  | pins_pull_up | 0xD7FF | 0xD7FF | 0xD7FF | 0xD7FF | 0xD7FF | 0xD7FF | 0xD7FF | 0xD7FF | 0xD7FF | 0xD7FF | 0xD7FF
# nazwa układu | MCP23017 | I2C_Expander_PWR_Distr | #pins_int | 0x0000 | 0x0000 | 0x0000 | 0x0000 | 0x0000 | 0x0000 | 0x0000 | 0x0000 | 0x0000 | 0x0000 | 0x0000
czas pomiędzy wartość safe a krok 1 [ms] | 500 |  | #pins_def_val | 0x0000 | 0x0000 | 0x0000 | 0x0000 | 0x0000 | 0x0000 | 0x0000 | 0x0000 | 0x0000 | 0x0000 | 0x0000
Czas pomiędzy etap 1, a etap 2 | 10
Czas pomiędzy etap 2, a etap 3 | 0
addr | 0x21
#I2C_Expander_PWR_Distr:wartość safe
device | MCP23017 |  |  |  | 5 | 11 | $E$11
i2c_addr | 0x21 |  |  |  |  |  | $E$1
i2c_num | /dev/i2c-1
pins_mode | 0xD7FF |  |  |  |  | $Q$24 | $Q$23
pins_state | 0x0004 |  |  |  |  | $D$23 | $E$23
time | 500
#I2C_Expander_PWR_Distr:etap 1
device | MCP23017 |  |  |  | 6 | 11 | $F$11
i2c_addr | 0x21 |  |  |  |  |  | $F$1
i2c_num | /dev/i2c-1
pins_mode | 0xD7FF |  |  |  |  | d24 | $F$24
pins_state | 0x0000 |  |  |  |  | d23 | $F$23
pins_pull_up | 0xD7FF |  |  |  |  | d25 | $F$25
#pins_int | 0x0000 |  |  |  |  | d26 | $F$26
#pins_def_val | 0x0000 |  |  |  |  | d27 | $F$27
time | 10
#I2C_Expander_PWR_Distr:etap 2
device | MCP23017 |  |  |  | 7 | 11 | $G$11
i2c_addr | 0x21 |  |  |  |  |  | $G$1
i2c_num | /dev/i2c-1
pins_mode | 0xD7FF |  |  |  |  | d24 | $G$24
pins_state | 0x0000 |  |  |  |  | d23 | $G$23
pins_pull_up | 0xD7FF |  |  |  |  | d25 | $G$25
#pins_int | 0x0000 |  |  |  |  | d26 | $G$26
#pins_def_val | 0x0000 |  |  |  |  | d27 | $G$27
#pins_int | 10
#I2C_Expander_PWR_Distr:etap 3
device | MCP23017 |  |  |  | 8 | 11 | $H$11
i2c_addr | 0x21 |  |  |  |  |  | $H$1
i2c_num | /dev/i2c-1
pins_mode | 0xD7FF |  |  |  |  | d24 | $H$24
pins_state | 0x0000 |  |  |  |  | d23 | $H$23
pins_pull_up | 0xD7FF |  |  |  |  | d25 | $H$25
#pins_int | 0x0000 |  |  |  |  | d26 | $H$26
#pins_def_val | 0x0000 |  |  |  |  | d27 | $H$27
#pins_int | 10
#I2C_Expander_PWR_Distr:etap 4
device | MCP23017 |  |  |  | 9 | 11 | $I$11
i2c_addr | 0x21 |  |  |  |  |  | $I$1
i2c_num | /dev/i2c-1
pins_mode | 0xD7FF |  |  |  |  | d24 | $I$24
pins_state | 0x0000 |  |  |  |  | d23 | $I$23
pins_pull_up | 0xD7FF |  |  |  |  | d25 | $I$25
#pins_int | 0x0000 |  |  |  |  | d26 | $I$26
#pins_def_val | 0x0000 |  |  |  |  | d27 | $I$27
#pins_int | 10
#I2C_Expander_PWR_Distr:etap 5
device | MCP23017 |  |  |  | 10 | 11 | $J$11
i2c_addr | 0x21 |  |  |  |  |  | $J$1
i2c_num | /dev/i2c-1
pins_mode | 0xD7FF |  |  |  |  | d24 | $J$24
pins_state | 0x0000 |  |  |  |  | d23 | $J$23
pins_pull_up | 0xD7FF |  |  |  |  | d25 | $J$25
#pins_int | 0x0000 |  |  |  |  | d26 | $J$26
#pins_def_val | 0x0000 |  |  |  |  | d27 | $J$27
#pins_int | 10
#I2C_Expander_PWR_Distr:etap 6
device | MCP23017 |  |  |  | 11 | 11 | $K$11
i2c_addr | 0x21 |  |  |  |  |  | $K$1
i2c_num | /dev/i2c-1
pins_mode | 0xD7FF |  |  |  |  | d24 | $K$24
pins_state | 0x0000 |  |  |  |  | d23 | $K$23
pins_pull_up | 0xD7FF |  |  |  |  | d25 | $K$25
#pins_int | 0x0000 |  |  |  |  | d26 | $K$26
#pins_def_val | 0x0000 |  |  |  |  | d27 | $K$27
#pins_int | 10
#I2C_Expander_PWR_Distr:etap 7
device | MCP23017 |  |  |  | 12 | 11 | $L$11
i2c_addr | 0x21 |  |  |  |  |  | $L$1
i2c_num | /dev/i2c-1
pins_mode | 0xD7FF |  |  |  |  | d24 | $L$24
pins_state | 0x0000 |  |  |  |  | d23 | $L$23
pins_pull_up | 0xD7FF |  |  |  |  | d25 | $L$25
#pins_int | 0x0000 |  |  |  |  | d26 | $L$26
#pins_def_val | 0x0000 |  |  |  |  | d27 | $L$27
#pins_int | 10
#I2C_Expander_PWR_Distr:etap 8
device | MCP23017 |  |  |  | 13 | 11 | $M$11
i2c_addr | 0x21 |  |  |  |  |  | $M$1
i2c_num | /dev/i2c-1
pins_mode | 0xD7FF |  |  |  |  | d24 | $M$24
pins_state | 0x0000 |  |  |  |  | d23 | $M$23
pins_pull_up | 0xD7FF |  |  |  |  | d25 | $M$25
#pins_int | 0x0000 |  |  |  |  | d26 | $M$26
#pins_def_val | 0x0000 |  |  |  |  | d27 | $M$27
#pins_int | 10
#I2C_Expander_PWR_Distr:etap 9
device | MCP23017 |  |  |  | 14 | 11 | $N$11
i2c_addr | 0x21 |  |  |  |  |  | $N$1
i2c_num | /dev/i2c-1
pins_mode | 0xD7FF |  |  |  |  | d24 | $N$24
pins_state | 0x0000 |  |  |  |  | d23 | $N$23
pins_pull_up | 0xD7FF |  |  |  |  | d25 | $N$25
#pins_int | 0x0000 |  |  |  |  | d26 | $N$26
#pins_def_val | 0x0000 |  |  |  |  | d27 | $N$27
#pins_int | 10
#I2C_Expander_PWR_Distr:etap 10
device | MCP23017 |  |  |  | 15 | 11 | $O$11
i2c_addr | 0x21 |  |  |  |  |  | $O$1
i2c_num | /dev/i2c-1
pins_mode | 0xD7FF |  |  |  |  | d24 | $O$24
pins_state | 0x0000 |  |  |  |  | d23 | $O$23
pins_pull_up | 0xD7FF |  |  |  |  | d25 | $O$25
#pins_int | 0x0000 |  |  |  |  | d26 | $O$26
#pins_def_val | 0x0000 |  |  |  |  | d27 | $O$27
#pins_int | 10

Sheet: I2C_Expander_SFP
 |  | opis pinu na schemacie | komentarz | wartość safe | etap 1 | etap 2 - SFP tx enable | etap 3 | etap 4 | etap 5 | etap 6 | etap 7 | etap 8 | etap 9 | etap 10 | pins_mode 0 - out | pins_mode etap1 | pins_mode etap2 | pins_mode etap3 | pins_mode etap4 | pins_mode etap5 | pins_mode etap6 | pins_mode etap7 | pins_mode etap8 | pins_mode etap9 | pins_mode etap10 | pins_pull_up 1 - enable | pins_pull_up etap 1 | pins_pull_up etap 2 | pins_pull_up etap 3 | pins_pull_up etap 4 | pins_pull_up etap 5 | pins_pull_up etap 6 | pins_pull_up etap 7 | pins_pull_up etap 8 | pins_pull_up etap 9 | pins_pull_up etap 10 | pin_int safe 1 - enable | pin_int etap 1 | pin_int etap 2 | pin_int etap 3 | pin_int etap 4 | pin_int etap 5 | pin_int etap 6 | pin_int etap 7 | pin_int etap 8 | pin_int etap 9 | pin_int etap 10 | Pin_def_state
 |  | SFP_Digit3.TF_Fault |  | 0 | 0 | 0 | 0 | 0 | 0 | 0 | 0 | 0 | 0 | 0 | 1 | 1 | 1 | 1 | 1 | 1 | 1 | 1 | 1 | 1 | 1 | 1 | 1 | 1 | 1 | 1 | 1 | 1 | 1 | 1 | 1 | 1 | 0 | 0 | 0 | 0 | 0 | 0 | 0 | 0 | 0 | 0 | 0 | 0 | 0 | 0 | 0 | 0 | 0 | 0 | 0
 |  | SFP_Digit3.TX_Disable |  | 0 | 0 | 0 | 0 | 0 | 0 | 0 | 0 | 0 | 0 | 0 | 0 | 0 | 0 | 0 | 0 | 0 | 0 | 0 | 0 | 0 | 0 | 1 | 1 | 1 | 1 | 1 | 1 | 1 | 1 | 1 | 1 | 1 | 0 | 0 | 0 | 0 | 0 | 0 | 0 | 0 | 0 | 0 | 0 | 0 | 0 | 0 | 0 | 0 | 0 | 0 | 0
 |  | SFP_Digit3.LOS |  | 0 | 0 | 0 | 0 | 0 | 0 | 0 | 0 | 0 | 0 | 0 | 1 | 1 | 1 | 1 | 1 | 1 | 1 | 1 | 1 | 1 | 1 | 1 | 1 | 1 | 1 | 1 | 1 | 1 | 1 | 1 | 1 | 1 | 0 | 0 | 0 | 0 | 0 | 0 | 0 | 0 | 0 | 0 | 0 | 0 | 0 | 0 | 0 | 0 | 0 | 0 | 0
 |  | nc |  | 0 | 0 | 0 | 0 | 0 | 0 | 0 | 0 | 0 | 0 | 0 | 1 | 1 | 1 | 1 | 1 | 1 | 1 | 1 | 1 | 1 | 1 | 0 | 0 | 0 | 0 | 0 | 0 | 0 | 0 | 0 | 0 | 0 | 0 | 0 | 0 | 0 | 0 | 0 | 0 | 0 | 0 | 0 | 0 | 0 | 0 | 0 | 0 | 0 | 0 | 0 | 0
 |  | nc |  | 0 | 0 | 0 | 0 | 0 | 0 | 0 | 0 | 0 | 0 | 0 | 1 | 1 | 1 | 1 | 1 | 1 | 1 | 1 | 1 | 1 | 1 | 0 | 0 | 0 | 0 | 0 | 0 | 0 | 0 | 0 | 0 | 0 | 0 | 0 | 0 | 0 | 0 | 0 | 0 | 0 | 0 | 0 | 0 | 0 | 0 | 0 | 0 | 0 | 0 | 0 | 0
 |  | SFP_Digit1.TF_Fault |  | 0 | 0 | 0 | 0 | 0 | 0 | 0 | 0 | 0 | 0 | 0 | 1 | 1 | 1 | 1 | 1 | 1 | 1 | 1 | 1 | 1 | 1 | 1 | 1 | 1 | 1 | 1 | 1 | 1 | 1 | 1 | 1 | 1 | 0 | 0 | 0 | 0 | 0 | 0 | 0 | 0 | 0 | 0 | 0 | 0 | 0 | 0 | 0 | 0 | 0 | 0 | 0
 |  | SFP_Digit1.TX_Disable |  | 0 | 0 | 0 | 0 | 0 | 0 | 0 | 0 | 0 | 0 | 0 | 0 | 0 | 0 | 0 | 0 | 0 | 0 | 0 | 0 | 0 | 0 | 1 | 1 | 1 | 1 | 1 | 1 | 1 | 1 | 1 | 1 | 1 | 0 | 0 | 0 | 0 | 0 | 0 | 0 | 0 | 0 | 0 | 0 | 0 | 0 | 0 | 0 | 0 | 0 | 0 | 0
 |  | SFP_Digit1.LOS |  | 0 | 0 | 0 | 0 | 0 | 0 | 0 | 0 | 0 | 0 | 0 | 1 | 1 | 1 | 1 | 1 | 1 | 1 | 1 | 1 | 1 | 1 | 1 | 1 | 1 | 1 | 1 | 1 | 1 | 1 | 1 | 1 | 1 | 0 | 0 | 0 | 0 | 0 | 0 | 0 | 0 | 0 | 0 | 0 | 0 | 0 | 0 | 0 | 0 | 0 | 0 | 0
 |  |  |  | 00000000 | 00000000 | 00000000 | 00000000 | 00000000 | 00000000 | 00000000 | 00000000 | 00000000 | 00000000 | 00000000 | 10111101 | 10111101 | 10111101 | 10111101 | 10111101 | 10111101 | 10111101 | 10111101 | 10111101 | 10111101 | 10111101 | 11100111 | 11100111 | 11100111 | 11100111 | 11100111 | 11100111 | 11100111 | 11100111 | 11100111 | 11100111 | 11100111 | 00000000 | 00000000 | 00000000 | 00000000 | 00000000 | 00000000 | 00000000 | 00000000 | 00000000 | 00000000 | 00000000 | 00000000 | 00000000 | 00000000 | 00000000 | 00000000 | 00000000 | 00000000 | 00000000
 |  |  |  | 00 | 00 | 00 | 00 | 00 | 00 | 00 | 00 | 00 | 00 | 00 | BD | BD | BD | BD | BD | BD | BD | BD | BD | BD | BD | E7 | E7 | E7 | E7 | E7 | E7 | E7 | E7 | E7 | E7 | E7 | 00 | 00 | 00 | 00 | 00 | 00 | 00 | 00 | 00 | 00 | 00 | 00 | 00 | 00 | 00 | 00 | 00 | 00 | 00
 |  | SFP_Digit2.TF_Fault |  | 0 | 0 | 0 | 0 | 0 | 0 | 0 | 0 | 0 | 0 | 0 | 1 | 1 | 1 | 1 | 1 | 1 | 1 | 1 | 1 | 1 | 1 | 1 | 1 | 1 | 1 | 1 | 1 | 1 | 1 | 1 | 1 | 1 | 0 | 0 | 0 | 0 | 0 | 0 | 0 | 0 | 0 | 0 | 0 | 0 | 0 | 0 | 0 | 0 | 0 | 0 | 0
 |  | SFP_Digit2.TX_Disable |  | 0 | 0 | 0 | 0 | 0 | 0 | 0 | 0 | 0 | 0 | 0 | 0 | 0 | 0 | 0 | 0 | 0 | 0 | 0 | 0 | 0 | 0 | 1 | 1 | 1 | 1 | 1 | 1 | 1 | 1 | 1 | 1 | 1 | 0 | 0 | 0 | 0 | 0 | 0 | 0 | 0 | 0 | 0 | 0 | 0 | 0 | 0 | 0 | 0 | 0 | 0 | 0
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
#pins_def_val | 0x0000 |  |  |  |  | d27 | $F$27
time | 10
#I2C_Expander_SFP:etap 2 - SFP tx enable
device | MCP23017 |  |  |  | 7 | 11 | $G$11
i2c_addr | 0x26 |  |  |  |  |  | $G$1
i2c_num | /dev/i2c-1
pins_mode | 0xBDBD |  |  |  |  | d24 | $G$24
pins_state | 0x0000 |  |  |  |  | d23 | $G$23
pins_pull_up | 0xE7E7 |  |  |  |  | d25 | $G$25
#pins_int | 0x0000 |  |  |  |  | d26 | $G$26
#pins_def_val | 0x0000 |  |  |  |  | d27 | $G$27
#pins_int | 10
#I2C_Expander_SFP:etap 3
device | MCP23017 |  |  |  | 8 | 11 | $H$11
i2c_addr | 0x26 |  |  |  |  |  | $H$1
i2c_num | /dev/i2c-1
pins_mode | 0xBDBD |  |  |  |  | d24 | $H$24
pins_state | 0x0000 |  |  |  |  | d23 | $H$23
pins_pull_up | 0xE7E7 |  |  |  |  | d25 | $H$25
#pins_int | 0x0000 |  |  |  |  | d26 | $H$26
#pins_def_val | 0x0000 |  |  |  |  | d27 | $H$27
#pins_int | 10
#I2C_Expander_SFP:etap 4
device | MCP23017 |  |  |  | 9 | 11 | $I$11
i2c_addr | 0x26 |  |  |  |  |  | $I$1
i2c_num | /dev/i2c-1
pins_mode | 0xBDBD |  |  |  |  | d24 | $I$24
pins_state | 0x0000 |  |  |  |  | d23 | $I$23
pins_pull_up | 0xE7E7 |  |  |  |  | d25 | $I$25
#pins_int | 0x0000 |  |  |  |  | d26 | $I$26
#pins_def_val | 0x0000 |  |  |  |  | d27 | $I$27
#pins_int | 10
#I2C_Expander_SFP:etap 5
device | MCP23017 |  |  |  | 10 | 11 | $J$11
i2c_addr | 0x26 |  |  |  |  |  | $J$1
i2c_num | /dev/i2c-1
pins_mode | 0xBDBD |  |  |  |  | d24 | $J$24
pins_state | 0x0000 |  |  |  |  | d23 | $J$23
pins_pull_up | 0xE7E7 |  |  |  |  | d25 | $J$25
#pins_int | 0x0000 |  |  |  |  | d26 | $J$26
#pins_def_val | 0x0000 |  |  |  |  | d27 | $J$27
#pins_int | 10
#I2C_Expander_SFP:etap 6
device | MCP23017 |  |  |  | 11 | 11 | $K$11
i2c_addr | 0x26 |  |  |  |  |  | $K$1
i2c_num | /dev/i2c-1
pins_mode | 0xBDBD |  |  |  |  | d24 | $K$24
pins_state | 0x0000 |  |  |  |  | d23 | $K$23
pins_pull_up | 0xE7E7 |  |  |  |  | d25 | $K$25
#pins_int | 0x0000 |  |  |  |  | d26 | $K$26
#pins_def_val | 0x0000 |  |  |  |  | d27 | $K$27
#pins_int | 10
#I2C_Expander_SFP:etap 7
device | MCP23017 |  |  |  | 12 | 11 | $L$11
i2c_addr | 0x26 |  |  |  |  |  | $L$1
i2c_num | /dev/i2c-1
pins_mode | 0xBDBD |  |  |  |  | d24 | $L$24
pins_state | 0x0000 |  |  |  |  | d23 | $L$23
pins_pull_up | 0xE7E7 |  |  |  |  | d25 | $L$25
#pins_int | 0x0000 |  |  |  |  | d26 | $L$26
#pins_def_val | 0x0000 |  |  |  |  | d27 | $L$27
#pins_int | 10
#I2C_Expander_SFP:etap 8
device | MCP23017 |  |  |  | 13 | 11 | $M$11
i2c_addr | 0x26 |  |  |  |  |  | $M$1
i2c_num | /dev/i2c-1
pins_mode | 0xBDBD |  |  |  |  | d24 | $M$24
pins_state | 0x0000 |  |  |  |  | d23 | $M$23
pins_pull_up | 0xE7E7 |  |  |  |  | d25 | $M$25
#pins_int | 0x0000 |  |  |  |  | d26 | $M$26
#pins_def_val | 0x0000 |  |  |  |  | d27 | $M$27
#pins_int | 10
#I2C_Expander_SFP:etap 9
device | MCP23017 |  |  |  | 14 | 11 | $N$11
i2c_addr | 0x26 |  |  |  |  |  | $N$1
i2c_num | /dev/i2c-1
pins_mode | 0xBDBD |  |  |  |  | d24 | $N$24
pins_state | 0x0000 |  |  |  |  | d23 | $N$23
pins_pull_up | 0xE7E7 |  |  |  |  | d25 | $N$25
#pins_int | 0x0000 |  |  |  |  | d26 | $N$26
#pins_def_val | 0x0000 |  |  |  |  | d27 | $N$27
#pins_int | 10
#I2C_Expander_SFP:etap 10
device | MCP23017 |  |  |  | 15 | 11 | $O$11
i2c_addr | 0x26 |  |  |  |  |  | $O$1
i2c_num | /dev/i2c-1
pins_mode | 0xBDBD |  |  |  |  | d24 | $O$24
pins_state | 0x0000 |  |  |  |  | d23 | $O$23
pins_pull_up | 0xE7E7 |  |  |  |  | d25 | $O$25
#pins_int | 0x0000 |  |  |  |  | d26 | $O$26
#pins_def_val | 0x0000 |  |  |  |  | d27 | $O$27
#pins_int | 10
 |  |  |  |  |  |  |  |  |  |  |  |  |  |  | v

Sheet: I2C_Expander_00
 |  | opis pinu na schemacie | komentarz | wartość safe | etap 1 | etap 2 | etap 3 | etap 4 | etap 5 | etap 6 | etap 7 | etap 8 | etap 9 | etap 10 | pins_mode 0 - out | pins_mode etap1 | pins_mode etap2 | pins_mode etap3 | pins_mode etap4 | pins_mode etap5 | pins_mode etap6 | pins_mode etap7 | pins_mode etap8 | pins_mode etap9 | pins_mode etap10 | pins_pull_up 1 - enable | pins_pull_up etap 1 | pins_pull_up etap 2 | pins_pull_up etap 3 | pins_pull_up etap 4 | pins_pull_up etap 5 | pins_pull_up etap 6 | pins_pull_up etap 7 | pins_pull_up etap 8 | pins_pull_up etap 9 | pins_pull_up etap 10 | pin_int safe 1 - enable | pin_int etap 1 | pin_int etap 2 | pin_int etap 3 | pin_int etap 4 | pin_int etap 5 | pin_int etap 6 | pin_int etap 7 | pin_int etap 8 | pin_int etap 9 | pin_int etap 10 | Pin_def_state
 |  | nc |  | 0 | 0 | 0 | 0 | 0 | 0 | 0 | 0 | 0 | 0 | 0 | 1 | 1 | 1 | 1 | 1 | 1 | 1 | 1 | 1 | 1 | 1 | 0 | 0 | 0 | 0 | 0 | 0 | 0 | 0 | 0 | 0 | 0 | 0 | 0 | 0 | 0 | 0 | 0 | 0 | 0 | 0 | 0 | 0 | 0 | 0 | 0 | 0 | 0 | 0 | 0 | 0
 |  | nc |  | 0 | 0 | 0 | 0 | 0 | 0 | 0 | 0 | 0 | 0 | 0 | 1 | 1 | 1 | 1 | 1 | 1 | 1 | 1 | 1 | 1 | 1 | 0 | 0 | 0 | 0 | 0 | 0 | 0 | 0 | 0 | 0 | 0 | 0 | 0 | 0 | 0 | 0 | 0 | 0 | 0 | 0 | 0 | 0 | 0 | 0 | 0 | 0 | 0 | 0 | 0 | 0
 |  | Ctrl_Pwr_4HiSpeed.EN_PWR_PCIE_4 | wlązanie 12V dla karty w złączu PCIE_4 | 0 | 0 | 1 | 1 | 1 | 1 | 1 | 1 | 1 | 1 | 1 | 0 | 0 | 0 | 0 | 0 | 0 | 0 | 0 | 0 | 0 | 0 | 0 | 0 | 0 | 0 | 0 | 0 | 0 | 0 | 0 | 0 | 0 | 0 | 0 | 0 | 0 | 0 | 0 | 0 | 0 | 0 | 0 | 0 | 0 | 0 | 0 | 0 | 0 | 0 | 0 | 0
 |  | nc |  | 0 | 0 | 0 | 0 | 0 | 0 | 0 | 0 | 0 | 0 | 0 | 1 | 1 | 1 | 1 | 1 | 1 | 1 | 1 | 1 | 1 | 1 | 0 | 0 | 0 | 0 | 0 | 0 | 0 | 0 | 0 | 0 | 0 | 0 | 0 | 0 | 0 | 0 | 0 | 0 | 0 | 0 | 0 | 0 | 0 | 0 | 0 | 0 | 0 | 0 | 0 | 0
 |  | nc |  | 0 | 0 | 0 | 0 | 0 | 0 | 0 | 0 | 0 | 0 | 0 | 1 | 1 | 1 | 1 | 1 | 1 | 1 | 1 | 1 | 1 | 1 | 0 | 0 | 0 | 0 | 0 | 0 | 0 | 0 | 0 | 0 | 0 | 0 | 0 | 0 | 0 | 0 | 0 | 0 | 0 | 0 | 0 | 0 | 0 | 0 | 0 | 0 | 0 | 0 | 0 | 0
 |  | PG_1V0_1.5A_ETH | potwierdzenie poprawności zasilania dla serializera Ethernetu | 0 | 0 | 0 | 0 | 0 | 0 | 0 | 0 | 0 | 0 | 0 | 1 | 1 | 1 | 1 | 1 | 1 | 1 | 1 | 1 | 1 | 1 | 1 | 1 | 1 | 1 | 1 | 1 | 1 | 1 | 1 | 1 | 1 | 0 | 0 | 0 | 0 | 0 | 0 | 0 | 0 | 0 | 0 | 0 | 0 | 0 | 0 | 0 | 0 | 0 | 0 | 0
 |  | PG_1V8_1.5A_ETH | potwierdzenie poprawności zasilania dla serializera Ethernetu | 0 | 0 | 0 | 0 | 0 | 0 | 0 | 0 | 0 | 0 | 0 | 1 | 1 | 1 | 1 | 1 | 1 | 1 | 1 | 1 | 1 | 1 | 1 | 1 | 1 | 1 | 1 | 1 | 1 | 1 | 1 | 1 | 1 | 0 | 0 | 0 | 0 | 0 | 0 | 0 | 0 | 0 | 0 | 0 | 0 | 0 | 0 | 0 | 0 | 0 | 0 | 0
 |  | nc |  | 0 | 0 | 0 | 0 | 0 | 0 | 0 | 0 | 0 | 0 | 0 | 1 | 1 | 1 | 1 | 1 | 1 | 1 | 1 | 1 | 1 | 1 | 0 | 0 | 0 | 0 | 0 | 0 | 0 | 0 | 0 | 0 | 0 | 0 | 0 | 0 | 0 | 0 | 0 | 0 | 0 | 0 | 0 | 0 | 0 | 0 | 0 | 0 | 0 | 0 | 0 | 0
 |  |  |  | 00000000 | 00000000 | 00000100 | 00000100 | 00000100 | 00000100 | 00000100 | 00000100 | 00000100 | 00000100 | 00000100 | 11111011 | 11111011 | 11111011 | 11111011 | 11111011 | 11111011 | 11111011 | 11111011 | 11111011 | 11111011 | 11111011 | 01100000 | 01100000 | 01100000 | 01100000 | 01100000 | 01100000 | 01100000 | 01100000 | 01100000 | 01100000 | 01100000 | 00000000 | 00000000 | 00000000 | 00000000 | 00000000 | 00000000 | 00000000 | 00000000 | 00000000 | 00000000 | 00000000 | 00000000 | 00000000 | 00000000 | 00000000 | 00000000 | 00000000 | 00000000 | 00000000
 |  |  |  | 00 | 00 | 04 | 04 | 04 | 04 | 04 | 04 | 04 | 04 | 04 | FB | FB | FB | FB | FB | FB | FB | FB | FB | FB | FB | 60 | 60 | 60 | 60 | 60 | 60 | 60 | 60 | 60 | 60 | 60 | 00 | 00 | 00 | 00 | 00 | 00 | 00 | 00 | 00 | 00 | 00 | 00 | 00 | 00 | 00 | 00 | 00 | 00 | 00
 |  | nc |  | 0 | 0 | 0 | 0 | 0 | 0 | 0 | 0 | 0 | 0 | 0 | 1 | 1 | 1 | 1 | 1 | 1 | 1 | 1 | 1 | 1 | 1 | 0 | 0 | 0 | 0 | 0 | 0 | 0 | 0 | 0 | 0 | 0 | 0 | 0 | 0 | 0 | 0 | 0 | 0 | 0 | 0 | 0 | 0 | 0 | 0 | 0 | 0 | 0 | 0 | 0 | 0
 |  | nc |  | 0 | 0 | 0 | 0 | 0 | 0 | 0 | 0 | 0 | 0 | 0 | 1 | 1 | 1 | 1 | 1 | 1 | 1 | 1 | 1 | 1 | 1 | 0 | 0 | 0 | 0 | 0 | 0 | 0 | 0 | 0 | 0 | 0 | 0 | 0 | 0 | 0 | 0 | 0 | 0 | 0 | 0 | 0 | 0 | 0 | 0 | 0 | 0 | 0 | 0 | 0 | 0
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
#pins_def_val | 0x0000 |  |  |  |  | d27 | $F$27
time | 10
#I2C_Expander_00:etap 2
device | MCP23017 |  |  |  | 7 | 11 | $G$11
i2c_addr | 0x20 |  |  |  |  |  | $G$1
i2c_num | /dev/i2c-1
pins_mode | 0xFFFB |  |  |  |  | d24 | $G$24
pins_state | 0x0004 |  |  |  |  | d23 | $G$23
pins_pull_up | 0x0060 |  |  |  |  | d25 | $G$25
#pins_int | 0x0000 |  |  |  |  | d26 | $G$26
#pins_def_val | 0x0000 |  |  |  |  | d27 | $G$27
#pins_int | 10
#I2C_Expander_00:etap 3
device | MCP23017 |  |  |  | 8 | 11 | $H$11
i2c_addr | 0x20 |  |  |  |  |  | $H$1
i2c_num | /dev/i2c-1
pins_mode | 0xFFFB |  |  |  |  | d24 | $H$24
pins_state | 0x0004 |  |  |  |  | d23 | $H$23
pins_pull_up | 0x0060 |  |  |  |  | d25 | $H$25
#pins_int | 0x0000 |  |  |  |  | d26 | $H$26
#pins_def_val | 0x0000 |  |  |  |  | d27 | $H$27
#pins_int | 10
#I2C_Expander_00:etap 4
device | MCP23017 |  |  |  | 9 | 11 | $I$11
i2c_addr | 0x20 |  |  |  |  |  | $I$1
i2c_num | /dev/i2c-1
pins_mode | 0xFFFB |  |  |  |  | d24 | $I$24
pins_state | 0x0004 |  |  |  |  | d23 | $I$23
pins_pull_up | 0x0060 |  |  |  |  | d25 | $I$25
#pins_int | 0x0000 |  |  |  |  | d26 | $I$26
#pins_def_val | 0x0000 |  |  |  |  | d27 | $I$27
#pins_int | 10
#I2C_Expander_00:etap 5
device | MCP23017 |  |  |  | 10 | 11 | $J$11
i2c_addr | 0x20 |  |  |  |  |  | $J$1
i2c_num | /dev/i2c-1
pins_mode | 0xFFFB |  |  |  |  | d24 | $J$24
pins_state | 0x0004 |  |  |  |  | d23 | $J$23
pins_pull_up | 0x0060 |  |  |  |  | d25 | $J$25
#pins_int | 0x0000 |  |  |  |  | d26 | $J$26
#pins_def_val | 0x0000 |  |  |  |  | d27 | $J$27
#pins_int | 10
#I2C_Expander_00:etap 6
device | MCP23017 |  |  |  | 11 | 11 | $K$11
i2c_addr | 0x20 |  |  |  |  |  | $K$1
i2c_num | /dev/i2c-1
pins_mode | 0xFFFB |  |  |  |  | d24 | $K$24
pins_state | 0x0004 |  |  |  |  | d23 | $K$23
pins_pull_up | 0x0060 |  |  |  |  | d25 | $K$25
#pins_int | 0x0000 |  |  |  |  | d26 | $K$26
#pins_def_val | 0x0000 |  |  |  |  | d27 | $K$27
#pins_int | 10
#I2C_Expander_00:etap 7
device | MCP23017 |  |  |  | 12 | 11 | $L$11
i2c_addr | 0x20 |  |  |  |  |  | $L$1
i2c_num | /dev/i2c-1
pins_mode | 0xFFFB |  |  |  |  | d24 | $L$24
pins_state | 0x0004 |  |  |  |  | d23 | $L$23
pins_pull_up | 0x0060 |  |  |  |  | d25 | $L$25
#pins_int | 0x0000 |  |  |  |  | d26 | $L$26
#pins_def_val | 0x0000 |  |  |  |  | d27 | $L$27
#pins_int | 10
#I2C_Expander_00:etap 8
device | MCP23017 |  |  |  | 13 | 11 | $M$11
i2c_addr | 0x20 |  |  |  |  |  | $M$1
i2c_num | /dev/i2c-1
pins_mode | 0xFFFB |  |  |  |  | d24 | $M$24
pins_state | 0x0004 |  |  |  |  | d23 | $M$23
pins_pull_up | 0x0060 |  |  |  |  | d25 | $M$25
#pins_int | 0x0000 |  |  |  |  | d26 | $M$26
#pins_def_val | 0x0000 |  |  |  |  | d27 | $M$27
#pins_int | 10
#I2C_Expander_00:etap 9
device | MCP23017 |  |  |  | 14 | 11 | $N$11
i2c_addr | 0x20 |  |  |  |  |  | $N$1
i2c_num | /dev/i2c-1
pins_mode | 0xFFFB |  |  |  |  | d24 | $N$24
pins_state | 0x0004 |  |  |  |  | d23 | $N$23
pins_pull_up | 0x0060 |  |  |  |  | d25 | $N$25
#pins_int | 0x0000 |  |  |  |  | d26 | $N$26
#pins_def_val | 0x0000 |  |  |  |  | d27 | $N$27
#pins_int | 10
#I2C_Expander_00:etap 10
device | MCP23017 |  |  |  | 15 | 11 | $O$11
i2c_addr | 0x20 |  |  |  |  |  | $O$1
i2c_num | /dev/i2c-1
pins_mode | 0xFFFB |  |  |  |  | d24 | $O$24
pins_state | 0x0004 |  |  |  |  | d23 | $O$23
pins_pull_up | 0x0060 |  |  |  |  | d25 | $O$25
#pins_int | 0x0000 |  |  |  |  | d26 | $O$26
#pins_def_val | 0x0000 |  |  |  |  | d27 | $O$27
#pins_int | 10

Sheet: I2C_Expander_01
 |  | opis pinu na schemacie | komentarz | wartość safe | etap 1 | etap 2 | LTC6952_1 | etap 4 | etap 5 | etap 6 | etap 7 | etap 8 | etap 9 | etap 10 | pins_mode 0 - out | pins_mode etap1 | pins_mode etap2 | pins_mode etap3 | pins_mode etap4 | pins_mode etap5 | pins_mode etap6 | pins_mode etap7 | pins_mode etap8 | pins_mode etap9 | pins_mode etap10 | pins_pull_up 1 - enable | pins_pull_up etap 1 | pins_pull_up etap 2 | pins_pull_up etap 3 | pins_pull_up etap 4 | pins_pull_up etap 5 | pins_pull_up etap 6 | pins_pull_up etap 7 | pins_pull_up etap 8 | pins_pull_up etap 9 | pins_pull_up etap 10 | pin_int safe 1 - enable | pin_int etap 1 | pin_int etap 2 | pin_int etap 3 | pin_int etap 4 | pin_int etap 5 | pin_int etap 6 | pin_int etap 7 | pin_int etap 8 | pin_int etap 9 | pin_int etap 10 | Pin_def_state
 |  | nc |  | 0 | 0 | 0 | 0 | 0 | 0 | 0 | 0 | 0 | 0 | 0 | 1 | 1 | 1 | 1 | 1 | 1 | 1 | 1 | 1 | 1 | 1 | 0 | 0 | 0 | 0 | 0 | 0 | 0 | 0 | 0 | 0 | 0 | 0 | 0 | 0 | 0 | 0 | 0 | 0 | 0 | 0 | 0 | 0 | 0 | 0 | 0 | 0 | 0 | 0 | 0 | 0
 |  | nc |  | 0 | 0 | 0 | 0 | 0 | 0 | 0 | 0 | 0 | 0 | 0 | 1 | 1 | 1 | 1 | 1 | 1 | 1 | 1 | 1 | 1 | 1 | 0 | 0 | 0 | 0 | 0 | 0 | 0 | 0 | 0 | 0 | 0 | 0 | 0 | 0 | 0 | 0 | 0 | 0 | 0 | 0 | 0 | 0 | 0 | 0 | 0 | 0 | 0 | 0 | 0 | 0
 |  | nc |  | 0 | 0 | 0 | 0 | 0 | 0 | 0 | 0 | 0 | 0 | 0 | 1 | 1 | 1 | 1 | 1 | 1 | 1 | 1 | 1 | 1 | 1 | 0 | 0 | 0 | 0 | 0 | 0 | 0 | 0 | 0 | 0 | 0 | 0 | 0 | 0 | 0 | 0 | 0 | 0 | 0 | 0 | 0 | 0 | 0 | 0 | 0 | 0 | 0 | 0 | 0 | 0
 |  | nc |  | 0 | 0 | 0 | 0 | 0 | 0 | 0 | 0 | 0 | 0 | 0 | 1 | 1 | 1 | 1 | 1 | 1 | 1 | 1 | 1 | 1 | 1 | 0 | 0 | 0 | 0 | 0 | 0 | 0 | 0 | 0 | 0 | 0 | 0 | 0 | 0 | 0 | 0 | 0 | 0 | 0 | 0 | 0 | 0 | 0 | 0 | 0 | 0 | 0 | 0 | 0 | 0
 |  | nc |  | 0 | 0 | 0 | 0 | 0 | 0 | 0 | 0 | 0 | 0 | 0 | 1 | 1 | 1 | 1 | 1 | 1 | 1 | 1 | 1 | 1 | 1 | 0 | 0 | 0 | 0 | 0 | 0 | 0 | 0 | 0 | 0 | 0 | 0 | 0 | 0 | 0 | 0 | 0 | 0 | 0 | 0 | 0 | 0 | 0 | 0 | 0 | 0 | 0 | 0 | 0 | 0
 |  | USB_OVC | przeciążenie na szynie USB | 0 | 0 | 0 | 0 | 0 | 0 | 0 | 0 | 0 | 0 | 0 | 1 | 1 | 1 | 1 | 1 | 1 | 1 | 1 | 1 | 1 | 1 | 1 | 1 | 1 | 1 | 1 | 1 | 1 | 1 | 1 | 1 | 1 | 0 | 0 | 0 | 0 | 0 | 0 | 0 | 0 | 0 | 0 | 0 | 0 | 0 | 0 | 0 | 0 | 0 | 0 | 0
 |  | nc |  | 0 | 0 | 0 | 0 | 0 | 0 | 0 | 0 | 0 | 0 | 0 | 1 | 1 | 1 | 1 | 1 | 1 | 1 | 1 | 1 | 1 | 1 | 0 | 0 | 0 | 0 | 0 | 0 | 0 | 0 | 0 | 0 | 0 | 0 | 0 | 0 | 0 | 0 | 0 | 0 | 0 | 0 | 0 | 0 | 0 | 0 | 0 | 0 | 0 | 0 | 0 | 0
 |  | nc |  | 0 | 0 | 0 | 0 | 0 | 0 | 0 | 0 | 0 | 0 | 0 | 1 | 1 | 1 | 1 | 1 | 1 | 1 | 1 | 1 | 1 | 1 | 0 | 0 | 0 | 0 | 0 | 0 | 0 | 0 | 0 | 0 | 0 | 0 | 0 | 0 | 0 | 0 | 0 | 0 | 0 | 0 | 0 | 0 | 0 | 0 | 0 | 0 | 0 | 0 | 0 | 0
 |  |  |  | 00000000 | 00000000 | 00000000 | 00000000 | 00000000 | 00000000 | 00000000 | 00000000 | 00000000 | 00000000 | 00000000 | 11111111 | 11111111 | 11111111 | 11111111 | 11111111 | 11111111 | 11111111 | 11111111 | 11111111 | 11111111 | 11111111 | 00100000 | 00100000 | 00100000 | 00100000 | 00100000 | 00100000 | 00100000 | 00100000 | 00100000 | 00100000 | 00100000 | 00000000 | 00000000 | 00000000 | 00000000 | 00000000 | 00000000 | 00000000 | 00000000 | 00000000 | 00000000 | 00000000 | 00000000 | 00000000 | 00000000 | 00000000 | 00000000 | 00000000 | 00000000 | 00000000
 |  |  |  | 00 | 00 | 00 | 00 | 00 | 00 | 00 | 00 | 00 | 00 | 00 | FF | FF | FF | FF | FF | FF | FF | FF | FF | FF | FF | 20 | 20 | 20 | 20 | 20 | 20 | 20 | 20 | 20 | 20 | 20 | 00 | 00 | 00 | 00 | 00 | 00 | 00 | 00 | 00 | 00 | 00 | 00 | 00 | 00 | 00 | 00 | 00 | 00 | 00
 |  | nc |  | 0 | 0 | 0 | 0 | 0 | 0 | 0 | 0 | 0 | 0 | 0 | 1 | 1 | 1 | 1 | 1 | 1 | 1 | 1 | 1 | 1 | 1 | 0 | 0 | 0 | 0 | 0 | 0 | 0 | 0 | 0 | 0 | 0 | 0 | 0 | 0 | 0 | 0 | 0 | 0 | 0 | 0 | 0 | 0 | 0 | 0 | 0 | 0 | 0 | 0 | 0 | 0
 |  | nc |  | 0 | 0 | 0 | 0 | 0 | 0 | 0 | 0 | 0 | 0 | 0 | 1 | 1 | 1 | 1 | 1 | 1 | 1 | 1 | 1 | 1 | 1 | 0 | 0 | 0 | 0 | 0 | 0 | 0 | 0 | 0 | 0 | 0 | 0 | 0 | 0 | 0 | 0 | 0 | 0 | 0 | 0 | 0 | 0 | 0 | 0 | 0 | 0 | 0 | 0 | 0 | 0
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
#pins_def_val | 0x0000 |  |  |  |  | d27 | $F$27
time | 10
#I2C_Expander_01:etap 2
device | MCP23017 |  |  |  | 7 | 11 | $G$11
i2c_addr | 0x21 |  |  |  |  |  | $G$1
i2c_num | /dev/i2c-1
pins_mode | 0xFBFF |  |  |  |  | d24 | $G$24
pins_state | 0x0400 |  |  |  |  | d23 | $G$23
pins_pull_up | 0xC020 |  |  |  |  | d25 | $G$25
#pins_int | 0x0000 |  |  |  |  | d26 | $G$26
#pins_def_val | 0x0000 |  |  |  |  | d27 | $G$27
#pins_int | 10
#I2C_Expander_01:LTC6952_1
device | MCP23017 |  |  |  | 8 | 11 | $H$11
i2c_addr | 0x21 |  |  |  |  |  | $H$1
i2c_num | /dev/i2c-1
pins_mode | 0xFBFF |  |  |  |  | d24 | $H$24
pins_state | 0x0000 |  |  |  |  | d23 | $H$23
pins_pull_up | 0xC020 |  |  |  |  | d25 | $H$25
#pins_int | 0x0000 |  |  |  |  | d26 | $H$26
#pins_def_val | 0x0000 |  |  |  |  | d27 | $H$27
#pins_int | 10
#I2C_Expander_01:etap 4
device | MCP23017 |  |  |  | 9 | 11 | $I$11
i2c_addr | 0x21 |  |  |  |  |  | $I$1
i2c_num | /dev/i2c-1
pins_mode | 0xFBFF |  |  |  |  | d24 | $I$24
pins_state | 0x0400 |  |  |  |  | d23 | $I$23
pins_pull_up | 0xC020 |  |  |  |  | d25 | $I$25
#pins_int | 0x0000 |  |  |  |  | d26 | $I$26
#pins_def_val | 0x0000 |  |  |  |  | d27 | $I$27
#pins_int | 10
#I2C_Expander_01:etap 5
device | MCP23017 |  |  |  | 10 | 11 | $J$11
i2c_addr | 0x21 |  |  |  |  |  | $J$1
i2c_num | /dev/i2c-1
pins_mode | 0xFBFF |  |  |  |  | d24 | $J$24
pins_state | 0x0400 |  |  |  |  | d23 | $J$23
pins_pull_up | 0xC020 |  |  |  |  | d25 | $J$25
#pins_int | 0x0000 |  |  |  |  | d26 | $J$26
#pins_def_val | 0x0000 |  |  |  |  | d27 | $J$27
#pins_int | 10
#I2C_Expander_01:etap 6
device | MCP23017 |  |  |  | 11 | 11 | $K$11
i2c_addr | 0x21 |  |  |  |  |  | $K$1
i2c_num | /dev/i2c-1
pins_mode | 0xFBFF |  |  |  |  | d24 | $K$24
pins_state | 0x0400 |  |  |  |  | d23 | $K$23
pins_pull_up | 0xC020 |  |  |  |  | d25 | $K$25
#pins_int | 0x0000 |  |  |  |  | d26 | $K$26
#pins_def_val | 0x0000 |  |  |  |  | d27 | $K$27
#pins_int | 10
#I2C_Expander_01:etap 7
device | MCP23017 |  |  |  | 12 | 11 | $L$11
i2c_addr | 0x21 |  |  |  |  |  | $L$1
i2c_num | /dev/i2c-1
pins_mode | 0xFBFF |  |  |  |  | d24 | $L$24
pins_state | 0x0400 |  |  |  |  | d23 | $L$23
pins_pull_up | 0xC020 |  |  |  |  | d25 | $L$25
#pins_int | 0x0000 |  |  |  |  | d26 | $L$26
#pins_def_val | 0x0000 |  |  |  |  | d27 | $L$27
#pins_int | 10
#I2C_Expander_01:etap 8
device | MCP23017 |  |  |  | 13 | 11 | $M$11
i2c_addr | 0x21 |  |  |  |  |  | $M$1
i2c_num | /dev/i2c-1
pins_mode | 0xFBFF |  |  |  |  | d24 | $M$24
pins_state | 0x0400 |  |  |  |  | d23 | $M$23
pins_pull_up | 0xC020 |  |  |  |  | d25 | $M$25
#pins_int | 0x0000 |  |  |  |  | d26 | $M$26
#pins_def_val | 0x0000 |  |  |  |  | d27 | $M$27
#pins_int | 10
#I2C_Expander_01:etap 9
device | MCP23017 |  |  |  | 14 | 11 | $N$11
i2c_addr | 0x21 |  |  |  |  |  | $N$1
i2c_num | /dev/i2c-1
pins_mode | 0xFBFF |  |  |  |  | d24 | $N$24
pins_state | 0x0400 |  |  |  |  | d23 | $N$23
pins_pull_up | 0xC020 |  |  |  |  | d25 | $N$25
#pins_int | 0x0000 |  |  |  |  | d26 | $N$26
#pins_def_val | 0x0000 |  |  |  |  | d27 | $N$27
#pins_int | 10
#I2C_Expander_01:etap 10
device | MCP23017 |  |  |  | 15 | 11 | $O$11
i2c_addr | 0x21 |  |  |  |  |  | $O$1
i2c_num | /dev/i2c-1
pins_mode | 0xFBFF |  |  |  |  | d24 | $O$24
pins_state | 0x0400 |  |  |  |  | d23 | $O$23
pins_pull_up | 0xC020 |  |  |  |  | d25 | $O$25
#pins_int | 0x0000 |  |  |  |  | d26 | $O$26
#pins_def_val | 0x0000 |  |  |  |  | d27 | $O$27
#pins_int | 10

Sheet: I2C_Expander_02
 | Port+pin | opis pinu na schemacie | komentarz | wartość safe | etap 1 | etap 2 | DAC1220 | etap 4 En_SPI_PCIE0 | etap 5 En_SPI_PCIE3 | etap 6 | etap 7 | etap 8 | etap 9 | etap 10 | pins_mode 0 - out | pins_mode etap1 | pins_mode etap2 | pins_mode etap3 | pins_mode etap4 | pins_mode etap5 | pins_mode etap6 | pins_mode etap7 | pins_mode etap8 | pins_mode etap9 | pins_mode etap10 | pins_pull_up 1 - enable | pins_pull_up etap 1 | pins_pull_up etap 2 | pins_pull_up etap 3 | pins_pull_up etap 4 | pins_pull_up etap 5 | pins_pull_up etap 6 | pins_pull_up etap 7 | pins_pull_up etap 8 | pins_pull_up etap 9 | pins_pull_up etap 10 | pin_int safe 1 - enable | pin_int etap 1 | pin_int etap 2 | pin_int etap 3 | pin_int etap 4 | pin_int etap 5 | pin_int etap 6 | pin_int etap 7 | pin_int etap 8 | pin_int etap 9 | pin_int etap 10 | Pin_def_state
 | GPA0 | PCIE_Resets.PCIE_Resets_0 | sygnał reset dla karty w złączu 0 | 0 | 1 | 1 | 1 | 1 | 1 | 1 | 1 | 1 | 1 | 1 | 0 | 0 | 0 | 0 | 0 | 0 | 0 | 0 | 0 | 0 | 0 | 0 | 0 | 0 | 0 | 0 | 0 | 0 | 0 | 0 | 0 | 0 | 0 | 0 | 0 | 0 | 0 | 0 | 0 | 0 | 0 | 0 | 0 | 0 | 0 | 0 | 0 | 0 | 0 | 0 | 0
 | GPA1 | CTRL_SPI_B.En_SPI_Q3 | wyłączanie komunikacji z DAC-em | 1 | 1 | 1 | 0 | 1 | 1 | 1 | 1 | 1 | 1 | 1 | 0 | 0 | 0 | 0 | 0 | 0 | 0 | 0 | 0 | 0 | 0 | 0 | 0 | 0 | 0 | 0 | 0 | 0 | 0 | 0 | 0 | 0 | 0 | 0 | 0 | 0 | 0 | 0 | 0 | 0 | 0 | 0 | 0 | 0 | 0 | 0 | 0 | 0 | 0 | 0 | 0
 | GPA2 | nc |  | 0 | 0 | 0 | 0 | 0 | 0 | 0 | 0 | 0 | 0 | 0 | 1 | 1 | 1 | 1 | 1 | 1 | 1 | 1 | 1 | 1 | 1 | 0 | 0 | 0 | 0 | 0 | 0 | 0 | 0 | 0 | 0 | 0 | 0 | 0 | 0 | 0 | 0 | 0 | 0 | 0 | 0 | 0 | 0 | 0 | 0 | 0 | 0 | 0 | 0 | 0 | 0
 | GPA3 | nc |  | 0 | 0 | 0 | 0 | 0 | 0 | 0 | 0 | 0 | 0 | 0 | 1 | 1 | 1 | 1 | 1 | 1 | 1 | 1 | 1 | 1 | 1 | 0 | 0 | 0 | 0 | 0 | 0 | 0 | 0 | 0 | 0 | 0 | 0 | 0 | 0 | 0 | 0 | 0 | 0 | 0 | 0 | 0 | 0 | 0 | 0 | 0 | 0 | 0 | 0 | 0 | 0
 | GPA4 | nc |  | 0 | 0 | 0 | 0 | 0 | 0 | 0 | 0 | 0 | 0 | 0 | 1 | 1 | 1 | 1 | 1 | 1 | 1 | 1 | 1 | 1 | 1 | 0 | 0 | 0 | 0 | 0 | 0 | 0 | 0 | 0 | 0 | 0 | 0 | 0 | 0 | 0 | 0 | 0 | 0 | 0 | 0 | 0 | 0 | 0 | 0 | 0 | 0 | 0 | 0 | 0 | 0
 | GPA5 | nc |  | 0 | 0 | 0 | 0 | 0 | 0 | 0 | 0 | 0 | 0 | 0 | 1 | 1 | 1 | 1 | 1 | 1 | 1 | 1 | 1 | 1 | 1 | 0 | 0 | 0 | 0 | 0 | 0 | 0 | 0 | 0 | 0 | 0 | 0 | 0 | 0 | 0 | 0 | 0 | 0 | 0 | 0 | 0 | 0 | 0 | 0 | 0 | 0 | 0 | 0 | 0 | 0
 | GPA6 | nc |  | 0 | 0 | 0 | 0 | 0 | 0 | 0 | 0 | 0 | 0 | 0 | 1 | 1 | 1 | 1 | 1 | 1 | 1 | 1 | 1 | 1 | 1 | 0 | 0 | 0 | 0 | 0 | 0 | 0 | 0 | 0 | 0 | 0 | 0 | 0 | 0 | 0 | 0 | 0 | 0 | 0 | 0 | 0 | 0 | 0 | 0 | 0 | 0 | 0 | 0 | 0 | 0
 | GPA7 | Ctrl_Pwr_4HiSpeed.EN_PWR_PCIE_3 | wlązanie 12V dla karty w złączu PCIE_3 | 0 | 0 | 1 | 1 | 1 | 1 | 1 | 1 | 1 | 1 | 1 | 0 | 0 | 0 | 0 | 0 | 0 | 0 | 0 | 0 | 0 | 0 | 0 | 0 | 0 | 0 | 0 | 0 | 0 | 0 | 0 | 0 | 0 | 0 | 0 | 0 | 0 | 0 | 0 | 0 | 0 | 0 | 0 | 0 | 0 | 0 | 0 | 0 | 0 | 0 | 0 | 0
 |  |  |  | 00000010 | 00000011 | 10000011 | 10000001 | 10000011 | 10000011 | 10000011 | 10000011 | 10000011 | 10000011 | 10000011 | 01111100 | 01111100 | 01111100 | 01111100 | 01111100 | 01111100 | 01111100 | 01111100 | 01111100 | 01111100 | 01111100 | 00000000 | 00000000 | 00000000 | 00000000 | 00000000 | 00000000 | 00000000 | 00000000 | 00000000 | 00000000 | 00000000 | 00000000 | 00000000 | 00000000 | 00000000 | 00000000 | 00000000 | 00000000 | 00000000 | 00000000 | 00000000 | 00000000 | 00000000 | 00000000 | 00000000 | 00000000 | 00000000 | 00000000 | 00000000 | 00000000
 | GPA |  |  | 02 | 03 | 83 | 81 | 83 | 83 | 83 | 83 | 83 | 83 | 83 | 7C | 7C | 7C | 7C | 7C | 7C | 7C | 7C | 7C | 7C | 7C | 00 | 00 | 00 | 00 | 00 | 00 | 00 | 00 | 00 | 00 | 00 | 00 | 00 | 00 | 00 | 00 | 00 | 00 | 00 | 00 | 00 | 00 | 00 | 00 | 00 | 00 | 00 | 00 | 00 | 00
 | GPB0 | Reset_Bridge_I2C_PCIE | reset dla mostka I2C_Bridge_PCIE | 0 | 1 | 1 | 1 | 1 | 1 | 1 | 1 | 1 | 1 | 1 | 0 | 0 | 0 | 0 | 0 | 0 | 0 | 0 | 0 | 0 | 0 | 0 | 0 | 0 | 0 | 0 | 0 | 0 | 0 | 0 | 0 | 0 | 0 | 0 | 0 | 0 | 0 | 0 | 0 | 0 | 0 | 0 | 0 | 0 | 0 | 0 | 0 | 0 | 0 | 0 | 0
 | GPB1 | nc |  | 0 | 0 | 0 | 0 | 0 | 0 | 0 | 0 | 0 | 0 | 0 | 1 | 1 | 1 | 1 | 1 | 1 | 1 | 1 | 1 | 1 | 1 | 0 | 0 | 0 | 0 | 0 | 0 | 0 | 0 | 0 | 0 | 0 | 0 | 0 | 0 | 0 | 0 | 0 | 0 | 0 | 0 | 0 | 0 | 0 | 0 | 0 | 0 | 0 | 0 | 0 | 0
 | GPB2 | PCIE_Resets.PCIE_Resets_3 | sygnał reset dla karty w złączu 3 | 0 | 1 | 1 | 1 | 1 | 1 | 1 | 1 | 1 | 1 | 1 | 0 | 0 | 0 | 0 | 0 | 0 | 0 | 0 | 0 | 0 | 0 | 0 | 0 | 0 | 0 | 0 | 0 | 0 | 0 | 0 | 0 | 0 | 0 | 0 | 0 | 0 | 0 | 0 | 0 | 0 | 0 | 0 | 0 | 0 | 0 | 0 | 0 | 0 | 0 | 0 | 0
 | GPB3 | Ctrl_SPI_A.EN_SPI_Q3 | wyłączanie komunikacji z kartą podłączoną do PCIE_3 | 1 | 1 | 1 | 1 | 1 | 0 | 1 | 1 | 1 | 1 | 1 | 0 | 0 | 0 | 0 | 0 | 0 | 0 | 0 | 0 | 0 | 0 | 0 | 0 | 0 | 0 | 0 | 0 | 0 | 0 | 0 | 0 | 0 | 0 | 0 | 0 | 0 | 0 | 0 | 0 | 0 | 0 | 0 | 0 | 0 | 0 | 0 | 0 | 0 | 0 | 0 | 0
 | GPB4 | PG_VTT_RAM | potwierdzenie poprawnego działania zasilania | 0 | 0 | 0 | 0 | 0 | 0 | 0 | 0 | 0 | 0 | 0 | 1 | 1 | 1 | 1 | 1 | 1 | 1 | 1 | 1 | 1 | 1 | 1 | 1 | 1 | 1 | 1 | 1 | 1 | 1 | 1 | 1 | 1 | 0 | 0 | 0 | 0 | 0 | 0 | 0 | 0 | 0 | 0 | 0 | 0 | 0 | 0 | 0 | 0 | 0 | 0 | 0
 | GPB5 | Ctrl_SPI_A.EN_SPI_Q0 | wyłączanie komunikacji z kartą podłączoną do PCIE_0 | 1 | 1 | 1 | 1 | 0 | 1 | 1 | 1 | 1 | 1 | 1 | 0 | 0 | 0 | 0 | 0 | 0 | 0 | 0 | 0 | 0 | 0 | 0 | 0 | 0 | 0 | 0 | 0 | 0 | 0 | 0 | 0 | 0 | 0 | 0 | 0 | 0 | 0 | 0 | 0 | 0 | 0 | 0 | 0 | 0 | 0 | 0 | 0 | 0 | 0 | 0 | 0
 | GPB6 | nc |  | 0 | 0 | 0 | 0 | 0 | 0 | 0 | 0 | 0 | 0 | 0 | 1 | 1 | 1 | 1 | 1 | 1 | 1 | 1 | 1 | 1 | 1 | 0 | 0 | 0 | 0 | 0 | 0 | 0 | 0 | 0 | 0 | 0 | 0 | 0 | 0 | 0 | 0 | 0 | 0 | 0 | 0 | 0 | 0 | 0 | 0 | 0 | 0 | 0 | 0 | 0 | 0
 | GPB7 | nc |  | 0 | 0 | 0 | 0 | 0 | 0 | 0 | 0 | 0 | 0 | 0 | 1 | 1 | 1 | 1 | 1 | 1 | 1 | 1 | 1 | 1 | 1 | 0 | 0 | 0 | 0 | 0 | 0 | 0 | 0 | 0 | 0 | 0 | 0 | 0 | 0 | 0 | 0 | 0 | 0 | 0 | 0 | 0 | 0 | 0 | 0 | 0 | 0 | 0 | 0 | 0 | 0
 |  |  |  | 00101000 | 00101101 | 00101101 | 00101101 | 00001101 | 00100101 | 00101101 | 00101101 | 00101101 | 00101101 | 00101101 | 11010010 | 11010010 | 11010010 | 11010010 | 11010010 | 11010010 | 11010010 | 11010010 | 11010010 | 11010010 | 11010010 | 00010000 | 00010000 | 00010000 | 00010000 | 00010000 | 00010000 | 00010000 | 00010000 | 00010000 | 00010000 | 00010000 | 00000000 | 00000000 | 00000000 | 00000000 | 00000000 | 00000000 | 00000000 | 00000000 | 00000000 | 00000000 | 00000000 | 00000000 | 00000000 | 00000000 | 00000000 | 00000000 | 00000000 | 00000000 | 00000000
 | hex |  | GPA | 28 | 2D | 2D | 2D | 0D | 25 | 2D | 2D | 2D | 2D | 2D | D2 | D2 | D2 | D2 | D2 | D2 | D2 | D2 | D2 | D2 | D2 | 10 | 10 | 10 | 10 | 10 | 10 | 10 | 10 | 10 | 10 | 10 | 00 | 00 | 00 | 00 | 00 | 00 | 00 | 00 | 00 | 00 | 00 | 00 | 00 | 00 | 00 | 00 | 00 | 00 | 00
 |  |  | pins_state | 0x2802 | 0x2D03 | 0x2D83 | 0x2D81 | 0x0D83 | 0x2583 | 0x2D83 | 0x2D83 | 0x2D83 | 0x2D83 | 0x2D83 | 0xD27C | 0xD27C | 0xD27C | 0xD27C | 0xD27C | 0xD27C | 0xD27C | 0xD27C | 0xD27C | 0xD27C | 0xD27C | 0x1000 | 0x1000 | 0x1000 | 0x1000 | 0x1000 | 0x1000 | 0x1000 | 0x1000 | 0x1000 | 0x1000 | 0x1000 | 0x0000 | 0x0000 | 0x0000 | 0x0000 | 0x0000 | 0x0000 | 0x0000 | 0x0000 | 0x0000 | 0x0000 | 0x0000 | 0x0000 | 0x0000 | 0x0000 | 0x0000 | 0x0000 | 0x0000 | 0x0000 | 0x0000
 |  |  | pins_mode | 0xD27C | 0xD27C | 0xD27C | 0xD27C | 0xD27C | 0xD27C | 0xD27C | 0xD27C | 0xD27C | 0xD27C | 0xD27C | pins_mode |  |  |  |  |  |  |  |  |  |  | pins_pull_up |  |  |  |  |  |  |  |  |  |  | #pins_int |  |  |  |  |  |  |  |  |  |  | #pins_def_val
device |  |  | pins_pull_up | 0x1000 | 0x1000 | 0x1000 | 0x1000 | 0x1000 | 0x1000 | 0x1000 | 0x1000 | 0x1000 | 0x1000 | 0x1000
# nazwa układu | MCP23017 | I2C_Expander_02 | #pins_int | 0x0000 | 0x0000 | 0x0000 | 0x0000 | 0x0000 | 0x0000 | 0x0000 | 0x0000 | 0x0000 | 0x0000 | 0x0000
czas pomiędzy wartość safe a krok 1 [ms] | 500 |  | #pins_def_val | 0x0000 | 0x0000 | 0x0000 | 0x0000 | 0x0000 | 0x0000 | 0x0000 | 0x0000 | 0x0000 | 0x0000 | 0x0000
Czas pomiędzy etap 1, a etap 2 | 10
Czas pomiędzy etap 2, a etap 3 | 0
addr | 0x22
#I2C_Expander_02:wartość safe
device | MCP23017 |  |  |  | 5 | 11 | $E$11
i2c_addr | 0x22 |  |  |  |  |  | $E$1
i2c_num | /dev/i2c-1
pins_mode | 0xD27C |  |  |  |  | $Q$24 | $Q$23
pins_state | 0x2802 |  |  |  |  | $D$23 | $E$23
time | 500
#I2C_Expander_02:etap 1
device | MCP23017 |  |  |  | 6 | 11 | $F$11
i2c_addr | 0x22 |  |  |  |  |  | $F$1
i2c_num | /dev/i2c-1
pins_mode | 0xD27C |  |  |  |  | d24 | $F$24
pins_state | 0x2D03 |  |  |  |  | d23 | $F$23
pins_pull_up | 0x1000 |  |  |  |  | d25 | $F$25
#pins_int | 0x0000 |  |  |  |  | d26 | $F$26
#pins_def_val | 0x0000 |  |  |  |  | d27 | $F$27
time | 10
#I2C_Expander_02:etap 2
device | MCP23017 |  |  |  | 7 | 11 | $G$11
i2c_addr | 0x22 |  |  |  |  |  | $G$1
i2c_num | /dev/i2c-1
pins_mode | 0xD27C |  |  |  |  | d24 | $G$24
pins_state | 0x2D83 |  |  |  |  | d23 | $G$23
pins_pull_up | 0x1000 |  |  |  |  | d25 | $G$25
#pins_int | 0x0000 |  |  |  |  | d26 | $G$26
#pins_def_val | 0x0000 |  |  |  |  | d27 | $G$27
#pins_int | 10
#I2C_Expander_02:DAC1220
device | MCP23017 |  |  |  | 8 | 11 | $H$11
i2c_addr | 0x22 |  |  |  |  |  | $H$1
i2c_num | /dev/i2c-1
pins_mode | 0xD27C |  |  |  |  | d24 | $H$24
pins_state | 0x2D81 |  |  |  |  | d23 | $H$23
pins_pull_up | 0x1000 |  |  |  |  | d25 | $H$25
#pins_int | 0x0000 |  |  |  |  | d26 | $H$26
#pins_def_val | 0x0000 |  |  |  |  | d27 | $H$27
#pins_int | 10
#I2C_Expander_02:etap 4 En_SPI_PCIE0
device | MCP23017 |  |  |  | 9 | 11 | $I$11
i2c_addr | 0x22 |  |  |  |  |  | $I$1
i2c_num | /dev/i2c-1
pins_mode | 0xD27C |  |  |  |  | d24 | $I$24
pins_state | 0x0D83 |  |  |  |  | d23 | $I$23
pins_pull_up | 0x1000 |  |  |  |  | d25 | $I$25
#pins_int | 0x0000 |  |  |  |  | d26 | $I$26
#pins_def_val | 0x0000 |  |  |  |  | d27 | $I$27
#pins_int | 10
#I2C_Expander_02:etap 5 En_SPI_PCIE3
device | MCP23017 |  |  |  | 10 | 11 | $J$11
i2c_addr | 0x22 |  |  |  |  |  | $J$1
i2c_num | /dev/i2c-1
pins_mode | 0xD27C |  |  |  |  | d24 | $J$24
pins_state | 0x2583 |  |  |  |  | d23 | $J$23
pins_pull_up | 0x1000 |  |  |  |  | d25 | $J$25
#pins_int | 0x0000 |  |  |  |  | d26 | $J$26
#pins_def_val | 0x0000 |  |  |  |  | d27 | $J$27
#pins_int | 10
#I2C_Expander_02:etap 6
device | MCP23017 |  |  |  | 11 | 11 | $K$11
i2c_addr | 0x22 |  |  |  |  |  | $K$1
i2c_num | /dev/i2c-1
pins_mode | 0xD27C |  |  |  |  | d24 | $K$24
pins_state | 0x2D83 |  |  |  |  | d23 | $K$23
pins_pull_up | 0x1000 |  |  |  |  | d25 | $K$25
#pins_int | 0x0000 |  |  |  |  | d26 | $K$26
#pins_def_val | 0x0000 |  |  |  |  | d27 | $K$27
#pins_int | 10
#I2C_Expander_02:etap 7
device | MCP23017 |  |  |  | 12 | 11 | $L$11
i2c_addr | 0x22 |  |  |  |  |  | $L$1
i2c_num | /dev/i2c-1
pins_mode | 0xD27C |  |  |  |  | d24 | $L$24
pins_state | 0x2D83 |  |  |  |  | d23 | $L$23
pins_pull_up | 0x1000 |  |  |  |  | d25 | $L$25
#pins_int | 0x0000 |  |  |  |  | d26 | $L$26
#pins_def_val | 0x0000 |  |  |  |  | d27 | $L$27
#pins_int | 10
#I2C_Expander_02:etap 8
device | MCP23017 |  |  |  | 13 | 11 | $M$11
i2c_addr | 0x22 |  |  |  |  |  | $M$1
i2c_num | /dev/i2c-1
pins_mode | 0xD27C |  |  |  |  | d24 | $M$24
pins_state | 0x2D83 |  |  |  |  | d23 | $M$23
pins_pull_up | 0x1000 |  |  |  |  | d25 | $M$25
#pins_int | 0x0000 |  |  |  |  | d26 | $M$26
#pins_def_val | 0x0000 |  |  |  |  | d27 | $M$27
#pins_int | 10
#I2C_Expander_02:etap 9
device | MCP23017 |  |  |  | 14 | 11 | $N$11
i2c_addr | 0x22 |  |  |  |  |  | $N$1
i2c_num | /dev/i2c-1
pins_mode | 0xD27C |  |  |  |  | d24 | $N$24
pins_state | 0x2D83 |  |  |  |  | d23 | $N$23
pins_pull_up | 0x1000 |  |  |  |  | d25 | $N$25
#pins_int | 0x0000 |  |  |  |  | d26 | $N$26
#pins_def_val | 0x0000 |  |  |  |  | d27 | $N$27
#pins_int | 10
#I2C_Expander_02:etap 10
device | MCP23017 |  |  |  | 15 | 11 | $O$11
i2c_addr | 0x22 |  |  |  |  |  | $O$1
i2c_num | /dev/i2c-1
pins_mode | 0xD27C |  |  |  |  | d24 | $O$24
pins_state | 0x2D83 |  |  |  |  | d23 | $O$23
pins_pull_up | 0x1000 |  |  |  |  | d25 | $O$25
#pins_int | 0x0000 |  |  |  |  | d26 | $O$26
#pins_def_val | 0x0000 |  |  |  |  | d27 | $O$27
#pins_int | 10

Sheet: I2C_Expander_10
 | port | opis pinu na schemacie | komentarz | wartość safe | etap 1 | etap 2 | etap 3 | etap 4 złacze En_SPI_PCIE2 | etap 5 | etap 6 | etap 7 | etap 8 | etap 9 | etap 10 | pins_mode 0 - out | pins_mode etap1 | pins_mode etap2 | pins_mode etap3 | pins_mode etap4 | pins_mode etap5 | pins_mode etap6 | pins_mode etap7 | pins_mode etap8 | pins_mode etap9 | pins_mode etap10 | pins_pull_up 1 - enable | pins_pull_up etap 1 | pins_pull_up etap 2 | pins_pull_up etap 3 | pins_pull_up etap 4 | pins_pull_up etap 5 | pins_pull_up etap 6 | pins_pull_up etap 7 | pins_pull_up etap 8 | pins_pull_up etap 9 | pins_pull_up etap 10 | pin_int safe 1 - enable | pin_int etap 1 | pin_int etap 2 | pin_int etap 3 | pin_int etap 4 | pin_int etap 5 | pin_int etap 6 | pin_int etap 7 | pin_int etap 8 | pin_int etap 9 | pin_int etap 10 | Pin_def_state
 | GPA0 | Ctrl_Pwr_4HiSpeed.EN_PWR_PCIE_2 | włączenie 12V dla karty w złączu PCIE_2 | 0 | 0 | 1 | 1 | 1 | 1 | 1 | 1 | 1 | 1 | 1 | 0 | 0 | 0 | 0 | 0 | 0 | 0 | 0 | 0 | 0 | 0 | 0 | 0 | 0 | 0 | 0 | 0 | 0 | 0 | 0 | 0 | 0 | 0 | 0 | 0 | 0 | 0 | 0 | 0 | 0 | 0 | 0 | 0 | 0 | 0 | 0 | 0 | 0 | 0 | 0 | 0
 | GPA1 | nc |  | 0 | 0 | 0 | 0 | 0 | 0 | 0 | 0 | 0 | 0 | 0 | 1 | 1 | 1 | 1 | 1 | 1 | 1 | 1 | 1 | 1 | 1 | 0 | 0 | 0 | 0 | 0 | 0 | 0 | 0 | 0 | 0 | 0 | 0 | 0 | 0 | 0 | 0 | 0 | 0 | 0 | 0 | 0 | 0 | 0 | 0 | 0 | 0 | 0 | 0 | 0 | 0
 | GPA2 | nc |  | 0 | 0 | 0 | 0 | 0 | 0 | 0 | 0 | 0 | 0 | 0 | 1 | 1 | 1 | 1 | 1 | 1 | 1 | 1 | 1 | 1 | 1 | 0 | 0 | 0 | 0 | 0 | 0 | 0 | 0 | 0 | 0 | 0 | 0 | 0 | 0 | 0 | 0 | 0 | 0 | 0 | 0 | 0 | 0 | 0 | 0 | 0 | 0 | 0 | 0 | 0 | 0
 | GPA3 | nc |  | 0 | 0 | 0 | 0 | 0 | 0 | 0 | 0 | 0 | 0 | 0 | 1 | 1 | 1 | 1 | 1 | 1 | 1 | 1 | 1 | 1 | 1 | 0 | 0 | 0 | 0 | 0 | 0 | 0 | 0 | 0 | 0 | 0 | 0 | 0 | 0 | 0 | 0 | 0 | 0 | 0 | 0 | 0 | 0 | 0 | 0 | 0 | 0 | 0 | 0 | 0 | 0
 | GPA4 | nc |  | 0 | 0 | 0 | 0 | 0 | 0 | 0 | 0 | 0 | 0 | 0 | 1 | 1 | 1 | 1 | 1 | 1 | 1 | 1 | 1 | 1 | 1 | 0 | 0 | 0 | 0 | 0 | 0 | 0 | 0 | 0 | 0 | 0 | 0 | 0 | 0 | 0 | 0 | 0 | 0 | 0 | 0 | 0 | 0 | 0 | 0 | 0 | 0 | 0 | 0 | 0 | 0
 | GPA5 | nc |  | 0 | 0 | 0 | 0 | 0 | 0 | 0 | 0 | 0 | 0 | 0 | 1 | 1 | 1 | 1 | 1 | 1 | 1 | 1 | 1 | 1 | 1 | 0 | 0 | 0 | 0 | 0 | 0 | 0 | 0 | 0 | 0 | 0 | 0 | 0 | 0 | 0 | 0 | 0 | 0 | 0 | 0 | 0 | 0 | 0 | 0 | 0 | 0 | 0 | 0 | 0 | 0
 | GPA6 | nc |  | 0 | 0 | 0 | 0 | 0 | 0 | 0 | 0 | 0 | 0 | 0 | 1 | 1 | 1 | 1 | 1 | 1 | 1 | 1 | 1 | 1 | 1 | 0 | 0 | 0 | 0 | 0 | 0 | 0 | 0 | 0 | 0 | 0 | 0 | 0 | 0 | 0 | 0 | 0 | 0 | 0 | 0 | 0 | 0 | 0 | 0 | 0 | 0 | 0 | 0 | 0 | 0
 | GPA7 | nc |  | 0 | 0 | 0 | 0 | 0 | 0 | 0 | 0 | 0 | 0 | 0 | 1 | 1 | 1 | 1 | 1 | 1 | 1 | 1 | 1 | 1 | 1 | 0 | 0 | 0 | 0 | 0 | 0 | 0 | 0 | 0 | 0 | 0 | 0 | 0 | 0 | 0 | 0 | 0 | 0 | 0 | 0 | 0 | 0 | 0 | 0 | 0 | 0 | 0 | 0 | 0 | 0
 |  |  |  | 00000000 | 00000000 | 00000001 | 00000001 | 00000001 | 00000001 | 00000001 | 00000001 | 00000001 | 00000001 | 00000001 | 11111110 | 11111110 | 11111110 | 11111110 | 11111110 | 11111110 | 11111110 | 11111110 | 11111110 | 11111110 | 11111110 | 00000000 | 00000000 | 00000000 | 00000000 | 00000000 | 00000000 | 00000000 | 00000000 | 00000000 | 00000000 | 00000000 | 00000000 | 00000000 | 00000000 | 00000000 | 00000000 | 00000000 | 00000000 | 00000000 | 00000000 | 00000000 | 00000000 | 00000000 | 00000000 | 00000000 | 00000000 | 00000000 | 00000000 | 00000000 | 00000000
 | GPA |  |  | 00 | 00 | 01 | 01 | 01 | 01 | 01 | 01 | 01 | 01 | 01 | FE | FE | FE | FE | FE | FE | FE | FE | FE | FE | FE | 00 | 00 | 00 | 00 | 00 | 00 | 00 | 00 | 00 | 00 | 00 | 00 | 00 | 00 | 00 | 00 | 00 | 00 | 00 | 00 | 00 | 00 | 00 | 00 | 00 | 00 | 00 | 00 | 00 | 00
 | GPB0 | nc |  | 0 | 0 | 0 | 0 | 0 | 0 | 0 | 0 | 0 | 0 | 0 | 1 | 1 | 1 | 1 | 1 | 1 | 1 | 1 | 1 | 1 | 1 | 0 | 0 | 0 | 0 | 0 | 0 | 0 | 0 | 0 | 0 | 0 | 0 | 0 | 0 | 0 | 0 | 0 | 0 | 0 | 0 | 0 | 0 | 0 | 0 | 0 | 0 | 0 | 0 | 0 | 0
 | GPB1 | nc |  | 0 | 0 | 0 | 0 | 0 | 0 | 0 | 0 | 0 | 0 | 0 | 1 | 1 | 1 | 1 | 1 | 1 | 1 | 1 | 1 | 1 | 1 | 0 | 0 | 0 | 0 | 0 | 0 | 0 | 0 | 0 | 0 | 0 | 0 | 0 | 0 | 0 | 0 | 0 | 0 | 0 | 0 | 0 | 0 | 0 | 0 | 0 | 0 | 0 | 0 | 0 | 0
 | GPB2 | Ctrl_Pwr_4HiSpeed.EN_PWR_PCIE_0 | włączenie 12V dla karty w złączu PCIE_0 | 0 | 0 | 1 | 1 | 1 | 1 | 1 | 1 | 1 | 1 | 1 | 0 | 0 | 0 | 0 | 0 | 0 | 0 | 0 | 0 | 0 | 0 | 0 | 0 | 0 | 0 | 0 | 0 | 0 | 0 | 0 | 0 | 0 | 0 | 0 | 0 | 0 | 0 | 0 | 0 | 0 | 0 | 0 | 0 | 0 | 0 | 0 | 0 | 0 | 0 | 0 | 0
 | GPB3 | nc |  | 0 | 0 | 0 | 0 | 0 | 0 | 0 | 0 | 0 | 0 | 0 | 1 | 1 | 1 | 1 | 1 | 1 | 1 | 1 | 1 | 1 | 1 | 0 | 0 | 0 | 0 | 0 | 0 | 0 | 0 | 0 | 0 | 0 | 0 | 0 | 0 | 0 | 0 | 0 | 0 | 0 | 0 | 0 | 0 | 0 | 0 | 0 | 0 | 0 | 0 | 0 | 0
 | GPB4 | nc |  | 0 | 0 | 0 | 0 | 0 | 0 | 0 | 0 | 0 | 0 | 0 | 1 | 1 | 1 | 1 | 1 | 1 | 1 | 1 | 1 | 1 | 1 | 0 | 0 | 0 | 0 | 0 | 0 | 0 | 0 | 0 | 0 | 0 | 0 | 0 | 0 | 0 | 0 | 0 | 0 | 0 | 0 | 0 | 0 | 0 | 0 | 0 | 0 | 0 | 0 | 0 | 0
 | GPB5 | Periph_GPIO.ETH_Reset | reset serializera dla ethernetu | 0 | 1 | 1 | 1 | 1 | 1 | 1 | 1 | 1 | 1 | 1 | 0 | 0 | 0 | 0 | 0 | 0 | 0 | 0 | 0 | 0 | 0 | 0 | 0 | 0 | 0 | 0 | 0 | 0 | 0 | 0 | 0 | 0 | 0 | 0 | 0 | 0 | 0 | 0 | 0 | 0 | 0 | 0 | 0 | 0 | 0 | 0 | 0 | 0 | 0 | 0 | 0
 | GPB6 | PCIE_Resets.PCIE_Resets_2 | sygnał reset dla karty w złączu 2 | 0 | 1 | 1 | 1 | 1 | 1 | 1 | 1 | 1 | 1 | 1 | 0 | 0 | 0 | 0 | 0 | 0 | 0 | 0 | 0 | 0 | 0 | 0 | 0 | 0 | 0 | 0 | 0 | 0 | 0 | 0 | 0 | 0 | 0 | 0 | 0 | 0 | 0 | 0 | 0 | 0 | 0 | 0 | 0 | 0 | 0 | 0 | 0 | 0 | 0 | 0 | 0
 | GPB7 | CTRL_SPI_A.En_SPI_Q2 | wyłączanie komunikacji z kartą podłączoną do PCIE_2 | 1 | 1 | 1 | 1 | 0 | 1 | 1 | 1 | 1 | 1 | 1 | 0 | 0 | 0 | 0 | 0 | 0 | 0 | 0 | 0 | 0 | 0 | 0 | 0 | 0 | 0 | 0 | 0 | 0 | 0 | 0 | 0 | 0 | 0 | 0 | 0 | 0 | 0 | 0 | 0 | 0 | 0 | 0 | 0 | 0 | 0 | 0 | 0 | 0 | 0 | 0 | 0
 |  |  |  | 10000000 | 11100000 | 11100100 | 11100100 | 01100100 | 11100100 | 11100100 | 11100100 | 11100100 | 11100100 | 11100100 | 00011011 | 00011011 | 00011011 | 00011011 | 00011011 | 00011011 | 00011011 | 00011011 | 00011011 | 00011011 | 00011011 | 00000000 | 00000000 | 00000000 | 00000000 | 00000000 | 00000000 | 00000000 | 00000000 | 00000000 | 00000000 | 00000000 | 00000000 | 00000000 | 00000000 | 00000000 | 00000000 | 00000000 | 00000000 | 00000000 | 00000000 | 00000000 | 00000000 | 00000000 | 00000000 | 00000000 | 00000000 | 00000000 | 00000000 | 00000000 | 00000000
 | hex |  |  | 80 | E0 | E4 | E4 | 64 | E4 | E4 | E4 | E4 | E4 | E4 | 1B | 1B | 1B | 1B | 1B | 1B | 1B | 1B | 1B | 1B | 1B | 00 | 00 | 00 | 00 | 00 | 00 | 00 | 00 | 00 | 00 | 00 | 00 | 00 | 00 | 00 | 00 | 00 | 00 | 00 | 00 | 00 | 00 | 00 | 00 | 00 | 00 | 00 | 00 | 00 | 00
 |  |  | pins_state | 0x8000 | 0xE000 | 0xE401 | 0xE401 | 0x6401 | 0xE401 | 0xE401 | 0xE401 | 0xE401 | 0xE401 | 0xE401 | 0x1BFE | 0x1BFE | 0x1BFE | 0x1BFE | 0x1BFE | 0x1BFE | 0x1BFE | 0x1BFE | 0x1BFE | 0x1BFE | 0x1BFE | 0x0000 | 0x0000 | 0x0000 | 0x0000 | 0x0000 | 0x0000 | 0x0000 | 0x0000 | 0x0000 | 0x0000 | 0x0000 | 0x0000 | 0x0000 | 0x0000 | 0x0000 | 0x0000 | 0x0000 | 0x0000 | 0x0000 | 0x0000 | 0x0000 | 0x0000 | 0x0000 | 0x0000 | 0x0000 | 0x0000 | 0x0000 | 0x0000 | 0x0000 | 0x0000
 |  |  | pins_mode | 0x1BFE | 0x1BFE | 0x1BFE | 0x1BFE | 0x1BFE | 0x1BFE | 0x1BFE | 0x1BFE | 0x1BFE | 0x1BFE | 0x1BFE | pins_mode |  |  |  |  |  |  |  |  |  |  | pins_pull_up |  |  |  |  |  |  |  |  |  |  | #pins_int |  |  |  |  |  |  |  |  |  |  | #pins_def_val
device |  |  | pins_pull_up | 0x0000 | 0x0000 | 0x0000 | 0x0000 | 0x0000 | 0x0000 | 0x0000 | 0x0000 | 0x0000 | 0x0000 | 0x0000
# nazwa układu | MCP23017 | I2C_Expander_10 | #pins_int | 0x0000 | 0x0000 | 0x0000 | 0x0000 | 0x0000 | 0x0000 | 0x0000 | 0x0000 | 0x0000 | 0x0000 | 0x0000
czas pomiędzy wartość safe a krok 1 [ms] | 500 |  | #pins_def_val | 0x0000 | 0x0000 | 0x0000 | 0x0000 | 0x0000 | 0x0000 | 0x0000 | 0x0000 | 0x0000 | 0x0000 | 0x0000
Czas pomiędzy etap 1, a etap 2 | 10
Czas pomiędzy etap 2, a etap 3 | 0
addr | 0x20
#I2C_Expander_10:wartość safe
device | MCP23017 |  |  |  | 5 | 11 | $E$11
i2c_addr | 0x20 |  |  |  |  |  | $E$1
i2c_num | /dev/i2c-1
pins_mode | 0x1BFE |  |  |  |  | $Q$24 | $Q$23
pins_state | 0x8000 |  |  |  |  | $D$23 | $E$23
time | 500
#I2C_Expander_10:etap 1
device | MCP23017 |  |  |  | 6 | 11 | $F$11
i2c_addr | 0x20 |  |  |  |  |  | $F$1
i2c_num | /dev/i2c-1
pins_mode | 0x1BFE |  |  |  |  | d24 | $F$24
pins_state | 0xE000 |  |  |  |  | d23 | $F$23
pins_pull_up | 0x0000 |  |  |  |  | d25 | $F$25
#pins_int | 0x0000 |  |  |  |  | d26 | $F$26
#pins_def_val | 0x0000 |  |  |  |  | d27 | $F$27
time | 10
#I2C_Expander_10:etap 2
device | MCP23017 |  |  |  | 7 | 11 | $G$11
i2c_addr | 0x20 |  |  |  |  |  | $G$1
i2c_num | /dev/i2c-1
pins_mode | 0x1BFE |  |  |  |  | d24 | $G$24
pins_state | 0xE401 |  |  |  |  | d23 | $G$23
pins_pull_up | 0x0000 |  |  |  |  | d25 | $G$25
#pins_int | 0x0000 |  |  |  |  | d26 | $G$26
#pins_def_val | 0x0000 |  |  |  |  | d27 | $G$27
#pins_int | 10
#I2C_Expander_10:etap 3
device | MCP23017 |  |  |  | 8 | 11 | $H$11
i2c_addr | 0x20 |  |  |  |  |  | $H$1
i2c_num | /dev/i2c-1
pins_mode | 0x1BFE |  |  |  |  | d24 | $H$24
pins_state | 0xE401 |  |  |  |  | d23 | $H$23
pins_pull_up | 0x0000 |  |  |  |  | d25 | $H$25
#pins_int | 0x0000 |  |  |  |  | d26 | $H$26
#pins_def_val | 0x0000 |  |  |  |  | d27 | $H$27
#pins_int | 10
#I2C_Expander_10:etap 4 złacze En_SPI_PCIE2
device | MCP23017 |  |  |  | 9 | 11 | $I$11
i2c_addr | 0x20 |  |  |  |  |  | $I$1
i2c_num | /dev/i2c-1
pins_mode | 0x1BFE |  |  |  |  | d24 | $I$24
pins_state | 0x6401 |  |  |  |  | d23 | $I$23
pins_pull_up | 0x0000 |  |  |  |  | d25 | $I$25
#pins_int | 0x0000 |  |  |  |  | d26 | $I$26
#pins_def_val | 0x0000 |  |  |  |  | d27 | $I$27
#pins_int | 10
#I2C_Expander_10:etap 5
device | MCP23017 |  |  |  | 10 | 11 | $J$11
i2c_addr | 0x20 |  |  |  |  |  | $J$1
i2c_num | /dev/i2c-1
pins_mode | 0x1BFE |  |  |  |  | d24 | $J$24
pins_state | 0xE401 |  |  |  |  | d23 | $J$23
pins_pull_up | 0x0000 |  |  |  |  | d25 | $J$25
#pins_int | 0x0000 |  |  |  |  | d26 | $J$26
#pins_def_val | 0x0000 |  |  |  |  | d27 | $J$27
#pins_int | 10
#I2C_Expander_10:etap 6
device | MCP23017 |  |  |  | 11 | 11 | $K$11
i2c_addr | 0x20 |  |  |  |  |  | $K$1
i2c_num | /dev/i2c-1
pins_mode | 0x1BFE |  |  |  |  | d24 | $K$24
pins_state | 0xE401 |  |  |  |  | d23 | $K$23
pins_pull_up | 0x0000 |  |  |  |  | d25 | $K$25
#pins_int | 0x0000 |  |  |  |  | d26 | $K$26
#pins_def_val | 0x0000 |  |  |  |  | d27 | $K$27
#pins_int | 10
#I2C_Expander_10:etap 7
device | MCP23017 |  |  |  | 12 | 11 | $L$11
i2c_addr | 0x20 |  |  |  |  |  | $L$1
i2c_num | /dev/i2c-1
pins_mode | 0x1BFE |  |  |  |  | d24 | $L$24
pins_state | 0xE401 |  |  |  |  | d23 | $L$23
pins_pull_up | 0x0000 |  |  |  |  | d25 | $L$25
#pins_int | 0x0000 |  |  |  |  | d26 | $L$26
#pins_def_val | 0x0000 |  |  |  |  | d27 | $L$27
#pins_int | 10
#I2C_Expander_10:etap 8
device | MCP23017 |  |  |  | 13 | 11 | $M$11
i2c_addr | 0x20 |  |  |  |  |  | $M$1
i2c_num | /dev/i2c-1
pins_mode | 0x1BFE |  |  |  |  | d24 | $M$24
pins_state | 0xE401 |  |  |  |  | d23 | $M$23
pins_pull_up | 0x0000 |  |  |  |  | d25 | $M$25
#pins_int | 0x0000 |  |  |  |  | d26 | $M$26
#pins_def_val | 0x0000 |  |  |  |  | d27 | $M$27
#pins_int | 10
#I2C_Expander_10:etap 9
device | MCP23017 |  |  |  | 14 | 11 | $N$11
i2c_addr | 0x20 |  |  |  |  |  | $N$1
i2c_num | /dev/i2c-1
pins_mode | 0x1BFE |  |  |  |  | d24 | $N$24
pins_state | 0xE401 |  |  |  |  | d23 | $N$23
pins_pull_up | 0x0000 |  |  |  |  | d25 | $N$25
#pins_int | 0x0000 |  |  |  |  | d26 | $N$26
#pins_def_val | 0x0000 |  |  |  |  | d27 | $N$27
#pins_int | 10
#I2C_Expander_10:etap 10
device | MCP23017 |  |  |  | 15 | 11 | $O$11
i2c_addr | 0x20 |  |  |  |  |  | $O$1
i2c_num | /dev/i2c-1
pins_mode | 0x1BFE |  |  |  |  | d24 | $O$24
pins_state | 0xE401 |  |  |  |  | d23 | $O$23
pins_pull_up | 0x0000 |  |  |  |  | d25 | $O$25
#pins_int | 0x0000 |  |  |  |  | d26 | $O$26
#pins_def_val | 0x0000 |  |  |  |  | d27 | $O$27
#pins_int | 10

Sheet: I2C_expander_11
 | port | opis pinu na schemacie | komentarz | wartość safe | etap 1 | etap 2 | LTC6952_2 | LMK05028 | etap 5- Karty | etap 6- En_SPI_PCIE1 | etap 7 En_PCIE4 | etap 8 | etap 9 | etap 10 | pins_mode 0 - out | pins_mode etap1 | pins_mode etap2 | pins_mode etap3 | pins_mode etap4 | pins_mode etap5 | pins_mode etap6 | pins_mode etap7 | pins_mode etap8 | pins_mode etap9 | pins_mode etap10 | pins_pull_up 1 - enable | pins_pull_up etap 1 | pins_pull_up etap 2 | pins_pull_up etap 3 | pins_pull_up etap 4 | pins_pull_up etap 5 | pins_pull_up etap 6 | pins_pull_up etap 7 | pins_pull_up etap 8 | pins_pull_up etap 9 | pins_pull_up etap 10 | pin_int safe 1 - enable | pin_int etap 1 | pin_int etap 2 | pin_int etap 3 | pin_int etap 4 | pin_int etap 5 | pin_int etap 6 | pin_int etap 7 | pin_int etap 8 | pin_int etap 9 | pin_int etap 10 | Pin_def_state
 | GPA0 | CTRL_SPI_A.En_SPI_Q1 | wyłączanie komunikacji z kartą podłączoną do PCIE_1 | 1 | 1 | 1 | 1 | 1 | 1 | 0 | 1 | 1 | 1 | 1 | 0 | 0 | 0 | 0 | 0 | 0 | 0 | 0 | 0 | 0 | 0 | 0 | 0 | 0 | 0 | 0 | 0 | 0 | 0 | 0 | 0 | 0 | 0 | 0 | 0 | 0 | 0 | 0 | 0 | 0 | 0 | 0 | 0 | 0 | 0 | 0 | 0 | 0 | 0 | 0 | 0
 | GPA1 | PCIE_Resets.PCIE_Resets_1 | sygnał reset dla karty w złączu 1 | 0 | 1 | 1 | 1 | 1 | 1 | 1 | 1 | 1 | 1 | 1 | 0 | 0 | 0 | 0 | 0 | 0 | 0 | 0 | 0 | 0 | 0 | 0 | 0 | 0 | 0 | 0 | 0 | 0 | 0 | 0 | 0 | 0 | 0 | 0 | 0 | 0 | 0 | 0 | 0 | 0 | 0 | 0 | 0 | 0 | 0 | 0 | 0 | 0 | 0 | 0 | 0
 | GPA2 | Ctrl_Pwr_4HiSpeed.EN_PWR_PCIE_1 | wlązanie 12V dla karty w złączu PCIE_1 | 0 | 0 | 1 | 1 | 1 | 1 | 1 | 1 | 1 | 1 | 1 | 0 | 0 | 0 | 0 | 0 | 0 | 0 | 0 | 0 | 0 | 0 | 0 | 0 | 0 | 0 | 0 | 0 | 0 | 0 | 0 | 0 | 0 | 0 | 0 | 0 | 0 | 0 | 0 | 0 | 0 | 0 | 0 | 0 | 0 | 0 | 0 | 0 | 0 | 0 | 0 | 0
 | GPA3 | CTRL_SPI_B.En_SPI_Q0 | wyłączanie komunikacji z buforami dla kart PCIE | 1 | 1 | 1 | 1 | 1 | 0 | 0 | 0 | 0 | 0 | 0 | 0 | 0 | 0 | 0 | 0 | 0 | 0 | 0 | 0 | 0 | 0 | 0 | 0 | 0 | 0 | 0 | 0 | 0 | 0 | 0 | 0 | 0 | 0 | 0 | 0 | 0 | 0 | 0 | 0 | 0 | 0 | 0 | 0 | 0 | 0 | 0 | 0 | 0 | 0 | 0 | 0
 | GPA4 | nc |  | 0 | 0 | 0 | 0 | 0 | 0 | 0 | 0 | 0 | 0 | 0 | 1 | 1 | 1 | 1 | 1 | 1 | 1 | 1 | 1 | 1 | 1 | 0 | 0 | 0 | 0 | 0 | 0 | 0 | 0 | 0 | 0 | 0 | 0 | 0 | 0 | 0 | 0 | 0 | 0 | 0 | 0 | 0 | 0 | 0 | 0 | 0 | 0 | 0 | 0 | 0 | 0
 | GPA5 | CTRL_SPI_B.En_SPI_Q1 | wyłączanie komunikacji z dystrybutorem LTC6952_2 | 1 | 1 | 1 | 0 | 1 | 1 | 1 | 1 | 1 | 1 | 1 | 0 | 0 | 0 | 0 | 0 | 0 | 0 | 0 | 0 | 0 | 0 | 0 | 0 | 0 | 0 | 0 | 0 | 0 | 0 | 0 | 0 | 0 | 0 | 0 | 0 | 0 | 0 | 0 | 0 | 0 | 0 | 0 | 0 | 0 | 0 | 0 | 0 | 0 | 0 | 0 | 0
 | GPA6 | nc |  | 0 | 0 | 0 | 0 | 0 | 0 | 0 | 0 | 0 | 0 | 0 | 1 | 1 | 1 | 1 | 1 | 1 | 1 | 1 | 1 | 1 | 1 | 0 | 0 | 0 | 0 | 0 | 0 | 0 | 0 | 0 | 0 | 0 | 0 | 0 | 0 | 0 | 0 | 0 | 0 | 0 | 0 | 0 | 0 | 0 | 0 | 0 | 0 | 0 | 0 | 0 | 0
 | GPA7 | PDN_LMK05028 |  | 1 | 1 | 1 | 1 | 1 | 1 | 1 | 1 | 1 | 1 | 1 | 0 | 0 | 0 | 0 | 0 | 0 | 0 | 0 | 0 | 0 | 0 | 0 | 0 | 0 | 0 | 0 | 0 | 0 | 0 | 0 | 0 | 0 | 0 | 0 | 0 | 0 | 0 | 0 | 0 | 0 | 0 | 0 | 0 | 0 | 0 | 0 | 0 | 0 | 0 | 0 | 0
 |  |  |  | 10101001 | 10101011 | 10101111 | 10001111 | 10101111 | 10100111 | 10100110 | 10100111 | 10100111 | 10100111 | 10100111 | 01010000 | 01010000 | 01010000 | 01010000 | 01010000 | 01010000 | 01010000 | 01010000 | 01010000 | 01010000 | 01010000 | 00000000 | 00000000 | 00000000 | 00000000 | 00000000 | 00000000 | 00000000 | 00000000 | 00000000 | 00000000 | 00000000 | 00000000 | 00000000 | 00000000 | 00000000 | 00000000 | 00000000 | 00000000 | 00000000 | 00000000 | 00000000 | 00000000 | 00000000 | 00000000 | 00000000 | 00000000 | 00000000 | 00000000 | 00000000 | 00000000
 | GPA |  |  | A9 | AB | AF | 8F | AF | A7 | A6 | A7 | A7 | A7 | A7 | 50 | 50 | 50 | 50 | 50 | 50 | 50 | 50 | 50 | 50 | 50 | 00 | 00 | 00 | 00 | 00 | 00 | 00 | 00 | 00 | 00 | 00 | 00 | 00 | 00 | 00 | 00 | 00 | 00 | 00 | 00 | 00 | 00 | 00 | 00 | 00 | 00 | 00 | 00 | 00 | 00
 | GPB0 | CTRL_SPI_A.En_SPI_Q4 | wyłączanie komunikacji z kartą podłączoną do PCIE_4 | 1 | 1 | 1 | 1 | 1 | 1 | 1 | 0 | 1 | 1 | 1 | 0 | 0 | 0 | 0 | 0 | 0 | 0 | 0 | 0 | 0 | 0 | 0 | 0 | 0 | 0 | 0 | 0 | 0 | 0 | 0 | 0 | 0 | 0 | 0 | 0 | 0 | 0 | 0 | 0 | 0 | 0 | 0 | 0 | 0 | 0 | 0 | 0 | 0 | 0 | 0 | 0
 | GPB1 | PCIE_Resets.PCIE_Resets_4 | sygnał reset dla karty w złączu 4 | 0 | 1 | 1 | 1 | 1 | 1 | 1 | 1 | 1 | 1 | 1 | 0 | 0 | 0 | 0 | 0 | 0 | 0 | 0 | 0 | 0 | 0 | 0 | 0 | 0 | 0 | 0 | 0 | 0 | 0 | 0 | 0 | 0 | 0 | 0 | 0 | 0 | 0 | 0 | 0 | 0 | 0 | 0 | 0 | 0 | 0 | 0 | 0 | 0 | 0 | 0 | 0
 | GPB2 | nc |  | 0 | 0 | 0 | 0 | 0 | 0 | 0 | 0 | 0 | 0 | 0 | 1 | 1 | 1 | 1 | 1 | 1 | 1 | 1 | 1 | 1 | 1 | 0 | 0 | 0 | 0 | 0 | 0 | 0 | 0 | 0 | 0 | 0 | 0 | 0 | 0 | 0 | 0 | 0 | 0 | 0 | 0 | 0 | 0 | 0 | 0 | 0 | 0 | 0 | 0 | 0 | 0
 | GPB3 | CTRL_SPI_B.En_SPI_Q4 | wyłączanie komunikacji z dystrybutorem LMK05028 | 1 | 1 | 1 | 1 | 0 | 1 | 1 | 1 | 1 | 1 | 1 | 0 | 0 | 0 | 0 | 0 | 0 | 0 | 0 | 0 | 0 | 0 | 0 | 0 | 0 | 0 | 0 | 0 | 0 | 0 | 0 | 0 | 0 | 0 | 0 | 0 | 0 | 0 | 0 | 0 | 0 | 0 | 0 | 0 | 0 | 0 | 0 | 0 | 0 | 0 | 0 | 0
 | GPB4 | HW_Conf_05028 | ustalanie konfigu | 0 | 0 | 0 | 0 | 0 | 0 | 0 | 0 | 0 | 0 | 0 | 1 | 1 | 1 | 1 | 1 | 1 | 1 | 1 | 1 | 1 | 1 | 0 | 0 | 0 | 0 | 0 | 0 | 0 | 0 | 0 | 0 | 0 | 0 | 0 | 0 | 0 | 0 | 0 | 0 | 0 | 0 | 0 | 0 | 0 | 0 | 0 | 0 | 0 | 0 | 0 | 0
 | GPB5 | nc |  | 0 | 0 | 0 | 0 | 0 | 0 | 0 | 0 | 0 | 0 | 0 | 1 | 1 | 1 | 1 | 1 | 1 | 1 | 1 | 1 | 1 | 1 | 0 | 0 | 0 | 0 | 0 | 0 | 0 | 0 | 0 | 0 | 0 | 0 | 0 | 0 | 0 | 0 | 0 | 0 | 0 | 0 | 0 | 0 | 0 | 0 | 0 | 0 | 0 | 0 | 0 | 0
 | GPB6 | nc |  | 0 | 0 | 0 | 0 | 0 | 0 | 0 | 0 | 0 | 0 | 0 | 1 | 1 | 1 | 1 | 1 | 1 | 1 | 1 | 1 | 1 | 1 | 0 | 0 | 0 | 0 | 0 | 0 | 0 | 0 | 0 | 0 | 0 | 0 | 0 | 0 | 0 | 0 | 0 | 0 | 0 | 0 | 0 | 0 | 0 | 0 | 0 | 0 | 0 | 0 | 0 | 0
 | GPB7 | charge_Cap |  | 0 | 0 | 0 | 0 | 0 | 0 | 0 | 0 | 0 | 0 | 0 | 0 | 0 | 0 | 0 | 0 | 0 | 0 | 0 | 0 | 0 | 0 | 0 | 0 | 0 | 0 | 0 | 0 | 0 | 0 | 0 | 0 | 0 | 0 | 0 | 0 | 0 | 0 | 0 | 0 | 0 | 0 | 0 | 0 | 0 | 0 | 0 | 0 | 0 | 0 | 0 | 0
 |  |  |  | 00001001 | 00001011 | 00001011 | 00001011 | 00000011 | 00001011 | 00001011 | 00001010 | 00001011 | 00001011 | 00001011 | 01110100 | 01110100 | 01110100 | 01110100 | 01110100 | 01110100 | 01110100 | 01110100 | 01110100 | 01110100 | 01110100 | 00000000 | 00000000 | 00000000 | 00000000 | 00000000 | 00000000 | 00000000 | 00000000 | 00000000 | 00000000 | 00000000 | 00000000 | 00000000 | 00000000 | 00000000 | 00000000 | 00000000 | 00000000 | 00000000 | 00000000 | 00000000 | 00000000 | 00000000 | 00000000 | 00000000 | 00000000 | 00000000 | 00000000 | 00000000 | 00000000
 | hex |  | GPA | 09 | 0B | 0B | 0B | 03 | 0B | 0B | 0A | 0B | 0B | 0B | 74 | 74 | 74 | 74 | 74 | 74 | 74 | 74 | 74 | 74 | 74 | 00 | 00 | 00 | 00 | 00 | 00 | 00 | 00 | 00 | 00 | 00 | 00 | 00 | 00 | 00 | 00 | 00 | 00 | 00 | 00 | 00 | 00 | 00 | 00 | 00 | 00 | 00 | 00 | 00 | 00
 |  |  | pins_state | 0x09A9 | 0x0BAB | 0x0BAF | 0x0B8F | 0x03AF | 0x0BA7 | 0x0BA6 | 0x0AA7 | 0x0BA7 | 0x0BA7 | 0x0BA7 | 0x7450 | 0x7450 | 0x7450 | 0x7450 | 0x7450 | 0x7450 | 0x7450 | 0x7450 | 0x7450 | 0x7450 | 0x7450 | 0x0000 | 0x0000 | 0x0000 | 0x0000 | 0x0000 | 0x0000 | 0x0000 | 0x0000 | 0x0000 | 0x0000 | 0x0000 | 0x0000 | 0x0000 | 0x0000 | 0x0000 | 0x0000 | 0x0000 | 0x0000 | 0x0000 | 0x0000 | 0x0000 | 0x0000 | 0x0000 | 0x0000 | 0x0000 | 0x0000 | 0x0000 | 0x0000 | 0x0000 | 0x0000
 |  |  | pins_mode | 0x7450 | 0x7450 | 0x7450 | 0x7450 | 0x7450 | 0x7450 | 0x7450 | 0x7450 | 0x7450 | 0x7450 | 0x7450 | pins_mode |  |  |  |  |  |  |  |  |  |  | pins_pull_up |  |  |  |  |  |  |  |  |  |  | #pins_int |  |  |  |  |  |  |  |  |  |  | #pins_def_val
device |  |  | pins_pull_up | 0x0000 | 0x0000 | 0x0000 | 0x0000 | 0x0000 | 0x0000 | 0x0000 | 0x0000 | 0x0000 | 0x0000 | 0x0000
# nazwa układu | MCP23017 | I2C_Expander_11 | #pins_int | 0x0000 | 0x0000 | 0x0000 | 0x0000 | 0x0000 | 0x0000 | 0x0000 | 0x0000 | 0x0000 | 0x0000 | 0x0000
czas pomiędzy wartość safe a krok 1 [ms] | 500 |  | #pins_def_val | 0x0000 | 0x0000 | 0x0000 | 0x0000 | 0x0000 | 0x0000 | 0x0000 | 0x0000 | 0x0000 | 0x0000 | 0x0000
Czas pomiędzy etap 1, a etap 2 | 10
Czas pomiędzy etap 2, a etap 3 | 0
addr | 0x21
#I2C_Expander_11:wartość safe
device | MCP23017 |  |  |  | 5 | 11 | $E$11
i2c_addr | 0x21 |  |  |  |  |  | $E$1
i2c_num | /dev/i2c-1
pins_mode | 0x7450 |  |  |  |  | $Q$24 | $Q$23
pins_state | 0x09A9 |  |  |  |  | $D$23 | $E$23
time | 500
#I2C_Expander_11:etap 1
device | MCP23017 |  |  |  | 6 | 11 | $F$11
i2c_addr | 0x21 |  |  |  |  |  | $F$1
i2c_num | /dev/i2c-1
pins_mode | 0x7450 |  |  |  |  | d24 | $F$24
pins_state | 0x0BAB |  |  |  |  | d23 | $F$23
pins_pull_up | 0x0000 |  |  |  |  | d25 | $F$25
#pins_int | 0x0000 |  |  |  |  | d26 | $F$26
#pins_def_val | 0x0000 |  |  |  |  | d27 | $F$27
time | 10
#I2C_Expander_11:etap 2
device | MCP23017 |  |  |  | 7 | 11 | $G$11
i2c_addr | 0x21 |  |  |  |  |  | $G$1
i2c_num | /dev/i2c-1
pins_mode | 0x7450 |  |  |  |  | d24 | $G$24
pins_state | 0x0BAF |  |  |  |  | d23 | $G$23
pins_pull_up | 0x0000 |  |  |  |  | d25 | $G$25
#pins_int | 0x0000 |  |  |  |  | d26 | $G$26
#pins_def_val | 0x0000 |  |  |  |  | d27 | $G$27
#pins_int | 10
#I2C_Expander_11:LTC6952_2
device | MCP23017 |  |  |  | 8 | 11 | $H$11
i2c_addr | 0x21 |  |  |  |  |  | $H$1
i2c_num | /dev/i2c-1
pins_mode | 0x7450 |  |  |  |  | d24 | $H$24
pins_state | 0x0B8F |  |  |  |  | d23 | $H$23
pins_pull_up | 0x0000 |  |  |  |  | d25 | $H$25
#pins_int | 0x0000 |  |  |  |  | d26 | $H$26
#pins_def_val | 0x0000 |  |  |  |  | d27 | $H$27
#pins_int | 10
#I2C_Expander_11:LMK05028
device | MCP23017 |  |  |  | 9 | 11 | $I$11
i2c_addr | 0x21 |  |  |  |  |  | $I$1
i2c_num | /dev/i2c-1
pins_mode | 0x7450 |  |  |  |  | d24 | $I$24
pins_state | 0x03AF |  |  |  |  | d23 | $I$23
pins_pull_up | 0x0000 |  |  |  |  | d25 | $I$25
#pins_int | 0x0000 |  |  |  |  | d26 | $I$26
#pins_def_val | 0x0000 |  |  |  |  | d27 | $I$27
#pins_int | 10
#I2C_Expander_11:etap 5- Karty
device | MCP23017 |  |  |  | 10 | 11 | $J$11
i2c_addr | 0x21 |  |  |  |  |  | $J$1
i2c_num | /dev/i2c-1
pins_mode | 0x7450 |  |  |  |  | d24 | $J$24
pins_state | 0x0BA7 |  |  |  |  | d23 | $J$23
pins_pull_up | 0x0000 |  |  |  |  | d25 | $J$25
#pins_int | 0x0000 |  |  |  |  | d26 | $J$26
#pins_def_val | 0x0000 |  |  |  |  | d27 | $J$27
#pins_int | 10
#I2C_Expander_11:etap 6- En_SPI_PCIE1
device | MCP23017 |  |  |  | 11 | 11 | $K$11
i2c_addr | 0x21 |  |  |  |  |  | $K$1
i2c_num | /dev/i2c-1
pins_mode | 0x7450 |  |  |  |  | d24 | $K$24
pins_state | 0x0BA6 |  |  |  |  | d23 | $K$23
pins_pull_up | 0x0000 |  |  |  |  | d25 | $K$25
#pins_int | 0x0000 |  |  |  |  | d26 | $K$26
#pins_def_val | 0x0000 |  |  |  |  | d27 | $K$27
#pins_int | 10
#I2C_Expander_11:etap 7 En_PCIE4
device | MCP23017 |  |  |  | 12 | 11 | $L$11
i2c_addr | 0x21 |  |  |  |  |  | $L$1
i2c_num | /dev/i2c-1
pins_mode | 0x7450 |  |  |  |  | d24 | $L$24
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
