pnpsystemsspzoo/Detekcja-i-lokalizacja-zk-ocen-RF/Sonda_hardware/model_obudowy_sondy/Część1 WYKAZ GWINTOWANIA OTWORÓW .pdf

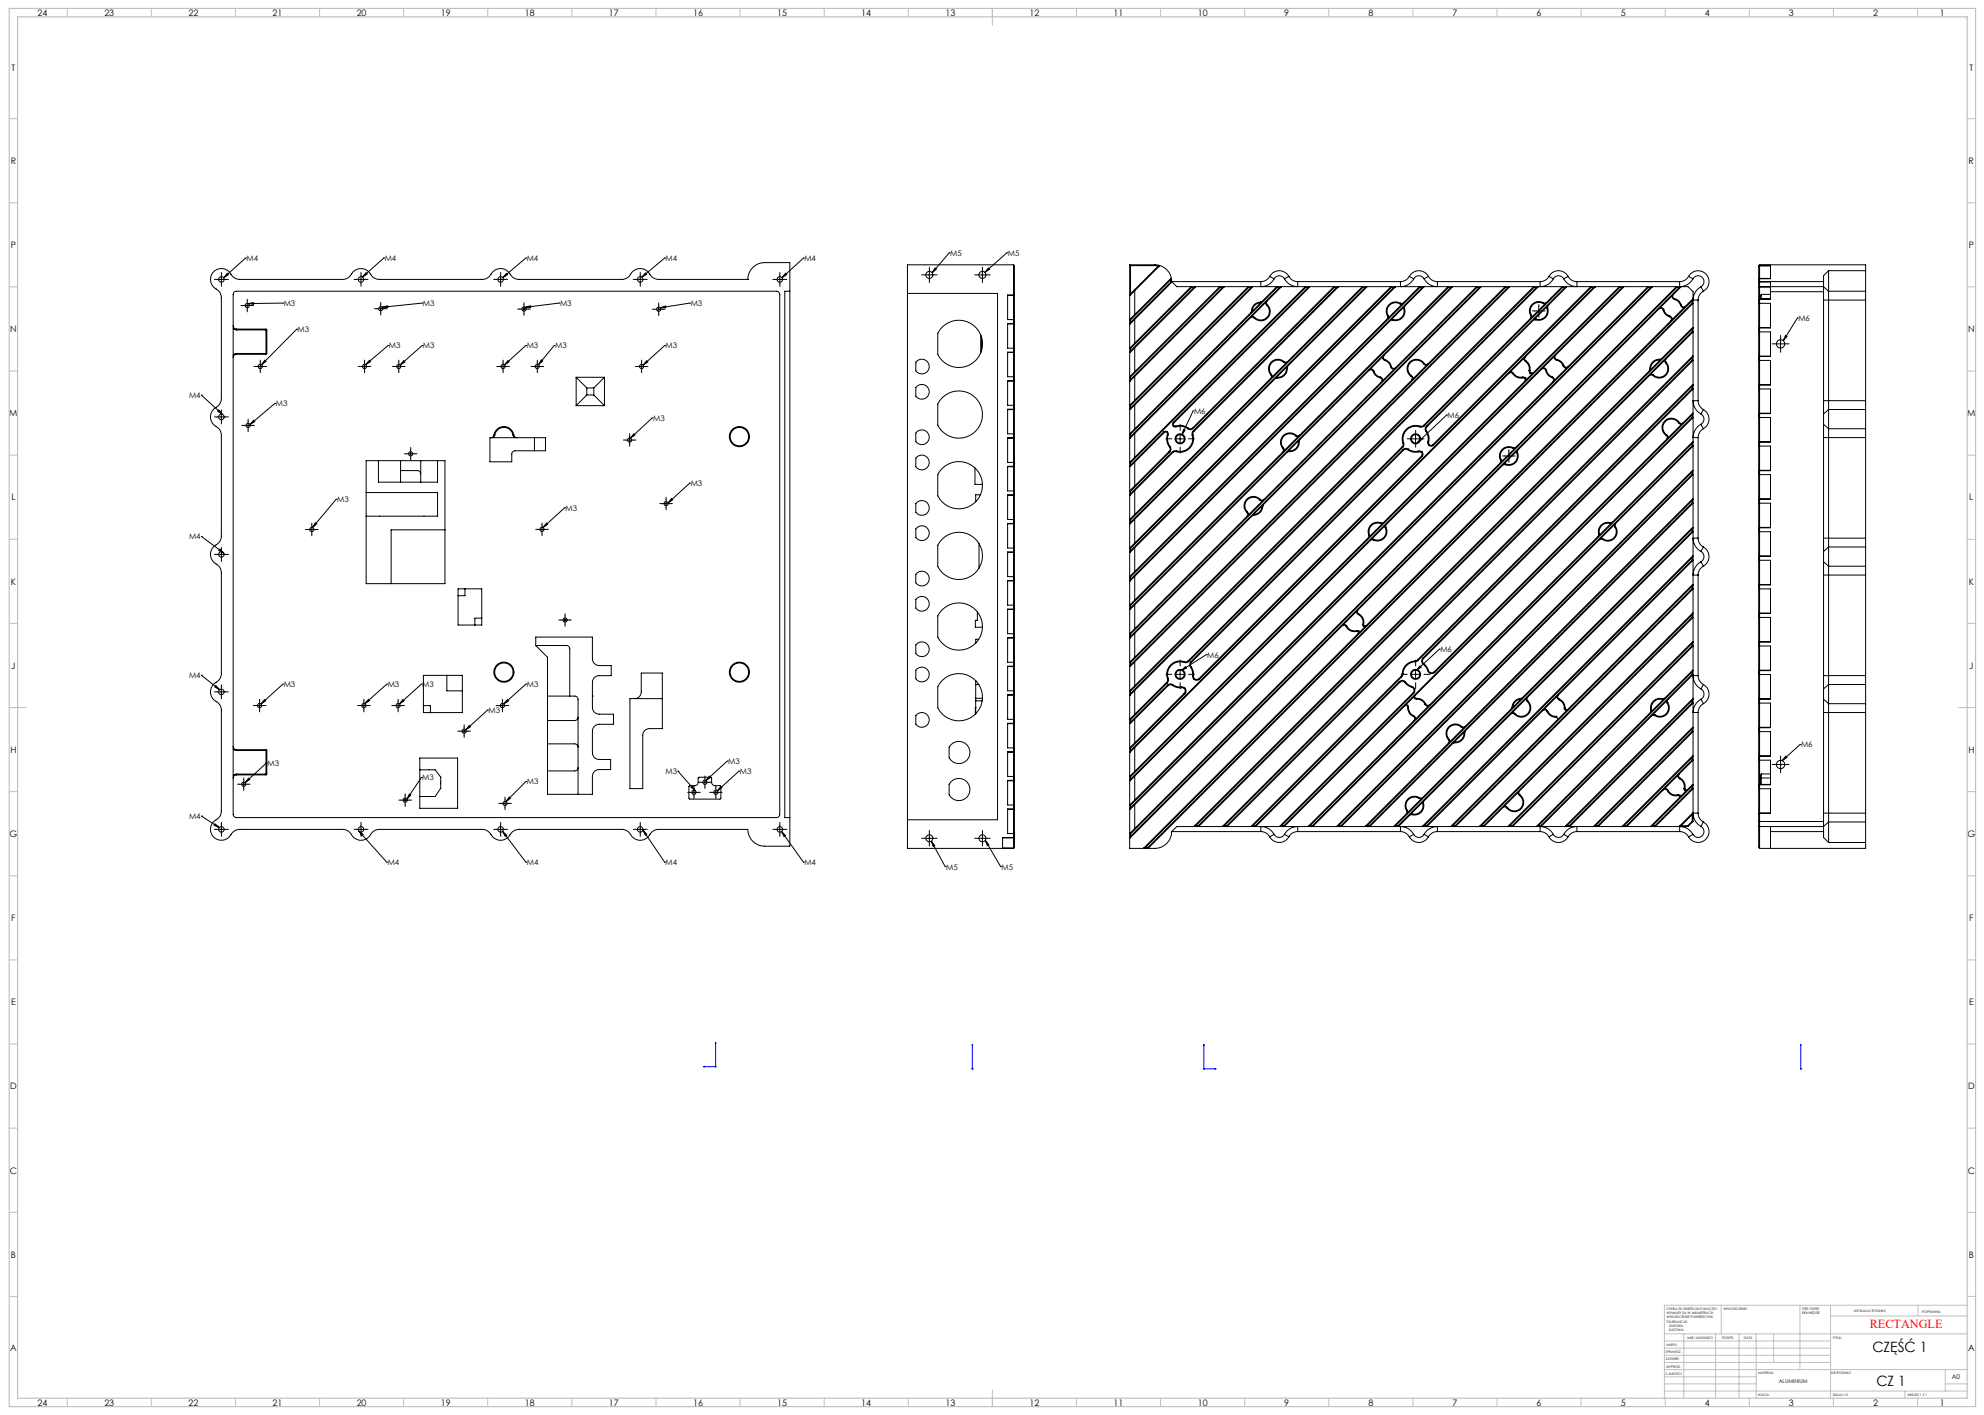
[picture p143: page 1]
WYKOŃCZENIE:; STĘP OSTRE; NIE SKALUJ RYSUNKU; POPRAWKA; SKALA:1:2; ARKUSZ 1 Z 1

CHYBA ŻE OKREŚLONO INACZEJ:
WYMIARY SĄ W MILIMETRACH
WYKOŃCZENIE POWIERZCHNI:
TOLERANCJE:
LINIOWA:
KĄTOWA:

IMIĘ I NAZWISKO | PODPIS | DATA | | | | TYTUŁ: CZĘŚĆ 1

NARYS.
SPRAWDZ.
ZATWIER.
WYPROD.
Z.JAKOŚCI | | | | MATERIAŁ: ALUMINIUM | NR RYSUNKU CZ 1 | A0
