pnpsystemsspzoo/Detekcja-i-lokalizacja-zk-ocen-RF/Dane_badawcze/II_czulosc_detekcji/symulacja_logiczna_sygn_WR/Symulacja_zegarów.asc

A1: dflop
A2: dflop
R1: res; 100
R2: res; 100
R3: res; 100
R4: res; 100
V1: voltage; PULSE(0 3 0 1F 1F 0.000000004 0.000000008 10000000)
V2: voltage; PULSE(0 3 0 1F 1F 0.00000000399609375 0.0000000079921875 10000000)
V3: voltage; PULSE(0 3 0 1F 1F 0.000000004000320026 0.000000008000640051 10000000)
Named nets: 0, Q1, Q2, WR_CLK, 125Mhz, 125Mhz+-
.tran 0 1 0 1p
WR_CLK
125 Mhz
125 Mhz +-
