pnpsystemsspzoo/Detekcja-i-lokalizacja-zk-ocen-RF/(list of files, drawings)

Other design files:
Sonda_hardware/Karta_GNSS_L1/ADC.SchDoc
Sonda_hardware/Karta_GNSS_L1/ATT.SchDoc
Sonda_hardware/Karta_GNSS_L1/Biblioteka.PcbLib
Sonda_hardware/Karta_GNSS_L1/BIblioteka.SchLib
Sonda_hardware/Karta_GNSS_L1/CON_PCI_Express_X4_64PIN.SchDoc
Sonda_hardware/Karta_GNSS_L1/Connector miniPCIe.SchDoc
Sonda_hardware/Karta_GNSS_L1/Current_and_voltage.SchDoc
Sonda_hardware/Karta_GNSS_L1/El_PASYWNE.SchLib
Sonda_hardware/Karta_GNSS_L1/Expander.SchDoc
Sonda_hardware/Karta_GNSS_L1/Flash.SchDoc
Sonda_hardware/Karta_GNSS_L1/Karta Radiowa.PrjPcb
Sonda_hardware/Karta_GNSS_L1/Karta_Radiowa.SchDoc
Sonda_hardware/Karta_GNSS_L1/KartaRfLibs.PcbLib
Sonda_hardware/Karta_GNSS_L1/KartaRfLibs.SchLib
Sonda_hardware/Karta_GNSS_L1/Komunikacja.SchDoc
Sonda_hardware/Karta_GNSS_L1/LED_IND.SchDoc
Sonda_hardware/Karta_GNSS_L1/Pasywne.PcbLib
Sonda_hardware/Karta_GNSS_L1/PCB.PcbDoc
Sonda_hardware/Karta_GNSS_L1/PCI Express Mini L1.PCBDOC
Sonda_hardware/Karta_GNSS_L1/PCI Express Mini L1_V1.PCBDOC
Sonda_hardware/Karta_GNSS_L1/PCI Express Mini L1_V2.PCBDOC
Sonda_hardware/Karta_GNSS_L1/PCI Express_16765X6890_64PIN_Low profile.PCBDOC
Sonda_hardware/Karta_GNSS_L1/PCI Express_16765X6890_64PIN_Low profile_Clear.PCBDOC
Sonda_hardware/Karta_GNSS_L1/Pomiar prądu i napięcia.SchDoc
Sonda_hardware/Karta_GNSS_L1/Tor antenowy.SchDoc
Sonda_hardware/Karta_GNSS_L1/Tor.SchDoc
Sonda_hardware/Karta_GNSS_L1/TorGnss.SchDoc
Sonda_hardware/Karta_GNSS_L1/Zasilanie.SchDoc
Sonda_hardware/Karta_GNSS_L1/Zasilanie_ADC.SchDoc
Sonda_hardware/Karta_GNSS_L1/Zasilanie_LMK.SchDoc
Sonda_hardware/Karta_GNSS_L1/Zasilanie_LTC.SchDoc
Sonda_hardware/Karta_GNSS_L1/Zegar.SchDoc
Sonda_hardware/Karta_ILS/ADC_LTC2122.SchDoc
Sonda_hardware/Karta_ILS/ATT.SchDoc
Sonda_hardware/Karta_ILS/CLOC_DISTR.SchDoc
Sonda_hardware/Karta_ILS/Connector miniPCIe.SchDoc
Sonda_hardware/Karta_ILS/Cover_sheet.SchDoc
Sonda_hardware/Karta_ILS/Current_volatge_meas.SchDoc
Sonda_hardware/Karta_ILS/Flash_memory.SchDoc
Sonda_hardware/Karta_ILS/ILS_TETRA_LIB_P.PcbLib
Sonda_hardware/Karta_ILS/ILS_TETRA_LIB_S.SchLib
Sonda_hardware/Karta_ILS/Karta_ILS.PCBDOC
Sonda_hardware/Karta_ILS/Karta_ILS_TETRA.SchDoc
Sonda_hardware/Karta_ILS/Karta_Radiowa_ILS_TETRA.PrjPcb
Sonda_hardware/Karta_ILS/Komunikacja.SchDoc
Sonda_hardware/Karta_ILS/PCI Express Mini_3000X5095_52PIN_Full-Mini-Type F1.PCBDOC
Sonda_hardware/Karta_ILS/POWER_CLK.SchDoc
Sonda_hardware/Karta_ILS/POWER_DISTRIBUTION.SchDoc
Sonda_hardware/Karta_ILS/RF_ANT.SchDoc
Sonda_hardware/Karta_ILS/RF_LANES.SchDoc
Sonda_hardware/Karta_ILS/Stara wersja zasilania.SchDoc
Sonda_hardware/Karta_ILS/TOR ILS.SchDoc
Sonda_hardware/Karta_ILS/Tor_330MHz.SchDoc
Sonda_hardware/Karta_TETRA/ADC_LTC2122.SchDoc
Sonda_hardware/Karta_TETRA/ATT.SchDoc
Sonda_hardware/Karta_TETRA/CLOC_DISTR.SchDoc
Sonda_hardware/Karta_TETRA/Connector miniPCIe.SchDoc
Sonda_hardware/Karta_TETRA/Current_volatge_meas.SchDoc
Sonda_hardware/Karta_TETRA/Flash_memory.SchDoc
Sonda_hardware/Karta_TETRA/ILS_TETRA_LIB_P.PcbLib
Sonda_hardware/Karta_TETRA/ILS_TETRA_LIB_S.SchLib
Sonda_hardware/Karta_TETRA/Karta_TETRA.PCBDOC
Sonda_hardware/Karta_TETRA/Karta_TETRA.SchDoc
Sonda_hardware/Karta_TETRA/Komunikacja.SchDoc
Sonda_hardware/Karta_TETRA/PCI Express Mini_3000X5095_52PIN_Full-Mini-Type F1.PCBDOC
Sonda_hardware/Karta_TETRA/POWER_ADC.SchDoc
Sonda_hardware/Karta_TETRA/POWER_CLK.SchDoc
Sonda_hardware/Karta_TETRA/POWER_DISTRIBUTION.SchDoc
Sonda_hardware/Karta_TETRA/RF_ANT.SchDoc
Sonda_hardware/Karta_TETRA/RF_LANES.SchDoc
Sonda_hardware/Karta_TETRA/RF_Tetra.PrjPcb
Sonda_hardware/Karta_TETRA/TOR TETRA.SchDoc
Sonda_hardware/Motherboard_Altium/5V_to_3V3.SchDoc
Sonda_hardware/Motherboard_Altium/ADP1741_3.6V_3.3V@2A.SchDoc
Sonda_hardware/Motherboard_Altium/ADP1741_3V3_0V85.SchDoc
Sonda_hardware/Motherboard_Altium/Bank223.SchDoc
Sonda_hardware/Motherboard_Altium/Bank224.SchDoc
Sonda_hardware/Motherboard_Altium/Bank225.SchDoc
Sonda_hardware/Motherboard_Altium/bank226.SchDoc
Sonda_hardware/Motherboard_Altium/CAN.SchDoc
Sonda_hardware/Motherboard_Altium/Charger.SchDoc
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
