pnpsystemsspzoo/Detekcja-i-lokalizacja-zk-ocen-RF/Dane_badawcze/Komunikacja_testy/sources/ADC_LTC2122.cpp

#include "ADC_LTC2122.h"


ADC_LTC2122 :: ADC_LTC2122()
{

}

ADC_LTC2122 :: ~ADC_LTC2122()
{

}

unsigned char ADC_LTC2122 :: Init(void)
{
    unsigned char result = 0;
    return result;
}


unsigned char ADC_LTC2122 :: WriteRegister(unsigned char reg, unsigned char val)
{
    unsigned char result = 0;
    return result;
}

unsigned char ADC_LTC2122 :: ReadData(void)
{
    unsigned char result = 0;
    return result;
}
